Low-Boom/PiEBV/tools/jlc_cpl/rot_report.txt

C1   C49678     C_0805_2012Metric_Pad1.18x1.45mm_Han JLC "C0805" | corr   0 | rot 0 -> 0 | shift 0.000 mm | fit 0.038 mm
C2   C49678     C_0805_2012Metric_Pad1.18x1.45mm_Han JLC "C0805" | corr   0 | rot 0 -> 0 | shift 0.000 mm | fit 0.038 mm
C3   C49678     C_0805_2012Metric_Pad1.18x1.45mm_Han JLC "C0805" | corr   0 | rot 0 -> 0 | shift 0.000 mm | fit 0.038 mm
C4   C49678     C_0805_2012Metric_Pad1.18x1.45mm_Han JLC "C0805" | corr   0 | rot 180 -> 180 | shift 0.000 mm | fit 0.038 mm
C5   C49678     C_0805_2012Metric_Pad1.18x1.45mm_Han JLC "C0805" | corr   0 | rot 180 -> 180 | shift 0.000 mm | fit 0.038 mm
C6   C28323     C_0805_2012Metric_Pad1.18x1.45mm_Han JLC "C0805" | corr   0 | rot 270 -> 270 | shift 0.000 mm | fit 0.038 mm
C7   C28234     C_0805_2012Metric_Pad1.18x1.45mm_Han JLC "C0805" | corr   0 | rot 270 -> 270 | shift 0.000 mm | fit 0.038 mm
C9   C49678     C_0805_2012Metric_Pad1.18x1.45mm_Han JLC "C0805" | corr   0 | rot 180 -> 180 | shift 0.000 mm | fit 0.038 mm
C10  C89632     C_1206_3216Metric_Pad1.33x1.80mm_Han JLC "C1206" | corr   0 | rot 90 -> 90 | shift 0.000 mm | fit 0.030 mm
C11  C28323     C_0805_2012Metric_Pad1.18x1.45mm_Han JLC "C0805" | corr   0 | rot 90 -> 90 | shift 0.000 mm | fit 0.038 mm
C12  C89632     C_1206_3216Metric_Pad1.33x1.80mm_Han JLC "C1206" | corr   0 | rot 0 -> 0 | shift 0.000 mm | fit 0.030 mm
C13  C49678     C_0805_2012Metric_Pad1.18x1.45mm_Han JLC "C0805" | corr   0 | rot 0 -> 0 | shift 0.000 mm | fit 0.038 mm
C14  C45783     C_0805_2012Metric_Pad1.18x1.45mm_Han JLC "C0805" | corr   0 | rot 270 -> 270 | shift 0.000 mm | fit 0.038 mm
C15  C45783     C_0805_2012Metric_Pad1.18x1.45mm_Han JLC "C0805" | corr   0 | rot 270 -> 270 | shift 0.000 mm | fit 0.038 mm
C16  C28323     C_0805_2012Metric_Pad1.18x1.45mm_Han JLC "C0805" | corr   0 | rot 270 -> 270 | shift 0.000 mm | fit 0.038 mm
C17  C89632     C_1206_3216Metric_Pad1.33x1.80mm_Han JLC "C1206" | corr   0 | rot 180 -> 180 | shift 0.000 mm | fit 0.030 mm
C18  C1729      C_0805_2012Metric_Pad1.18x1.45mm_Han JLC "C0805" | corr   0 | rot 270 -> 270 | shift 0.000 mm | fit 0.038 mm
C19  C1710      C_0805_2012Metric_Pad1.18x1.45mm_Han JLC "C0805" | corr   0 | rot 0 -> 0 | shift 0.000 mm | fit 0.038 mm
C20  C49678     C_0805_2012Metric_Pad1.18x1.45mm_Han JLC "C0805" | corr   0 | rot 180 -> 180 | shift 0.000 mm | fit 0.038 mm
J1   C5665      IDC-Header_2x05_P2.54mm_Vertical     JLC "IDC-TH_10P-P2.54_C5665" | corr 270 | rot 270 -> 270 | shift 5.236 mm | fit 0.000 mm
J2   C5665      IDC-Header_2x05_P2.54mm_Vertical     JLC "IDC-TH_10P-P2.54_C5665" | corr 270 | rot 270 -> 270 | shift 5.236 mm | fit 0.000 mm
J3   C5665      IDC-Header_2x05_P2.54mm_Vertical     JLC "IDC-TH_10P-P2.54_C5665" | corr 270 | rot 270 -> 270 | shift 5.236 mm | fit 0.000 mm
J4   C5665      IDC-Header_2x05_P2.54mm_Vertical     JLC "IDC-TH_10P-P2.54_C5665" | corr 270 | rot 270 -> 270 | shift 5.236 mm | fit 0.000 mm
J5   C5665      IDC-Header_2x05_P2.54mm_Vertical     JLC "IDC-TH_10P-P2.54_C5665" | corr 270 | rot 270 -> 270 | shift 5.236 mm | fit 0.000 mm
J6   C5665      IDC-Header_2x05_P2.54mm_Vertical     JLC "IDC-TH_10P-P2.54_C5665" | corr 270 | rot 270 -> 270 | shift 5.236 mm | fit 0.000 mm
J7   C2837587   BNC_Kinghelm_KH-BNC50-3511_Horizonta JLC "ANT-TH_KH-BNC50-3511" | corr 180 | rot 90 -> 90 | shift 2.525 mm | fit 0.042 mm | matched by geometry (pad numbers differ)
J8   C2837587   BNC_Kinghelm_KH-BNC50-3511_Horizonta JLC "ANT-TH_KH-BNC50-3511" | corr 180 | rot 90 -> 90 | shift 2.525 mm | fit 0.042 mm | matched by geometry (pad numbers differ)
J10  C49257     PinHeader_1x03_P2.54mm_Vertical      JLC "?" | corr 270 | rot 0 -> 0 | shift 2.540 mm | fit 0.000 mm
J11  C49257     PinHeader_1x03_P2.54mm_Vertical      JLC "?" | corr 270 | rot 0 -> 0 | shift 2.540 mm | fit 0.000 mm
J12  C2837587   BNC_Kinghelm_KH-BNC50-3511_Horizonta JLC "ANT-TH_KH-BNC50-3511" | corr 180 | rot 90 -> 90 | shift 2.525 mm | fit 0.042 mm | matched by geometry (pad numbers differ)
J14  C2905423   PinSocket_1x20_P2.54mm_Vertical      JLC "HDR-TH_20P-P2.54-V-F-2" | corr 270 | rot 0 -> 0 | shift 24.130 mm | fit 0.000 mm
J15  C2905423   PinSocket_1x20_P2.54mm_Vertical      JLC "HDR-TH_20P-P2.54-V-F-2" | corr 270 | rot 0 -> 0 | shift 24.130 mm | fit 0.000 mm
J17  C283540    USB_C_Receptacle_HRO_TYPE-C-31-M-17_ JLC "USB-C-SMD_10P-P1.00-L6.8-W8.9" | corr   0 | rot 270 -> 270 | shift 1.178 mm | fit 0.072 mm
J18  C49257     PinHeader_1x03_P2.54mm_Vertical      JLC "?" | corr 270 | rot 270 -> 270 | shift 2.540 mm | fit 0.000 mm
J19  C49257     PinHeader_1x03_P2.54mm_Vertical      JLC "?" | corr 270 | rot 90 -> 90 | shift 2.540 mm | fit 0.000 mm
J20  C32713268  PinHeader_1x02_P2.54mm_Vertical      JLC "HDR-TH_2P-P2.54-V-M-3" | corr 270 | rot 90 -> 90 | shift 1.270 mm | fit 0.000 mm
L1   C354587    L_Cenker_CKCS4030                    JLC "IND-SMD_L4.0-W4.0" | corr   0 | rot 0 -> 0 | shift 0.000 mm | fit 0.250 mm  << CHECK
R2   C26010     R_0805_2012Metric_Pad1.20x1.40mm_Han JLC "R0805" | corr   0 | rot 0 -> 0 | shift 0.000 mm | fit 0.000 mm
R3   C26010     R_0805_2012Metric_Pad1.20x1.40mm_Han JLC "R0805" | corr   0 | rot 0 -> 0 | shift 0.000 mm | fit 0.000 mm
R6   C2793964   R_2512_6332Metric_Pad1.40x3.35mm_Han JLC "R2512" | corr   0 | rot 0 -> 0 | shift 0.000 mm | fit 0.016 mm
R7   C2793964   R_2512_6332Metric_Pad1.40x3.35mm_Han JLC "R2512" | corr   0 | rot 0 -> 0 | shift 0.000 mm | fit 0.016 mm
R8   C17414     R_0805_2012Metric_Pad1.20x1.40mm_Han JLC "R0805" | corr   0 | rot 0 -> 0 | shift 0.000 mm | fit 0.000 mm
R9   C17414     R_0805_2012Metric_Pad1.20x1.40mm_Han JLC "R0805" | corr   0 | rot 0 -> 0 | shift 0.000 mm | fit 0.000 mm
R10  C17756     R_0805_2012Metric_Pad1.20x1.40mm_Han JLC "R0805" | corr   0 | rot 0 -> 0 | shift 0.000 mm | fit 0.000 mm
R12  C122537    R_0805_2012Metric_Pad1.20x1.40mm_Han JLC "R0805" | corr   0 | rot 90 -> 90 | shift 0.000 mm | fit 0.000 mm
R13  C706247    R_0805_2012Metric_Pad1.20x1.40mm_Han JLC "R0805" | corr   0 | rot 90 -> 90 | shift 0.000 mm | fit 0.000 mm
R16  C149504    R_0805_2012Metric_Pad1.20x1.40mm_Han JLC "R0805" | corr   0 | rot 270 -> 270 | shift 0.000 mm | fit 0.000 mm
R17  C17414     R_0805_2012Metric_Pad1.20x1.40mm_Han JLC "R0805" | corr   0 | rot 0 -> 0 | shift 0.000 mm | fit 0.000 mm
R18  C17414     R_0805_2012Metric_Pad1.20x1.40mm_Han JLC "R0805" | corr   0 | rot 0 -> 0 | shift 0.000 mm | fit 0.000 mm
R19  C17408     R_0805_2012Metric_Pad1.20x1.40mm_Han JLC "R0805" | corr   0 | rot 0 -> 0 | shift 0.000 mm | fit 0.000 mm
R20  C17818     R_0805_2012Metric_Pad1.20x1.40mm_Han JLC "R0805" | corr   0 | rot 270 -> 270 | shift 0.000 mm | fit 0.000 mm
R21  C17470     R_0805_2012Metric_Pad1.20x1.40mm_Han JLC "R0805" | corr   0 | rot 90 -> 90 | shift 0.000 mm | fit 0.000 mm
R22  C17379     R_0805_2012Metric_Pad1.20x1.40mm_Han JLC "R0805" | corr   0 | rot 90 -> 90 | shift 0.000 mm | fit 0.000 mm
R23  C17673     R_0805_2012Metric_Pad1.20x1.40mm_Han JLC "R0805" | corr   0 | rot 90 -> 90 | shift 0.000 mm | fit 0.000 mm
R24  C17414     R_0805_2012Metric_Pad1.20x1.40mm_Han JLC "R0805" | corr   0 | rot 0 -> 0 | shift 0.000 mm | fit 0.000 mm
R25  C7209419   R_2512_6332Metric_Pad1.40x3.35mm_Han no JLC footprint; chip passive, corr 0 | rot 0 -> 0
R26  C7209419   R_2512_6332Metric_Pad1.40x3.35mm_Han no JLC footprint; chip passive, corr 0 | rot 0 -> 0
R27  C7468298   R_2512_6332Metric_Pad1.40x3.35mm_Han JLC "R2512" | corr   0 | rot 180 -> 180 | shift 0.000 mm | fit 0.016 mm
R28  C7468298   R_2512_6332Metric_Pad1.40x3.35mm_Han JLC "R2512" | corr   0 | rot 180 -> 180 | shift 0.000 mm | fit 0.016 mm
R29  C17513     R_0805_2012Metric_Pad1.20x1.40mm_Han JLC "R0805" | corr   0 | rot 0 -> 0 | shift 0.000 mm | fit 0.000 mm
TP3  C32713261  PinHeader_1x02_P2.54mm_Horizontal_Ed JLC "?" | corr  90 | rot 270 -> 270 | shift 1.270 mm | fit 0.000 mm | symmetric, also fits 270 | matched by geometry (pad numbers differ) | body-matched (JLC pin numbering mirrored vs body; header pins are identical)
U1   C7827      SOT-23-5_HandSoldering               JLC "SOT-23-5_L3.0-W1.7-P0.95-LS2.8-BR" | corr 180 | rot 180 -> 180 | shift 0.010 mm | fit 0.060 mm
U2   C485074    SOIC127P600X175-14N                  JLC "SOIC-14_L8.7-W3.9-P1.27-LS6.0-BL" | corr 270 | rot 270 -> 270 | shift 0.000 mm | fit 0.144 mm
U3   C7826      SOT-23-5_HandSoldering               JLC "SOT-23-5_L3.0-W1.7-P0.95-LS2.8-BR" | corr 180 | rot 180 -> 180 | shift 0.010 mm | fit 0.060 mm
U4   C485074    SOIC127P600X175-14N                  JLC "SOIC-14_L8.7-W3.9-P1.27-LS6.0-BL" | corr 270 | rot 270 -> 270 | shift 0.000 mm | fit 0.144 mm
U5   C7827      SOT-23-5_HandSoldering               JLC "SOT-23-5_L3.0-W1.7-P0.95-LS2.8-BR" | corr 180 | rot 180 -> 180 | shift 0.010 mm | fit 0.060 mm
U6   C485074    SOIC127P600X175-14N                  JLC "SOIC-14_L8.7-W3.9-P1.27-LS6.0-BL" | corr 270 | rot 270 -> 270 | shift 0.000 mm | fit 0.144 mm
U7   C113521    SOT-23-5_HandSoldering               JLC "SOT-23-5_L3.0-W1.7-P0.95-LS2.8-BR" | corr 180 | rot 180 -> 180 | shift 0.010 mm | fit 0.060 mm
U8   C113521    SOT-23-5_HandSoldering               JLC "SOT-23-5_L3.0-W1.7-P0.95-LS2.8-BR" | corr 180 | rot 180 -> 180 | shift 0.010 mm | fit 0.060 mm
U9   C892792    SOT-23-5_HandSoldering               JLC "TSOT-23-5_L2.9-W1.6-P0.95-LS2.8-BL" | corr 270 | rot 270 -> 270 | shift 0.040 mm | fit 0.243 mm  << CHECK
U10  C113521    SOT-23-5_HandSoldering               JLC "SOT-23-5_L3.0-W1.7-P0.95-LS2.8-BR" | corr 180 | rot 180 -> 180 | shift 0.010 mm | fit 0.060 mm
U13  C465729    SOIC-8_3.9x4.9mm_P1.27mm             JLC "?" | corr 270 | rot 270 -> 270 | shift 0.000 mm | fit 0.125 mm
U14  C42459160  SSOP-10-1EP_3.9x4.9mm_P1mm_EP2.1x3.3 JLC "ESSOP-10_L4.9-W3.9-P1.0-LS6.0-TL-E" | corr 270 | rot 90 -> 90 | shift 0.000 mm | fit 0.363 mm  << CHECK
U15  C2071056   TSOT-23-6_HandSoldering              JLC "TSOT-23-6_L2.9-W1.6-P0.95-LS2.8-BL" | corr 270 | rot 270 -> 270 | shift 0.000 mm | fit 0.510 mm  << CHECK
U16  C2869734   SOT-363_SC-70-6                      JLC "SC-70-6_L2.0-W1.3-P0.65-LS2.1-BL" | corr 270 | rot 270 -> 270 | shift 0.000 mm | fit 0.263 mm  << CHECK
U17  C670156    MSOP-12-1EP_3x4.039mm_P0.65mm_EP1.65 JLC "MSOP-12_L4.0-W3.0-P0.65-LS5.0-BL-E" | corr 270 | rot 0 -> 0 | shift 0.000 mm | fit 0.025 mm
U18  C33002     SOT-23-6                             JLC "SOT-23-6_L2.9-W1.6-P0.95-LS2.8-BL" | corr 270 | rot 0 -> 0 | shift 0.000 mm | fit 0.012 mm
U19  C465729    SOIC-8_3.9x4.9mm_P1.27mm             JLC "?" | corr 270 | rot 270 -> 270 | shift 0.000 mm | fit 0.125 mm
C21  C49678     C_0805_2012Metric_Pad1.18x1.45mm_Han JLC "C0805" | corr   0 | rot 180 -> 180 | shift 0.000 mm | fit 0.038 mm
C22  C89632     C_1206_3216Metric_Pad1.33x1.80mm_Han JLC "C1206" | corr   0 | rot 90 -> 90 | shift 0.000 mm | fit 0.030 mm
R30  C2793964   R_2512_6332Metric_Pad1.40x3.35mm_Han JLC "R2512" | corr   0 | rot 0 -> 0 | shift 0.000 mm | fit 0.016 mm
R31  C7209419   R_2512_6332Metric_Pad1.40x3.35mm_Han no JLC footprint; chip passive, corr 0 | rot 0 -> 0
R32  C7468298   R_2512_6332Metric_Pad1.40x3.35mm_Han JLC "R2512" | corr   0 | rot 180 -> 180 | shift 0.000 mm | fit 0.016 mm
J21  C49257     PinHeader_1x03_P2.54mm_Vertical      JLC "?" | corr 270 | rot 270 -> 270 | shift 2.540 mm | fit 0.000 mm
C23  C28323     C_0805_2012Metric_Pad1.18x1.45mm_Han JLC "C0805" | corr   0 | rot 180 -> 180 | shift 0.000 mm | fit 0.038 mm
C24  C28323     C_0805_2012Metric_Pad1.18x1.45mm_Han JLC "C0805" | corr   0 | rot 270 -> 270 | shift 0.000 mm | fit 0.038 mm
C25  C49678     C_0805_2012Metric_Pad1.18x1.45mm_Han JLC "C0805" | corr   0 | rot 90 -> 90 | shift 0.000 mm | fit 0.038 mm
C26  C49678     C_0805_2012Metric_Pad1.18x1.45mm_Han JLC "C0805" | corr   0 | rot 0 -> 0 | shift 0.000 mm | fit 0.038 mm
C27  C49678     C_0805_2012Metric_Pad1.18x1.45mm_Han JLC "C0805" | corr   0 | rot 90 -> 90 | shift 0.000 mm | fit 0.038 mm
C28  C49678     C_0805_2012Metric_Pad1.18x1.45mm_Han JLC "C0805" | corr   0 | rot 0 -> 0 | shift 0.000 mm | fit 0.038 mm
C29  C49678     C_0805_2012Metric_Pad1.18x1.45mm_Han JLC "C0805" | corr   0 | rot 90 -> 90 | shift 0.000 mm | fit 0.038 mm
C30  C49678     C_0805_2012Metric_Pad1.18x1.45mm_Han JLC "C0805" | corr   0 | rot 0 -> 0 | shift 0.000 mm | fit 0.038 mm
C31  C1792      C_0805_2012Metric_Pad1.18x1.45mm_Han JLC "C0805" | corr   0 | rot 90 -> 90 | shift 0.000 mm | fit 0.038 mm
C32  C1804      C_0805_2012Metric_Pad1.18x1.45mm_Han JLC "C0805" | corr   0 | rot 270 -> 270 | shift 0.000 mm | fit 0.038 mm
C33  C1792      C_0805_2012Metric_Pad1.18x1.45mm_Han JLC "C0805" | corr   0 | rot 270 -> 270 | shift 0.000 mm | fit 0.038 mm
C34  C1804      C_0805_2012Metric_Pad1.18x1.45mm_Han JLC "C0805" | corr   0 | rot 90 -> 90 | shift 0.000 mm | fit 0.038 mm
C35  C1792      C_0805_2012Metric_Pad1.18x1.45mm_Han JLC "C0805" | corr   0 | rot 90 -> 90 | shift 0.000 mm | fit 0.038 mm
C36  C1804      C_0805_2012Metric_Pad1.18x1.45mm_Han JLC "C0805" | corr   0 | rot 90 -> 90 | shift 0.000 mm | fit 0.038 mm
D1   C2293      LED_0805_2012Metric_Pad1.15x1.40mm_H JLC "LED0805-R-RD" | corr 180 | rot 270 -> 90 | shift 0.000 mm | fit 0.025 mm
D2   C2297      LED_0805_2012Metric_Pad1.15x1.40mm_H JLC "LED0805-R-RD" | corr 180 | rot 180 -> 0 | shift 0.000 mm | fit 0.025 mm
D3   C84256     LED_0805_2012Metric_Pad1.15x1.40mm_H JLC "LED0805-RD" | corr   0 | rot 0 -> 0 | shift 0.000 mm | fit 0.075 mm
D4   C84256     LED_0805_2012Metric_Pad1.15x1.40mm_H JLC "LED0805-RD" | corr   0 | rot 0 -> 0 | shift 0.000 mm | fit 0.075 mm
D5   C84256     LED_0805_2012Metric_Pad1.15x1.40mm_H JLC "LED0805-RD" | corr   0 | rot 0 -> 0 | shift 0.000 mm | fit 0.075 mm
D6   C2296      LED_0805_2012Metric_Pad1.15x1.40mm_H JLC "LED0805-R-RD" | corr 180 | rot 0 -> 180 | shift 0.000 mm | fit 0.025 mm
J22  C32713268  PinHeader_1x02_P2.54mm_Vertical      JLC "HDR-TH_2P-P2.54-V-M-3" | corr 270 | rot 270 -> 270 | shift 1.270 mm | fit 0.000 mm
Q1   C8545      SOT-23                               JLC "SOT-23-3_L2.9-W1.3-P1.90-LS2.4-BR" | corr 180 | rot 90 -> 270 | shift 0.021 mm | fit 0.083 mm
Q2   C8545      SOT-23                               JLC "SOT-23-3_L2.9-W1.3-P1.90-LS2.4-BR" | corr 180 | rot 90 -> 270 | shift 0.021 mm | fit 0.083 mm
R33  C17408     R_0805_2012Metric_Pad1.20x1.40mm_Han JLC "R0805" | corr   0 | rot 90 -> 90 | shift 0.000 mm | fit 0.000 mm
R34  C17414     R_0805_2012Metric_Pad1.20x1.40mm_Han JLC "R0805" | corr   0 | rot 0 -> 0 | shift 0.000 mm | fit 0.000 mm
R35  C17513     R_0805_2012Metric_Pad1.20x1.40mm_Han JLC "R0805" | corr   0 | rot 180 -> 180 | shift 0.000 mm | fit 0.000 mm
R36  C17513     R_0805_2012Metric_Pad1.20x1.40mm_Han JLC "R0805" | corr   0 | rot 90 -> 90 | shift 0.000 mm | fit 0.000 mm
R37  C17513     R_0805_2012Metric_Pad1.20x1.40mm_Han JLC "R0805" | corr   0 | rot 90 -> 90 | shift 0.000 mm | fit 0.000 mm
R38  C149504    R_0805_2012Metric_Pad1.20x1.40mm_Han JLC "R0805" | corr   0 | rot 270 -> 270 | shift 0.000 mm | fit 0.000 mm
R39  C17414     R_0805_2012Metric_Pad1.20x1.40mm_Han JLC "R0805" | corr   0 | rot 90 -> 90 | shift 0.000 mm | fit 0.000 mm
R40  C17673     R_0805_2012Metric_Pad1.20x1.40mm_Han JLC "R0805" | corr   0 | rot 270 -> 270 | shift 0.000 mm | fit 0.000 mm
R41  C17470     R_0805_2012Metric_Pad1.20x1.40mm_Han JLC "R0805" | corr   0 | rot 90 -> 90 | shift 0.000 mm | fit 0.000 mm
R42  C17818     R_0805_2012Metric_Pad1.20x1.40mm_Han JLC "R0805" | corr   0 | rot 0 -> 0 | shift 0.000 mm | fit 0.000 mm
R43  C17414     R_0805_2012Metric_Pad1.20x1.40mm_Han JLC "R0805" | corr   0 | rot 270 -> 270 | shift 0.000 mm | fit 0.000 mm
R44  C17673     R_0805_2012Metric_Pad1.20x1.40mm_Han JLC "R0805" | corr   0 | rot 90 -> 90 | shift 0.000 mm | fit 0.000 mm
R45  C17470     R_0805_2012Metric_Pad1.20x1.40mm_Han JLC "R0805" | corr   0 | rot 90 -> 90 | shift 0.000 mm | fit 0.000 mm
R46  C17818     R_0805_2012Metric_Pad1.20x1.40mm_Han JLC "R0805" | corr   0 | rot 0 -> 0 | shift 0.000 mm | fit 0.000 mm
R47  C17414     R_0805_2012Metric_Pad1.20x1.40mm_Han JLC "R0805" | corr   0 | rot 90 -> 90 | shift 0.000 mm | fit 0.000 mm
R48  C17673     R_0805_2012Metric_Pad1.20x1.40mm_Han JLC "R0805" | corr   0 | rot 90 -> 90 | shift 0.000 mm | fit 0.000 mm
R49  C17470     R_0805_2012Metric_Pad1.20x1.40mm_Han JLC "R0805" | corr   0 | rot 90 -> 90 | shift 0.000 mm | fit 0.000 mm
R50  C17818     R_0805_2012Metric_Pad1.20x1.40mm_Han JLC "R0805" | corr   0 | rot 0 -> 0 | shift 0.000 mm | fit 0.000 mm
R51  C17673     R_0805_2012Metric_Pad1.20x1.40mm_Han JLC "R0805" | corr   0 | rot 0 -> 0 | shift 0.000 mm | fit 0.000 mm
R52  C17714     R_0805_2012Metric_Pad1.20x1.40mm_Han JLC "R0805" | corr   0 | rot 90 -> 90 | shift 0.000 mm | fit 0.000 mm
R53  C17714     R_0805_2012Metric_Pad1.20x1.40mm_Han JLC "R0805" | corr   0 | rot 90 -> 90 | shift 0.000 mm | fit 0.000 mm
R54  C17714     R_0805_2012Metric_Pad1.20x1.40mm_Han JLC "R0805" | corr   0 | rot 90 -> 90 | shift 0.000 mm | fit 0.000 mm
R55  C17714     R_0805_2012Metric_Pad1.20x1.40mm_Han JLC "R0805" | corr   0 | rot 90 -> 90 | shift 0.000 mm | fit 0.000 mm
R56  C17714     R_0805_2012Metric_Pad1.20x1.40mm_Han JLC "R0805" | corr   0 | rot 90 -> 90 | shift 0.000 mm | fit 0.000 mm
R57  C17714     R_0805_2012Metric_Pad1.20x1.40mm_Han JLC "R0805" | corr   0 | rot 90 -> 90 | shift 0.000 mm | fit 0.000 mm
R58  C17714     R_0805_2012Metric_Pad1.20x1.40mm_Han JLC "R0805" | corr   0 | rot 90 -> 90 | shift 0.000 mm | fit 0.000 mm
R59  C17714     R_0805_2012Metric_Pad1.20x1.40mm_Han JLC "R0805" | corr   0 | rot 90 -> 90 | shift 0.000 mm | fit 0.000 mm
R60  C17714     R_0805_2012Metric_Pad1.20x1.40mm_Han JLC "R0805" | corr   0 | rot 90 -> 90 | shift 0.000 mm | fit 0.000 mm
R61  C17714     R_0805_2012Metric_Pad1.20x1.40mm_Han JLC "R0805" | corr   0 | rot 90 -> 90 | shift 0.000 mm | fit 0.000 mm
R62  C17714     R_0805_2012Metric_Pad1.20x1.40mm_Han JLC "R0805" | corr   0 | rot 90 -> 90 | shift 0.000 mm | fit 0.000 mm
R63  C17714     R_0805_2012Metric_Pad1.20x1.40mm_Han JLC "R0805" | corr   0 | rot 90 -> 90 | shift 0.000 mm | fit 0.000 mm
R64  C17714     R_0805_2012Metric_Pad1.20x1.40mm_Han JLC "R0805" | corr   0 | rot 270 -> 270 | shift 0.000 mm | fit 0.000 mm
R65  C17714     R_0805_2012Metric_Pad1.20x1.40mm_Han JLC "R0805" | corr   0 | rot 270 -> 270 | shift 0.000 mm | fit 0.000 mm
R66  C17714     R_0805_2012Metric_Pad1.20x1.40mm_Han JLC "R0805" | corr   0 | rot 270 -> 270 | shift 0.000 mm | fit 0.000 mm
R67  C17714     R_0805_2012Metric_Pad1.20x1.40mm_Han JLC "R0805" | corr   0 | rot 270 -> 270 | shift 0.000 mm | fit 0.000 mm
R68  C17714     R_0805_2012Metric_Pad1.20x1.40mm_Han JLC "R0805" | corr   0 | rot 270 -> 270 | shift 0.000 mm | fit 0.000 mm
R69  C17714     R_0805_2012Metric_Pad1.20x1.40mm_Han JLC "R0805" | corr   0 | rot 270 -> 270 | shift 0.000 mm | fit 0.000 mm
R70  C17414     R_0805_2012Metric_Pad1.20x1.40mm_Han JLC "R0805" | corr   0 | rot 0 -> 0 | shift 0.000 mm | fit 0.000 mm
U20  C3235557   SOT-583-8                            JLC "SOT-583-8_L2.1-W1.6-P0.50-LS1.6-BL" | corr 270 | rot 180 -> 90 | shift 0.000 mm | fit 0.100 mm
U21  C123302    SSOP-8_2.95x2.8mm_P0.65mm            JLC "SM8_L3.2-W2.9-P0.65-LS4.3-BR" | corr 180 | rot 180 -> 0 | shift 0.000 mm | fit 0.099 mm
U22  C123302    SSOP-8_2.95x2.8mm_P0.65mm            JLC "SM8_L3.2-W2.9-P0.65-LS4.3-BR" | corr 180 | rot 180 -> 0 | shift 0.000 mm | fit 0.099 mm
U23  C123302    SSOP-8_2.95x2.8mm_P0.65mm            JLC "SM8_L3.2-W2.9-P0.65-LS4.3-BR" | corr 180 | rot 180 -> 0 | shift 0.000 mm | fit 0.099 mm
