Low-Boom/PiEBV/fab/PiEBV_Pico_BOM.csv

Reference | Value | Footprint | Qty | DNP | LCSC
C1-C5,C9,C13,C20,C21,C25-C30 | 0.1uF 50V X7R | Capacitor_SMD:C_0805_2012Metric_Pad1.18x1.45mm_HandSolder | 15 |  | C49678
C6,C11,C16,C23,C24 | 1uF 50V X7R | Capacitor_SMD:C_0805_2012Metric_Pad1.18x1.45mm_HandSolder | 5 |  | C28323
C7 | 2.2uF 16V X7R | Capacitor_SMD:C_0805_2012Metric_Pad1.18x1.45mm_HandSolder | 1 |  | C28234
C10,C12,C17,C22 | 10uF 50V X7R | Capacitor_SMD:C_1206_3216Metric_Pad1.33x1.80mm_HandSolder | 4 |  | C89632
C14,C15 | 22uF 25V X5R | Capacitor_SMD:C_0805_2012Metric_Pad1.18x1.45mm_HandSolder | 2 |  | C45783
C18 | 22nF 50V X7R | Capacitor_SMD:C_0805_2012Metric_Pad1.18x1.45mm_HandSolder | 1 |  | C1729
C19 | 10nF 50V X7R | Capacitor_SMD:C_0805_2012Metric_Pad1.18x1.45mm_HandSolder | 1 |  | C1710
C31,C33,C35 | 12pF 50V C0G (sense divider compensation, upper) | Capacitor_SMD:C_0805_2012Metric_Pad1.18x1.45mm_HandSolder | 3 |  | C1792
C32,C34,C36 | 22pF 50V C0G (sense divider compensation, lower) | Capacitor_SMD:C_0805_2012Metric_Pad1.18x1.45mm_HandSolder | 3 |  | C1804
L1 | 4.7uH, Isat >= 1.5 A | Inductor_SMD:L_Cenker_CKCS4030 | 1 |  | C354587
R2,R3 | 3k3 | Resistor_SMD:R_0805_2012Metric_Pad1.20x1.40mm_HandSolder | 2 |  | C26010
R6,R7,R30 | 68 1% 2W | Resistor_SMD:R_2512_6332Metric_Pad1.40x3.35mm_HandSolder | 3 |  | C2793964
R25,R26,R31 | 47 1% 2W (Hi-Z mode series: lasers, ext sync) | Resistor_SMD:R_2512_6332Metric_Pad1.40x3.35mm_HandSolder | 3 |  | C7209419
R27,R28,R32 | 82 1% 2W (Hi-Z mode shunt: lasers, ext sync) | Resistor_SMD:R_2512_6332Metric_Pad1.40x3.35mm_HandSolder | 3 |  | C7468298
R8,R9,R17,R18,R24,R34,R39,R43,R47,R70 | 10k | Resistor_SMD:R_0805_2012Metric_Pad1.20x1.40mm_HandSolder | 10 |  | C17414
R10 | 56k | Resistor_SMD:R_0805_2012Metric_Pad1.20x1.40mm_HandSolder | 1 |  | C17756
R12 | 100k 0.1% | Resistor_SMD:R_0805_2012Metric_Pad1.20x1.40mm_HandSolder | 1 |  | C122537
R13 | 5.36k 0.1% | Resistor_SMD:R_0805_2012Metric_Pad1.20x1.40mm_HandSolder | 1 |  | C706247
R16,R38 | 100k | Resistor_SMD:R_0805_2012Metric_Pad1.20x1.40mm_HandSolder | 2 |  | C149504
R19,R33 | 100 | Resistor_SMD:R_0805_2012Metric_Pad1.20x1.40mm_HandSolder | 2 |  | C17408
R20,R42,R46,R50 | 750 1% | Resistor_SMD:R_0805_2012Metric_Pad1.20x1.40mm_HandSolder | 4 |  | C17818
R21,R41,R45,R49 | 150k 1% | Resistor_SMD:R_0805_2012Metric_Pad1.20x1.40mm_HandSolder | 4 |  | C17470
R22 | 1.2k 1% | Resistor_SMD:R_0805_2012Metric_Pad1.20x1.40mm_HandSolder | 1 |  | C17379
R23,R40,R44,R48,R51 | 4.7k 1% | Resistor_SMD:R_0805_2012Metric_Pad1.20x1.40mm_HandSolder | 5 |  | C17673
R52-R69 | 47 1% (camera line series termination) | Resistor_SMD:R_0805_2012Metric_Pad1.20x1.40mm_HandSolder | 18 |  | C17714
R29,R35,R36,R37 | 1k (R29 clock jumper series; R35 J22 series; R36, R37 LED series) | Resistor_SMD:R_0805_2012Metric_Pad1.20x1.40mm_HandSolder | 4 |  | C17513
U1,U5 | 74LVC1G04 | Package_TO_SOT_SMD:SOT-23-5_HandSoldering | 2 |  | C7827
U3 | 74LVC1G00 (SN74LVC1G00DBVR, pixel-reset inverter: both inputs on PIXRST_GATE) | Package_TO_SOT_SMD:SOT-23-5_HandSoldering | 1 |  | C7826
U2,U4,U6 | SN74LVC04AD | SN74LVC04AD:SOIC127P600X175-14N | 3 |  | C485074
U7,U8,U10 | 74AHCT1G08 | Package_TO_SOT_SMD:SOT-23-5_HandSoldering | 3 |  | C113521
U9 | NCP718xSN180 | Package_TO_SOT_SMD:SOT-23-5_HandSoldering | 1 |  | C892792
U13,U19 | UCC27524 | Package_SO:SOIC-8_3.9x4.9mm_P1.27mm | 2 |  | C465729
U14 | CH224A | Package_SO:SSOP-10-1EP_3.9x4.9mm_P1mm_EP2.1x3.3mm | 1 |  | C42459160
U15 | AP63205WU | Package_TO_SOT_SMD:TSOT-23-6_HandSoldering | 1 |  | C2071056
U16 | LM66100DCK | Package_TO_SOT_SMD:SOT-363_SC-70-6 | 1 |  | C2869734
U17 | LT3065EMSE#PBF (Analog Devices, adjustable, MSOP-12 with exposed pad) | Package_SO:MSOP-12-1EP_3x4.039mm_P0.65mm_EP1.651x2.845mm | 1 |  | C670156
U18 | TPS3700DDCR | Package_TO_SOT_SMD:SOT-23-6 | 1 |  | C33002
U20 | TPS2116DRLR (TI power mux, SOT-583; +VCAM = +1V8 or +3V3) | Package_TO_SOT_SMD:SOT-583-8 | 1 |  | C3235557
U21-U23 | SN74LVC1G123DCTR (TI monostable, SSOP-8 / SM8; activity LED pulse stretchers) | Package_SO:SSOP-8_2.95x2.8mm_P0.65mm | 3 |  | C123302
Q1,Q2 | 2N7002 (N-MOSFET, SOT-23; status LED switches) | Package_TO_SOT_SMD:SOT-23 | 2 |  | C8545
D1 | LED blue 0805 (KT-0805B; 3.3 V camera I/O indicator: must be a blue or white InGaN LED, Vf > 2.5 V) | LED_SMD:LED_0805_2012Metric_Pad1.15x1.40mm_HandSolder | 1 |  | C2293
D2 | LED green 0805 (KT-0805G; 12 V good) | LED_SMD:LED_0805_2012Metric_Pad1.15x1.40mm_HandSolder | 1 |  | C2297
D3,D4,D5 | LED red 0805 (NCD0805R1; ARMED, Laser 1 activity, Laser 2 activity) | LED_SMD:LED_0805_2012Metric_Pad1.15x1.40mm_HandSolder | 3 |  | C84256
D6 | LED yellow 0805 (External Sync Out activity) | LED_SMD:LED_0805_2012Metric_Pad1.15x1.40mm_HandSolder | 1 |  | C2296
J1-J6 | Conn_02x05_Odd_Even | Connector_IDC:IDC-Header_2x05_P2.54mm_Vertical | 6 |  | C5665
J7,J8,J12 | BNC 50R Kinghelm KH-BNC50-3511 (Laser 1 / Laser 2 / Ext Sync Out) | PiEBV_Local:BNC_Kinghelm_KH-BNC50-3511_Horizontal | 3 |  | C2837587
J10,J11,J18,J19,J21 | Header 1x03 (J10 trigger select / J11 laser enable / J18, J19 laser output mode / J21 ext sync output mode) | Connector_PinHeader_2.54mm:PinHeader_1x03_P2.54mm_Vertical | 5 |  | C49257
(loose) | Jumper shunt, 2.54 mm 2-pin | - | 7 | Not placed on the board - fit J10 on 2-3, J11 on 1-2 (lasers enabled), J18, J19 and J21 on 1-2 (50 ohm outputs) by hand; keep the sixth shunt loose: J20 stays open (150 MHz) unless that Pico has passed the soak test. J22 stays open (1.8 V camera I/O, IDS); fit the seventh shunt on J22 only for Prophesee EVK4 cameras (3.3 V), with no 1.8 V camera connected. | C100114
J17 | USB-C receptacle 6P power only (HRO TYPE-C-31-M-17) | PiEBV_Local:USB_C_Receptacle_HRO_TYPE-C-31-M-17_EdgeTrim | 1 |  | C283540
TP3 | Header 1x02 right-angle (1MHz sync + GND) | PiEBV_Local:PinHeader_1x02_P2.54mm_Horizontal_EdgeTrim | 1 |  | C32713261
J20,J22 | Header 1x02 (J20 clock jumper: CLK_SEL_JMP + GND; J22 camera I/O level: fitted = 3.3 V) | Connector_PinHeader_2.54mm:PinHeader_1x02_P2.54mm_Vertical | 2 |  | C32713268
J14,J15 | Pico Socket A/B | Connector_PinSocket_2.54mm:PinSocket_1x20_P2.54mm_Vertical | 2 |  | C2905423
U11 | Raspberry Pi Pico 2 W | (no PCB footprint - plugs into J14/J15) | 1 | DNP - socket-mounted, do not place; source module separately
MH1-MH4 | M3 mounting hole | MountingHole:MountingHole_3.2mm_M3 | 4 | Mechanical only - NPTH, nothing to place
TP4-TP9 | Test pad 1.5 mm (+12V, +5V, +3V3, +1V8, +VCAM, GND) | TestPoint:TestPoint_Pad_D1.5mm | 6 | Bare copper pads - no part, nothing to place
NOTE | U9 must be the FIXED 1.8 V NCP718 (NCP718xSN180, e.g. NCP718BSN180T1G or NCP718ASN180T1G) | Sets the camera I/O level. The IDS UE-39B0XCP-E I/O pins are 1.8 V sensor-level; do not substitute a 1.65 V, 1.7 V or 3.3 V option. Rev 2: U9 feeds U20 (VIN2); the 3.3 V level for Prophesee EVK4 comes from the Pico 3V3_OUT through U20 when J22 is fitted.
NOTE | C6 is on +5V, C7 on +1V8 - use X7R, C6 rated >= 10 V | NCP718 needs >= 1 uF ceramic on its output for stability; C7 = 2.2 uF gives margin after DC-bias derating.
NOTE | TP3/J17 use PiEBV_Local *_EdgeTrim footprint variants | Identical part and pad geometry to the stock footprints; only the silkscreen is clipped where the connector reaches the board edge. Order the standard parts.
NOTE | R8 is a fail-safe interlock pull-down | Holds U10 pin 1 low when no jumper is fitted on J11, so the lasers default to DISABLED. R2 (3k3) still wins when the J11 1-2 jumper is fitted.
NOTE | R9 is the J10 trigger-select pull-down | Holds PWM_TRIG_TAP (U5 input) low when no shunt is fitted on J10, so all six camera trigger lines idle low instead of floating.
NOTE | U7/U8/U10 must be AHCT (TTL-input) parts, not LVC | At VCC = 5 V an LVC input needs 0.7 x VCC = 3.5 V to read high; the Pico drives these from 3.3 V GPIOs. AHCT reads high above 2.0 V.
NOTE | R10 = 56k sets the USB PD request to 15 V | CH224A CFG1 table (datasheet Table 5-1): 6k8 = 9 V, 24k = 12 V, 56k = 15 V, 120k = 20 V, 210k = 28 V. Do not leave R10 off - an open CFG1 is outside the table. The laser outputs need a charger that offers 15 V (any USB-PD charger rated over 27 W).
NOTE | U14 must be the CH224A (not the CH224K) | CH224A pin 1 (VHV) and pin 8 (VBUS) connect directly to VBUS_PD by copper, as the WCH CH224K-to-CH224A guide (datasheet 7.2.1) requires; R11/R15 of the CH224K design were removed. Do not fit a CH224K: it is discontinued, and its pin 1 is a 3.6 V VDD pin that VBUS_PD would destroy.
NOTE | R12/R13 must be 0.1 % parts; R6/R7/R30 1 % | They set the 11.8 V driver rail and hence the LDP-V trigger and ext sync amplitude (4.54-5.14 V into 50 ohm with U13/U19 ROH 0-8.5 ohm, window 4.5-5.2 V). With 1 % divider resistors the worst-case corners fall outside the window.
NOTE | U17 must be the ADJUSTABLE LT3065 (LT3065EMSE), not a fixed LT3065-x | R12/R13 (100k/5.36k) set 11.8 V from the 600 mV ADJ reference. R20 (750 ohm) sets a 400 mA current limit and C18 (22 nF) on IMAX is required by the datasheet. Solder the exposed pad (two GND vias under it). By hand: hot air or a hot plate; the vias are tented, so solder cannot be fed through them.
NOTE | C9, C10, C17, C21, C22 see 12 V; C11, C12, C16 see up to 20 V | Use >= 25 V parts for C9/C10/C17/C21/C22 and >= 50 V for C11/C12/C16 (X7R). C12 is the only large cap on VBUS_PD (C11 and C16 are 1 uF each): keep total VBUS capacitance near the USB-C 10 uF sink limit.
NOTE | U16 CE is tied to its VOUT (+5V) | That is TI's always-on reverse-blocking connection. With CE grounded the LM66100 does NOT block reverse current.
NOTE | R17/R18 hold the laser pulse inputs low when the Pico is removed | J17 can power the board with no Pico fitted; without these, U7/U8 inputs would float and an armed interlock could pass spurious laser triggers.
NOTE | R19 (100 ohm) isolates J10 pin 1 from the CH1 laser pulse | With J10 on 1-2 the CH1 GPIO would otherwise also drive the PWM_TRIG_TAP net (U5, R9, U19, ~59 mm; simulated at its earlier ~120 mm: 0.4-1.7 ns later than CH2). Do not replace with 0 ohm.
NOTE | C14/C15 must keep >= 10 uF each at 5 V DC bias | 22 uF 10 V 0805 X5R parts typically keep only 40-50 % at 5 V; 25 V-rated parts keep more. Check the chosen part's DC-bias curve.
NOTE | C9 / C21 (0.1 uF, 50 V) are the local VDD bypass of U13 / U19 | Each sits right beside its driver's pin 6 with its own GND via; keep them populated and next to the drivers.
NOTE | R6/R7/R30 are 2 W 2512 parts (68 ohm 1 %) | An output high into 50 ohm dissipates at most 0.71 W in its resistor (1.45 W at the firmware's worst duty into a shorted BNC). Do not substitute a smaller package.
NOTE | J7/J8/J12 are Kinghelm KH-BNC50-3511 | Footprint PiEBV_Local:BNC_Kinghelm_KH-BNC50-3511_Horizontal: the Amphenol B6252HB-NPP3G-50 pad pattern, which the Kinghelm drawing matches within 0.04 mm (pad 1 = centre contact, pad 2 and posts = GND). 50 ohm only - never the KH-BNC75-3511. Before release, test-fit two loose parts (holes 1.0 mm pins / 2.2 mm posts, as JLC's own KH-BNC50-3511 footprint) and check shell-to-pad-2 continuity: the shell bond is one iron lead and the post housing is PBT plastic.
NOTE | U18 (TPS3700) is the 12 V power-good gate | OUTA/OUTB (LASER_PWR_OK) hold U13 ENA/ENB and U19 ENA/ENB low unless +12V is inside 10.6-13.3 V (R21/R22/R23 = 150k/1.2k/4.7k 1 %, worst case UV trip 10.03-10.78 V and release <= 10.89 V, OV 12.88-13.67 V; at least 0.65 V and 0.82 V outside the 11.54-12.05 V rail band). U17's own PWRGD can only sink 50 uA and is left unconnected.
NOTE | U3 (74LVC1G00) has both inputs on PIXRST_GATE; R24 (10k) pulls the gate to +3V3 | U3 pins 1 and 2 are joined on the board, so U3 inverts the Pico gate (GP16) and through U4 the cameras get TDRSTN = PIXRST_GATE: only the Pico resets the camera pixels. R24 holds the gate high (no reset) whenever the Pico is not driving it.
NOTE | J18/J19/J21 set the output mode of Laser 1 / Laser 2 / Ext Sync Out; R25-R28, R31, R32 are 2 W 2512 parts | Shunt on 1-2 = 50 ohm load (LDP-V), 4.54-5.14 V into 50 ohm. Shunt on 2-3 = Hi-Z load: 47 ohm series + 82 ohm shunt give 4.55-5.08 V open circuit from a ~50 ohm source. Worst case (output held high into a shorted BNC in Hi-Z mode) is 0.51 W in R25/R26/R31; R27/R28/R32 see at most 0.31 W. Do not substitute a smaller package.
NOTE | J20 is the clock jumper: pin 1 = CLK_SEL_JMP (through R29 1k to CLK_SEL = Pico GP10, J14 pad 14), pin 2 = GND | Shunt fitted = 300 MHz overclock, open = the rated 150 MHz; the firmware reads it at every start with the internal pull-up (a fitted shunt reads about 0.1 V through R29). R29 limits the current to about 3.3 mA if a program drives GP10 high while the shunt is fitted (firmware before the clock jumper used GP10 as the SYNC output). Ship and leave it open unless that Pico has passed the soak test (Hardware.md, Clock jumper). Do not add a capacitor on CLK_SEL: a slow rise could read as fitted.
NOTE | U19 drives the J12 Ext Sync Out BNC | U19 (UCC27524, channel A) copies the camera trigger (PWM_TRIG_TAP, set by J10) to J12 through R30 68 ohm and the J21 output-mode block, exactly as U13 drives Laser 1. It runs from +12V and is enabled by LASER_PWR_OK, so J12 is live only with a 15 V PD charger on J17. INB is tied to GND and OUTB is unused.
NOTE | U20 (TPS2116) selects the camera I/O supply +VCAM; J22 open = 1.8 V, J22 fitted = 3.3 V | VIN1 (pin 3) = +1V8 from U9; VIN2 (pin 6) and MODE (pin 5) = +3V3. PR1 (pin 4) threshold 1.0 V (0.92-1.08 V): R34 and R70 (10k each, in parallel) pull it up to +3V3, so the mux passes VIN1 = 1.8 V. A shunt on J22 pulls PR1 to 0.55 V through R35 (1k) and the mux passes VIN2 = 3.3 V. R51 (4.7k) discharges +VCAM.
NOTE | R34 and R70 (10k each) are the 1.8 V default of the camera I/O supply | Each one alone holds PR1 of U20 high. If both are missing or open, PR1 floats and the mux output is not defined. First-board check: +VCAM (TP8) = 1.8 V and D1 dark with J22 open, before an IDS camera is connected.
NOTE | D1 must be a blue (or white) InGaN LED | D1 + R33 (100 ohm) sit on +VCAM. A blue LED (Vf about 2.7-3.1 V) is dark at 1.8 V and lit at 3.3 V. A red, yellow or yellow-green LED (Vf about 1.8-2.1 V) glows at 1.8 V and makes the indicator useless.
NOTE | Q1/Q2, D2, D3: status LEDs | D2 (green) = +12 V in its window (Q1 on LASER_PWR_OK). D3 (red) = ARMED: LASER_EN -> R37 -> D3 -> Q2 (gate = GP17 ARMED_LED, R38 100k to GND) -> Q1, so it lights only with firmware ARMED and J11 closed and 12 V good. 2N7002: Vgs(th) <= 2.5 V, driven from 3.3 V (Q2) and 12 V (Q1, Vgs max 20 V).
NOTE | U21-U23 (74LVC1G123) are the output activity pulse stretchers | Supply +3V3 (VIH 2.0 V; inputs are 5.5 V tolerant). B input from the 12 V driver output through a compensated divider: 10k with 12 pF (C0G) on top, 4.7k with 22 pF (C0G) below: 3.7-3.9 V, 0.8 mA from the driver while its output is high. Keep the capacitor ratio (C_top / C_bot = R_bot / R_top within about 20 %, including about 6-10 pF of input and track capacitance in parallel with C_bot). 150k x 0.1 uF gives about 15 ms per pulse (nominal; not a timing reference). /A = GND, /CLR = +3V3. The timing capacitor is between Cext and Rext/Cext; Cext is not grounded on the board.
