Low-Boom/PiEBV/tools/signal_sim/results.md

# signal_sim results

Generated by `signal_sim.py` from `geometry.json` and `devices.json`. 169 ngspice runs, 11.9 M time points, 224 s. Maximum time step 2.5 ps; board runs shorter than 2.0 mm are lumped LC sections, longer runs are lossless T lines.

All times in ns, voltages in V. Many device values are estimates (see `devices.json` and the README); treat the typical columns as a model result, not a measurement.

## Checks against hand calculations

| quantity | hand calculation | hand | sim | sim - hand |
|---|---|---|---|---|
| J12 high into 50 ohm, high | VDD x 50 / (50 + R30 + ROH) | 5.135 | 5.135 | 0.000 |
| J12 high into 50 ohm, typ | VDD x 50 / (50 + R30 + ROH) | 4.793 | 4.791 | -0.002 |
| J12 high into 50 ohm, low | VDD x 50 / (50 + R30 + ROH) | 4.537 | 4.534 | -0.003 |
| J12 Hi-Z mode into 1 Mohm, high | VDD x Rp / (R30 + ROH + R31 + Rp) | 5.074 | 5.074 | 0.000 |
| J12 Hi-Z mode into 50 ohm, high | Thevenin VDD Rp/(Rs+Rx+Rp) behind (Rs+Rx) parallel Rp | 2.590 | 2.590 | 0.000 |
| J12 Hi-Z mode into 1 Mohm, typ | VDD x Rp / (R30 + ROH + R31 + Rp) | 4.786 | 4.784 | -0.002 |
| J12 Hi-Z mode into 50 ohm, typ | Thevenin VDD Rp/(Rs+Rx+Rp) behind (Rs+Rx) parallel Rp | 2.424 | 2.423 | -0.001 |
| J12 Hi-Z mode into 1 Mohm, low | VDD x Rp / (R30 + ROH + R31 + Rp) | 4.551 | 4.549 | -0.003 |
| J12 Hi-Z mode into 50 ohm, low | Thevenin VDD Rp/(Rs+Rx+Rp) behind (Rs+Rx) parallel Rp | 2.295 | 2.294 | -0.001 |
| J12 load 50 %: 3 m minus 1 m RG-58 | 2 m x 5.05 ns/m | 10.100 | 10.100 | 0.000 |
| first arrival J14.15 -> U5.2 (ideal step, no loads) | sum of run length x Td/mm + 2 via sqrt(LC) | 0.670 | 0.660 | -0.009 |
| first arrival J14.15 -> U19.2 (ideal step, no loads) | sum of run length x Td/mm + 2 via sqrt(LC) | 0.721 | 0.713 | -0.008 |
| U5 model tpd into 30 pF parallel 1 k (typ) | datasheet tpd (est typ 4.1 ns) | 4.100 | 4.100 | 0.000 |
| R30 power while high, 50 ohm mode into 50 ohm, high | VDD^2 x R30 / (ROH + R30 + RL)^2 | 0.710 | 0.710 | 0.000 |
| R30 power while high, 50 ohm mode into a short, high | VDD^2 x R30 / (ROH + R30 + RL)^2 | 2.156 | 2.156 | 0.000 |

Time-step check (typical corner, 4 mA slow): maximum step 2.5 ps against 1.25 ps.

| edge | J12 | J12 half step | difference | camera | camera half step | difference |
|---|---|---|---|---|---|---|
| rise | 21.5330 | 21.5330 | 0.0000 | 11.0280 | 11.0280 | 0.0000 |
| fall | 20.8737 | 20.8737 | 0.0000 | 11.3697 | 11.3698 | 0.0000 |

## Case 1: CH1 versus CH2 skew (R19 and J10)

GP12 and GP13 switch at the same instant t0. Skew = CH1 minus CH2 (positive: CH1 late). U7.2 / U8.2: crossing of the AHCT threshold (1.4 V est; in brackets the skew at 0.8 V and at 2.0 V, the guaranteed band). J7 / J8: 50 % into 50 ohm through 1 m RG-58, all devices typical and identical on both channels, so the J7-J8 skew is from routing and loading only (U13 channel matching, SLUSFA9 tM 1 / 2 ns, comes on top). J10 'open' and '2-3' are the same circuit for CH1 (J10.1 open in both). The GPIO setting applies to GP11, GP12 and GP13. With J10 on 1-2 the CH1 edge has a reflection step; where the step sits near 0.8 V or 2.0 V, the skew at that threshold jumps (bracketed values above 1 ns).

| GPIO | J10 | R19 (ohm) | edge | t0 -> U7.2 (ns) | t0 -> U8.2 (ns) | skew at U7/U8 (ns) | skew at J7/J8 (ns) |
|---|---|---|---|---|---|---|---|
| 4 mA slow | 2-3 | 100 | rise | 2.93 | 2.93 | 0.001 [0.004, 0.005] | 0.016 |
| 4 mA slow | 2-3 | 100 | fall | 2.48 | 2.48 | 0.007 [0.009, 0.005] | 0.019 |
| 4 mA slow | 2-3 | 0 | rise | 2.95 | 2.93 | 0.016 [0.011, 0.016] | 0.031 |
| 4 mA slow | 2-3 | 0 | fall | 2.49 | 2.48 | 0.013 [0.022, 0.020] | 0.024 |
| 4 mA slow | 1-2 | 100 | rise | 3.13 | 2.93 | 0.199 [0.168, 0.239] | 0.214 |
| 4 mA slow | 1-2 | 100 | fall | 2.69 | 2.48 | 0.213 [0.326, 0.137] | 0.224 |
| 4 mA slow | 1-2 | 0 | rise | 3.50 | 2.93 | 0.570 [0.540, 1.403] | 0.585 |
| 4 mA slow | 1-2 | 0 | fall | 3.19 | 2.48 | 0.710 [0.828, 0.582] | 0.721 |
| 4 mA slow | open | 100 | rise | 2.93 | 2.93 | 0.001 [0.004, 0.005] | 0.016 |
| 4 mA slow | open | 100 | fall | 2.48 | 2.48 | 0.007 [0.009, 0.005] | 0.019 |
| 4 mA slow | open | 0 | rise | 2.95 | 2.93 | 0.016 [0.011, 0.016] | 0.031 |
| 4 mA slow | open | 0 | fall | 2.49 | 2.48 | 0.013 [0.022, 0.020] | 0.024 |
| 12 mA fast | 2-3 | 100 | rise | 1.17 | 1.19 | -0.015 [-0.020, -0.010] | 0.000 |
| 12 mA fast | 2-3 | 100 | fall | 1.12 | 1.14 | -0.018 [-0.009, -0.024] | -0.007 |
| 12 mA fast | 2-3 | 0 | rise | 1.19 | 1.19 | 0.001 [0.000, 0.005] | 0.016 |
| 12 mA fast | 2-3 | 0 | fall | 1.14 | 1.14 | 0.000 [0.004, 0.000] | 0.011 |
| 12 mA fast | 1-2 | 100 | rise | 1.19 | 1.19 | -0.003 [-0.015, 0.008] | 0.012 |
| 12 mA fast | 1-2 | 100 | fall | 1.13 | 1.14 | -0.007 [0.013, -0.020] | 0.004 |
| 12 mA fast | 1-2 | 0 | rise | 1.25 | 1.19 | 0.061 [0.030, 0.096] | 0.076 |
| 12 mA fast | 1-2 | 0 | fall | 1.21 | 1.14 | 0.073 [0.141, 0.031] | 0.084 |
| 12 mA fast | open | 100 | rise | 1.17 | 1.19 | -0.015 [-0.020, -0.010] | 0.000 |
| 12 mA fast | open | 100 | fall | 1.12 | 1.14 | -0.018 [-0.009, -0.024] | -0.007 |
| 12 mA fast | open | 0 | rise | 1.19 | 1.19 | 0.001 [0.000, 0.005] | 0.016 |
| 12 mA fast | open | 0 | fall | 1.14 | 1.14 | 0.000 [0.004, 0.000] | 0.011 |

Range over the strong / typical / weak GPIO corners, both edges and the AHCT threshold band:

| GPIO | J10 | R19 (ohm) | skew at U7/U8 (ns) | skew at J7/J8 (ns) |
|---|---|---|---|---|
| 4 mA slow | 2-3 | 100 | 0.000 .. 0.023 | 0.013 .. 0.022 |
| 4 mA slow | 2-3 | 0 | 0.011 .. 0.037 | 0.023 .. 0.034 |
| 4 mA slow | 1-2 | 100 | 0.109 .. 1.260 | 0.187 .. 0.318 |
| 4 mA slow | 1-2 | 0 | 0.483 .. 2.007 | 0.524 .. 1.500 |
| 12 mA fast | 2-3 | 100 | -0.025 .. -0.000 | -0.008 .. 0.003 |
| 12 mA fast | 2-3 | 0 | -0.000 .. 0.010 | 0.011 .. 0.017 |
| 12 mA fast | 1-2 | 100 | -0.022 .. 0.031 | 0.001 .. 0.019 |
| 12 mA fast | 1-2 | 0 | 0.026 .. 0.267 | 0.069 .. 0.115 |

Cost of R19 to the camera / J12 input with J10 on 1-2 (4 mA slow, typical GPIO): t0 to the U5.2 crossing of 0.9 V and the U19.2 crossing of VIN_H 2.0 V / VIN_L 1.0 V:

| R19 (ohm) | U5.2 rise (ns) | U5.2 fall (ns) | U19.2 rise (ns) | U19.2 fall (ns) |
|---|---|---|---|---|
| 100 | 3.89 | 5.20 | 5.66 | 4.94 |
| 0 | 3.14 | 3.56 | 4.21 | 3.48 |
| (J10 2-3, from GP11) | 2.94 | 3.28 | 3.88 | 3.22 |

## Case 2: J12 delay, waveform and offset from the camera triggers

J10 on 2-3, GP11 at the reset default (4 mA, slow slew). Delays start at t0, the GP11 internal edge (the PIO SET instant). 'From pin' subtracts the time from t0 to the 50 % (1.65 V) crossing at the J14.15 pad, for the same GPIO corner. Corners: min = strong GPIO with every device at its fast corner, typ = all typical, max = weak GPIO with every device at its slow corner, floor = GPIO on the RP2350 Table 1683 VOH/VOL limit with devices at max. 50 ohm mode: 50 % at the load, minus the cable delay (= J12.1). Hi-Z mode: same, at the 1 Mohm || 15 pF load (J12.1 itself steps to about half amplitude first).

| GPIO corner | t0 -> J14.15 50 %, rise (ns) | fall (ns) |
|---|---|---|
| strong | 3.05 | 2.41 |
| typ | 3.31 | 2.62 |
| weak | 4.67 | 3.12 |
| floor | 7.75 | 5.04 |

J12 delay, UCC27524DR, new die (fitted part, SLUSFA9 D row):

| J21 mode, cable | edge | min (ns) | typ (ns) | max (ns) | floor (ns) | typ from pin (ns) |
|---|---|---|---|---|---|---|
| 50 ohm, 1 m | rise | 10.26 | 21.53 | 33.71 | 38.58 | 18.22 |
| 50 ohm, 1 m | fall | 9.73 | 20.87 | 32.24 | 35.66 | 18.26 |
| 50 ohm, 3 m | rise | 10.26 | 21.53 | 33.71 | 38.58 | 18.22 |
| 50 ohm, 3 m | fall | 9.73 | 20.87 | 32.24 | 35.66 | 18.26 |
| Hi-Z, 1 m | rise | 10.78 | 22.26 | 34.46 | 39.33 | 18.95 |
| Hi-Z, 1 m | fall | 10.25 | 21.55 | 32.91 | 36.34 | 18.93 |
| Hi-Z, 3 m | rise | 10.78 | 22.26 | 34.46 | 39.33 | 18.95 |
| Hi-Z, 3 m | fall | 10.25 | 21.55 | 32.91 | 36.34 | 18.93 |

J12 delay, UCC27524 older die / UCC27524ADR (SLUSBP4C D rows):

| J21 mode, cable | edge | min (ns) | typ (ns) | max (ns) | floor (ns) | typ from pin (ns) |
|---|---|---|---|---|---|---|
| 50 ohm, 1 m | rise | 10.23 | 17.63 | 29.76 | 34.63 | 14.32 |
| 50 ohm, 1 m | fall | 9.31 | 16.76 | 28.08 | 30.97 | 14.14 |
| 50 ohm, 3 m | rise | 10.23 | 17.63 | 29.76 | 34.63 | 14.32 |
| 50 ohm, 3 m | fall | 9.31 | 16.76 | 28.08 | 30.97 | 14.14 |
| Hi-Z, 1 m | rise | 10.76 | 18.36 | 30.50 | 35.38 | 15.05 |
| Hi-Z, 1 m | fall | 9.83 | 17.43 | 28.76 | 31.65 | 14.81 |
| Hi-Z, 3 m | rise | 10.76 | 18.36 | 30.50 | 35.38 | 15.05 |
| Hi-Z, 3 m | fall | 9.83 | 17.43 | 28.76 | 31.65 | 14.81 |

J12 waveform at the load (UCC27524 new die; corner sets VDD, ROH/ROL, 1 % resistors and the output ramp: min = 12.05 V / high amplitude, max = 11.54 V / low amplitude). Settling: last exit from a +/- 2 % band, after the 50 % crossing:

| J21 mode, cable | corner | high (V) | peak (V) | overshoot (%) | undershoot (V) | low (V) | settle rise (ns) | settle fall (ns) |
|---|---|---|---|---|---|---|---|---|
| 50 ohm, 1 m | min | 5.13 | 5.46 | 6.3 | -0.31 | 0.000 | 5.3 | 4.8 |
| 50 ohm, 1 m | typ | 4.79 | 4.94 | 3.0 | -0.24 | 0.000 | 1.5 | 3.6 |
| 50 ohm, 1 m | max | 4.53 | 4.58 | 1.0 | -0.10 | 0.000 | 2.1 | 2.3 |
| 50 ohm, 3 m | min | 5.13 | 5.46 | 6.3 | -0.31 | 0.000 | 5.3 | 4.8 |
| 50 ohm, 3 m | typ | 4.79 | 4.94 | 3.0 | -0.24 | 0.000 | 1.5 | 3.6 |
| 50 ohm, 3 m | max | 4.53 | 4.58 | 1.0 | -0.10 | 0.000 | 2.1 | 2.3 |
| Hi-Z, 1 m | min | 5.07 | 5.32 | 4.8 | -0.24 | 0.000 | 12.7 | 12.7 |
| Hi-Z, 1 m | typ | 4.78 | 4.91 | 2.6 | -0.16 | 0.000 | 12.9 | 12.9 |
| Hi-Z, 1 m | max | 4.55 | 4.62 | 1.5 | -0.12 | 0.000 | 13.2 | 12.9 |
| Hi-Z, 3 m | min | 5.07 | 5.32 | 4.8 | -0.24 | 0.000 | 32.8 | 32.9 |
| Hi-Z, 3 m | typ | 4.78 | 4.91 | 2.6 | -0.16 | 0.000 | 33.1 | 33.1 |
| Hi-Z, 3 m | max | 4.55 | 4.62 | 1.5 | -0.12 | 0.000 | 33.4 | 33.1 |

Camera trigger delay, t0 to J1..J6 pin 4 at 0.9 V (5 pF est per pin; ribbon cable not modelled):

| edge | GPIO / devices | J1 | J2 | J3 | J4 | J5 | J6 | J1-J6 spread |
|---|---|---|---|---|---|---|---|---|
| rise | strong / min | 6.92 | 6.92 | 6.95 | 6.96 | 6.95 | 6.96 | 0.041 |
| rise | typ / typ | 11.01 | 11.01 | 11.01 | 11.04 | 11.04 | 11.07 | 0.058 |
| rise | weak / max | 19.42 | 19.42 | 19.41 | 19.40 | 19.41 | 19.45 | 0.051 |
| rise | floor / max | 21.63 | 21.63 | 21.62 | 21.61 | 21.62 | 21.66 | 0.051 |
| fall | strong / min | 7.35 | 7.35 | 7.39 | 7.40 | 7.38 | 7.39 | 0.047 |
| fall | typ / typ | 11.35 | 11.35 | 11.36 | 11.38 | 11.38 | 11.41 | 0.058 |
| fall | weak / max | 19.88 | 19.88 | 19.86 | 19.85 | 19.86 | 19.91 | 0.053 |
| fall | floor / max | 24.01 | 24.02 | 24.00 | 23.99 | 24.00 | 24.05 | 0.053 |

J12 (50 ohm, 1 m) minus camera trigger (mean of J1-J6). The GPIO corner is shared by both paths; the device corners are taken independently (min = J12 fast and cameras slow):

| U19 | edge | min (ns) | typ (ns) | max (ns) |
|---|---|---|---|---|
| UCC27524DR, new die (fitted part, SLUSFA9 D row) | rise | -8.50 | 10.51 | 26.34 |
| UCC27524DR, new die (fitted part, SLUSFA9 D row) | fall | -9.38 | 9.50 | 24.09 |
| UCC27524 older die / UCC27524ADR (SLUSBP4C D rows) | rise | -8.53 | 6.61 | 22.38 |
| UCC27524 older die / UCC27524ADR (SLUSBP4C D rows) | fall | -9.88 | 5.39 | 19.93 |

Typical breakdown: t0 -> U19.2 VIN crossing; U19 internal delay (= tD minus the model's start-to-10 % / 90 % time into 1.8 nF, given as 'cal'); U19 ramp start -> J12 50 %; t0 -> U5.2 0.9 V; U5 and U6 internal delays (tpd minus their test-load time):

| U19 | edge | t0->U19.2 | U19 int. | cal | U19->J12 | t0->U5.2 | U5 int. | U6 int. |
|---|---|---|---|---|---|---|---|---|
| UCC27524DR, new die (fitted part, SLUSFA9 D row) | rise | 3.88 | 16.23 | 0.77 | 1.42 | 2.94 | 2.65 | 2.51 |
| UCC27524DR, new die (fitted part, SLUSFA9 D row) | fall | 3.22 | 16.17 | 0.83 | 1.48 | 3.28 | 2.51 | 2.65 |
| UCC27524 older die / UCC27524ADR (SLUSBP4C D rows) | rise | 3.94 | 12.28 | 0.72 | 1.42 | 2.94 | 2.65 | 2.51 |
| UCC27524 older die / UCC27524ADR (SLUSBP4C D rows) | fall | 3.09 | 12.19 | 0.81 | 1.48 | 3.28 | 2.51 | 2.65 |

## Case 3: laser outputs J7 / J8 into 50 ohm

J18/J19 on 1-2, 1 m RG-58, 50 ohm load. Hand value = VDD x 50 / (50 + R6 + ROH) (Hardware.md 'Amplitude budget': 4.54 / 4.79 / 5.14 V). LDP-V window: 4.5-5.2 V high, <= 0.2 V low.

| U13 | corner | hand (V) | J7 high (V) | J8 high (V) | overshoot (%) | low (V) | undershoot (V) |
|---|---|---|---|---|---|---|---|
| UCC27524DR, new die (fitted part, SLUSFA9 D row) | high (12.05 V, R6 67.32, ROH 0.01) | 5.135 | 5.135 | 5.135 | 5.1 | 0.0000 | -0.249 |
| UCC27524DR, new die (fitted part, SLUSFA9 D row) | typ (11.79 V, R6 68.0, ROH 5) | 4.793 | 4.791 | 4.791 | 2.7 | 0.0000 | -0.218 |
| UCC27524DR, new die (fitted part, SLUSFA9 D row) | low (11.54 V, R6 68.68, ROH 8.5) | 4.537 | 4.534 | 4.534 | 1.0 | 0.0000 | -0.099 |
| UCC27524 older die / UCC27524ADR (SLUSBP4C D rows) | high (12.05 V, R6 67.32, ROH 2.5) | 5.028 | 5.027 | 5.027 | 3.6 | 0.0000 | -0.301 |
| UCC27524 older die / UCC27524ADR (SLUSBP4C D rows) | typ (11.79 V, R6 68.0, ROH 5) | 4.793 | 4.791 | 4.791 | 2.7 | 0.0000 | -0.220 |
| UCC27524 older die / UCC27524ADR (SLUSBP4C D rows) | low (11.54 V, R6 68.68, ROH 7.5) | 4.573 | 4.571 | 4.571 | 1.1 | 0.0000 | -0.100 |

## Case 4: R30 power (sanity check)

J12 chain, UCC27524 new die, held high for 300 ns through 1 m RG-58 into the load named; 'short' = 1 mohm at the cable end. Power = steady state while high (last 50 ns). Hand = the series circuit VDD / (ROH + R30 [+ R31 + R32 || load]). Average = power while high x the firmware's duty limit: 50% (2 x MARKERWIDTH <= 1/FREQ) or 67% (J10 on 1-2 with COMBINE 1). Corner: high = 12.05 V, ROH 0.01 ohm, 1 % resistors low; low = 11.54 V, ROH 8.5 ohm, resistors high. Compare Hardware.md 'Board output rating' and 'Output mode': 0.71 W into 50 ohm, 1.5-2.16 W stuck high into a short, 1.08 W / 1.45 W average, R31 0.52 W and R32 0.31 W in Hi-Z mode. R30 is a 2 W 2512.

| J21 mode | load | corner | I(R30) (mA) | R30 hand (W) | R30 sim (W) | R30 avg 50% (W) | R30 avg 67% (W) | R31 hand (W) | R31 sim (W) | R32 hand (W) | R32 sim (W) |
|---|---|---|---|---|---|---|---|---|---|---|---|
| 50 ohm | 50 ohm | high | 102.7 | 0.710 | 0.710 | 0.355 | 0.473 | 0.000 | 0.000 | 0.000 | 0.000 |
| 50 ohm | 50 ohm | typ | 95.8 | 0.625 | 0.624 | 0.312 | 0.416 | 0.000 | 0.000 | 0.000 | 0.000 |
| 50 ohm | 50 ohm | low | 90.7 | 0.565 | 0.565 | 0.282 | 0.377 | 0.000 | 0.000 | 0.000 | 0.000 |
| 50 ohm | short | high | 179.0 | 2.156 | 2.156 | 1.078 | 1.437 | 0.000 | 0.000 | 0.000 | 0.000 |
| 50 ohm | short | typ | 161.4 | 1.774 | 1.772 | 0.886 | 1.182 | 0.000 | 0.000 | 0.000 | 0.000 |
| 50 ohm | short | low | 149.4 | 1.535 | 1.534 | 0.767 | 1.023 | 0.000 | 0.000 | 0.000 | 0.000 |
| Hi-Z | 50 ohm | high | 83.1 | 0.465 | 0.465 | 0.232 | 0.310 | 0.321 | 0.321 | 0.081 | 0.081 |
| Hi-Z | 50 ohm | typ | 78.0 | 0.414 | 0.414 | 0.207 | 0.276 | 0.286 | 0.286 | 0.072 | 0.072 |
| Hi-Z | 50 ohm | low | 74.1 | 0.378 | 0.377 | 0.189 | 0.252 | 0.261 | 0.261 | 0.065 | 0.065 |
| Hi-Z | short | high | 105.8 | 0.754 | 0.754 | 0.377 | 0.503 | 0.521 | 0.521 | 0.000 | 0.000 |
| Hi-Z | short | typ | 98.2 | 0.656 | 0.656 | 0.328 | 0.437 | 0.454 | 0.453 | 0.000 | 0.000 |
| Hi-Z | short | low | 92.5 | 0.589 | 0.588 | 0.294 | 0.392 | 0.407 | 0.406 | 0.000 | 0.000 |
| Hi-Z | 1 Mohm | high | 61.3 | 0.253 | 0.253 | 0.126 | 0.168 | 0.175 | 0.175 | 0.311 | 0.311 |
| Hi-Z | 1 Mohm | typ | 58.3 | 0.232 | 0.232 | 0.116 | 0.154 | 0.160 | 0.160 | 0.279 | 0.279 |
| Hi-Z | 1 Mohm | low | 56.0 | 0.216 | 0.216 | 0.108 | 0.144 | 0.149 | 0.149 | 0.255 | 0.255 |

## Case 5: delay-reduction options

### GP11 drive strength and slew rate: ringing on PWM_Trig / PWM_TRIG_TAP

J10 on 2-3. Pin = J14.15 pad (absolute maximum 3.8 V, RP2350 Table 1680). Ring-back = the lowest value after the first peak of a rising edge (highest after the first dip of a falling edge), taken after the edge has left the receiver's threshold band (U5: above 1.17 V / below 0.63 V; U19: above 2.3 V / below 0.8 V); 'monotonic' = no peak. The value includes a dip inside a stepped edge, not only the ring after the final level (a value well below the final level, above the band, is such a dip). U5 has no hysteresis: 'risk' = the ring-back re-enters its 0.63-1.17 V band, so a camera trigger can fire twice. U19 'risk' = the ring-back passes VIN_L max 1.2 V (rise) or VIN_H min 1.8 V (fall). The U5 input clamp to GND is modelled (est). For the effect of the pad setting on the CH1/CH2 skew, see the 12 mA fast rows of case 1.

| GP11 | GPIO | pin max (V) | pin min (V) | U5.2 max (V) | U5.2 min (V) | U5 ring-back rise (V) | fall (V) | U5 risk | U19 ring-back rise (V) | fall (V) | U19 risk |
|---|---|---|---|---|---|---|---|---|---|---|---|
| 4 mA slow | strong | 3.49 | -0.31 | 3.68 | -0.78 | 3.17 | 0.28 | no | 3.18 | 0.30 | no |
| 4 mA slow | typ | 3.32 | -0.22 | 3.35 | -0.51 | 3.27 | 0.14 | no | 3.27 | 0.15 | no |
| 4 mA slow | weak | 3.28 | -0.01 | 3.28 | -0.01 | monotonic | monotonic | no | monotonic | monotonic | no |
| 4 mA fast | strong | 3.44 | -0.39 | 3.48 | -0.88 | 3.20 | 0.35 | no | 3.20 | 0.35 | no |
| 4 mA fast | typ | 3.38 | -0.37 | 3.39 | -0.72 | 2.77 | 0.23 | no | 2.75 | 0.23 | no |
| 4 mA fast | weak | 3.29 | -0.03 | 3.29 | -0.03 | 1.73 | 0.04 | no | 2.91 | 0.43 | no |
| 8 mA slow | strong | 3.72 | -0.33 | 4.33 | -0.93 | 2.83 | 0.46 | no | 2.82 | 0.44 | no |
| 8 mA slow | typ | 3.58 | -0.28 | 4.01 | -0.85 | 3.05 | 0.37 | no | 3.03 | 0.38 | no |
| 8 mA slow | weak | 3.35 | -0.21 | 3.39 | -0.48 | 3.26 | 0.12 | no | 3.27 | 0.12 | no |
| 8 mA fast | strong | 4.02 | -0.76 | 4.89 | -1.07 | 2.49 | 0.44 | no | 2.54 | 0.40 | no |
| 8 mA fast | typ | 3.82 | -0.54 | 4.36 | -0.98 | 2.86 | 0.40 | no | 2.90 | 0.38 | no |
| 8 mA fast | weak | 3.33 | -0.40 | 3.33 | -0.73 | 3.26 | 0.22 | no | 3.17 | 0.22 | no |
| 12 mA slow | strong | 3.78 | -0.35 | 4.48 | -0.97 | 2.71 | 0.50 | no | 2.72 | 0.47 | no |
| 12 mA slow | typ | 3.66 | -0.31 | 4.17 | -0.90 | 2.95 | 0.44 | no | 2.94 | 0.42 | no |
| 12 mA slow | weak | 3.43 | -0.29 | 3.54 | -0.69 | 3.23 | 0.21 | no | 3.23 | 0.22 | no |
| 12 mA fast | strong | 4.11 | -0.90 | 5.14 | -1.13 | 2.28 | 0.46 | no | 2.32 | 0.40 | no |
| 12 mA fast | typ | 3.95 | -0.68 | 4.67 | -1.04 | 2.68 | 0.43 | no | 2.72 | 0.39 | no |
| 12 mA fast | weak | 3.50 | -0.39 | 3.60 | -0.85 | 3.20 | 0.30 | no | 3.20 | 0.30 | no |

### U19 driver choice and GP11 pad setting

J12: 50 ohm mode, 1 m. Camera: mean of J1-J6. Offset = J12 minus camera. The GP11 pad setting is a firmware change (gpio_set_drive_strength / gpio_set_slew_rate); 12 mA fast exceeds the pin absolute maximum (table above).

| U19 | GP11 | edge | J12 min (ns) | J12 typ (ns) | J12 max (ns) | camera typ (ns) | offset min (ns) | offset typ (ns) | offset max (ns) |
|---|---|---|---|---|---|---|---|---|---|
| UCC27524DR, new die (fitted part, SLUSFA9 D row) | 4 mA slow | rise | 10.26 | 21.53 | 33.71 | 11.03 | -8.50 | 10.51 | 26.34 |
| UCC27524DR, new die (fitted part, SLUSFA9 D row) | 4 mA slow | fall | 9.73 | 20.87 | 32.24 | 11.37 | -9.38 | 9.50 | 24.09 |
| UCC27524DR, new die (fitted part, SLUSFA9 D row) | 12 mA slow | rise | 9.66 | 20.80 | 31.70 | 10.46 | -8.56 | 10.34 | 24.99 |
| UCC27524DR, new die (fitted part, SLUSFA9 D row) | 12 mA slow | fall | 9.35 | 20.37 | 31.37 | 10.85 | -9.22 | 9.52 | 24.00 |
| UCC27524DR, new die (fitted part, SLUSFA9 D row) | 12 mA fast | rise | 8.42 | 19.41 | 30.00 | 9.59 | -8.83 | 9.82 | 24.06 |
| UCC27524DR, new die (fitted part, SLUSFA9 D row) | 12 mA fast | fall | 8.43 | 19.31 | 30.05 | 9.78 | -9.01 | 9.54 | 23.85 |
| UCC27524 older die / UCC27524ADR (SLUSBP4C D rows) | 4 mA slow | rise | 10.23 | 17.63 | 29.76 | 11.03 | -8.53 | 6.61 | 22.38 |
| UCC27524 older die / UCC27524ADR (SLUSBP4C D rows) | 4 mA slow | fall | 9.31 | 16.76 | 28.08 | 11.37 | -9.88 | 5.39 | 19.93 |
| UCC27524 older die / UCC27524ADR (SLUSBP4C D rows) | 12 mA slow | rise | 9.62 | 16.89 | 27.74 | 10.46 | -8.60 | 6.43 | 21.03 |
| UCC27524 older die / UCC27524ADR (SLUSBP4C D rows) | 12 mA slow | fall | 8.94 | 16.28 | 27.25 | 10.85 | -9.66 | 5.43 | 19.88 |
| UCC27524 older die / UCC27524ADR (SLUSBP4C D rows) | 12 mA fast | rise | 8.34 | 15.47 | 26.04 | 9.59 | -8.91 | 5.88 | 20.10 |
| UCC27524 older die / UCC27524ADR (SLUSBP4C D rows) | 12 mA fast | fall | 8.08 | 15.29 | 26.01 | 9.78 | -9.36 | 5.51 | 19.81 |
| Infineon 2EDN7524F (same pinout, footprint swap only) | 4 mA slow | rise | 19.27 | 21.66 | 29.59 | 11.03 | 0.51 | 10.63 | 22.22 |
| Infineon 2EDN7524F (same pinout, footprint swap only) | 4 mA slow | fall | 18.59 | 22.97 | 28.20 | 11.37 | -0.49 | 11.60 | 20.05 |
| Infineon 2EDN7524F (same pinout, footprint swap only) | 12 mA slow | rise | 18.66 | 20.92 | 27.73 | 10.46 | 0.44 | 10.46 | 21.02 |
| Infineon 2EDN7524F (same pinout, footprint swap only) | 12 mA slow | fall | 18.20 | 22.47 | 27.35 | 10.85 | -0.36 | 11.61 | 19.99 |
| Infineon 2EDN7524F (same pinout, footprint swap only) | 12 mA fast | rise | 17.35 | 19.50 | 26.07 | 9.59 | 0.11 | 9.91 | 20.13 |
| Infineon 2EDN7524F (same pinout, footprint swap only) | 12 mA fast | fall | 17.24 | 21.42 | 26.10 | 9.78 | -0.18 | 11.64 | 19.90 |
| TI UCC27517A (SOT-23-5, new footprint, no enable pin) | 4 mA slow | rise | 8.28 | 17.69 | 30.02 | 11.03 | -10.47 | 6.66 | 22.64 |
| TI UCC27517A (SOT-23-5, new footprint, no enable pin) | 4 mA slow | fall | 7.31 | 16.76 | 28.08 | 11.37 | -11.88 | 5.39 | 19.93 |
| TI UCC27517A (SOT-23-5, new footprint, no enable pin) | 12 mA slow | rise | 7.67 | 16.95 | 27.81 | 10.46 | -10.55 | 6.49 | 21.10 |
| TI UCC27517A (SOT-23-5, new footprint, no enable pin) | 12 mA slow | fall | 6.94 | 16.28 | 27.25 | 10.85 | -11.66 | 5.43 | 19.88 |
| TI UCC27517A (SOT-23-5, new footprint, no enable pin) | 12 mA fast | rise | 6.36 | 15.49 | 26.07 | 9.59 | -10.89 | 5.90 | 20.13 |
| TI UCC27517A (SOT-23-5, new footprint, no enable pin) | 12 mA fast | fall | 6.08 | 15.29 | 26.01 | 9.78 | -11.36 | 5.51 | 19.81 |

### Option d: U19 on its own GPIO (GP14, estimated 90 mm trace), no PIO lead

U19.2 is cut from PWM_TRIG_TAP; GP14 and GP11 switch at the same t0. A PIO lead of N cycles on GP14 subtracts N x 6.67 ns (150 MHz) or N x 3.33 ns (300 MHz) from every J12 number and offset below.

| U19 | GPIO | edge | t0 -> U19.2 (ns) | J12 typ (ns) | camera typ (ns) | offset min (ns) | offset typ (ns) | offset max (ns) |
|---|---|---|---|---|---|---|---|---|
| UCC27524DR, new die (fitted part, SLUSFA9 D row) | 4 mA slow | rise | 3.40 | 21.05 | 10.83 | -8.73 | 10.22 | 25.12 |
| UCC27524DR, new die (fitted part, SLUSFA9 D row) | 4 mA slow | fall | 2.79 | 20.44 | 11.13 | -9.55 | 9.31 | 23.80 |
| UCC27524DR, new die (fitted part, SLUSFA9 D row) | 12 mA fast | rise | 1.42 | 19.07 | 9.48 | -9.05 | 9.59 | 23.78 |
| UCC27524DR, new die (fitted part, SLUSFA9 D row) | 12 mA fast | fall | 1.31 | 18.97 | 9.61 | -9.16 | 9.36 | 23.65 |
| Infineon 2EDN7524F (same pinout, footprint swap only) | 4 mA slow | rise | 3.46 | 21.17 | 10.83 | 0.27 | 10.34 | 21.06 |
| Infineon 2EDN7524F (same pinout, footprint swap only) | 4 mA slow | fall | 2.77 | 22.54 | 11.13 | -0.68 | 11.40 | 19.79 |
| Infineon 2EDN7524F (same pinout, footprint swap only) | 12 mA fast | rise | 1.44 | 19.15 | 9.48 | -0.12 | 9.67 | 19.86 |
| Infineon 2EDN7524F (same pinout, footprint swap only) | 12 mA fast | fall | 1.31 | 21.07 | 9.61 | -0.34 | 11.46 | 19.70 |

## Gate model calibration

Internal delay = datasheet delay - (threshold offset on the datasheet test input) - (model output delay into the datasheet test load). Input edge named.

| device | corner | input edge | datasheet (ns) | threshold offset | test-load delay | internal delay | note |
|---|---|---|---|---|---|---|---|
| SN74LVC1G04 | min | rise | 3.00 | -0.30 | 0.84 | 2.46 |  |
| SN74LVC1G04 | min | fall | 3.00 | -0.30 | 0.89 | 2.41 |  |
| SN74LVC1G04 | typ | rise | 4.10 | 0.00 | 1.45 | 2.65 |  |
| SN74LVC1G04 | typ | fall | 4.10 | 0.00 | 1.59 | 2.51 |  |
| SN74LVC1G04 | max | rise | 7.50 | 0.30 | 2.83 | 4.37 |  |
| SN74LVC1G04 | max | fall | 7.50 | 0.30 | 3.52 | 3.68 |  |
| SN74LVC04A | min | rise | 1.00 | -0.30 | 0.84 | 0.46 |  |
| SN74LVC04A | min | fall | 1.00 | -0.30 | 0.89 | 0.41 |  |
| SN74LVC04A | typ | rise | 4.10 | 0.00 | 1.45 | 2.65 |  |
| SN74LVC04A | typ | fall | 4.10 | 0.00 | 1.59 | 2.51 |  |
| SN74LVC04A | max | rise | 8.00 | 0.30 | 2.83 | 4.87 |  |
| SN74LVC04A | max | fall | 8.00 | 0.30 | 3.52 | 4.18 |  |
| SN74AHCT1G08 | min | rise | 1.00 | -0.70 | 0.54 | 1.16 |  |
| SN74AHCT1G08 | min | fall | 1.00 | -0.50 | 0.54 | 0.96 |  |
| SN74AHCT1G08 | typ | rise | 5.00 | -0.10 | 0.98 | 4.12 |  |
| SN74AHCT1G08 | typ | fall | 5.00 | 0.10 | 0.98 | 3.92 |  |
| SN74AHCT1G08 | max | rise | 7.10 | 0.50 | 2.03 | 4.57 |  |
| SN74AHCT1G08 | max | fall | 7.10 | 0.70 | 2.03 | 4.37 |  |
| UCC27524_new | min | rise | 6.00 | 0.00 | 0.25 | 5.75 |  |
| UCC27524_new | min | fall | 6.00 | 0.00 | 0.14 | 5.86 |  |
| UCC27524_new | typ | rise | 17.00 | 0.00 | 0.77 | 16.23 |  |
| UCC27524_new | typ | fall | 17.00 | 0.00 | 0.83 | 16.17 |  |
| UCC27524_new | max | rise | 27.00 | 0.00 | 1.38 | 25.62 |  |
| UCC27524_new | max | fall | 27.00 | 0.00 | 1.33 | 25.67 |  |
| UCC27524_legacy | min | rise | 6.00 | 0.00 | 0.36 | 5.64 |  |
| UCC27524_legacy | min | fall | 6.00 | 0.00 | 0.48 | 5.52 |  |
| UCC27524_legacy | typ | rise | 13.00 | 0.00 | 0.72 | 12.28 |  |
| UCC27524_legacy | typ | fall | 13.00 | 0.00 | 0.81 | 12.19 |  |
| UCC27524_legacy | max | rise | 23.00 | 0.00 | 1.34 | 21.66 |  |
| UCC27524_legacy | max | fall | 23.00 | 0.00 | 1.31 | 21.69 |  |
| 2EDN7524F | min | rise | 15.00 | 0.00 | 0.35 | 14.65 |  |
| 2EDN7524F | min | fall | 15.00 | 0.00 | 0.35 | 14.65 |  |
| 2EDN7524F | typ | rise | 17.00 | 0.00 | 0.69 | 16.31 |  |
| 2EDN7524F | typ | fall | 19.00 | 0.00 | 0.64 | 18.36 |  |
| 2EDN7524F | max | rise | 23.00 | 0.00 | 1.29 | 21.71 |  |
| 2EDN7524F | max | fall | 23.00 | 0.00 | 1.12 | 21.88 |  |
| UCC27517A | min | rise | 4.00 | 0.00 | 0.36 | 3.64 |  |
| UCC27517A | min | fall | 4.00 | 0.00 | 0.48 | 3.52 |  |
| UCC27517A | typ | rise | 13.00 | 0.00 | 0.72 | 12.28 |  |
| UCC27517A | typ | fall | 13.00 | 0.00 | 0.81 | 12.19 |  |
| UCC27517A | max | rise | 23.00 | 0.00 | 1.34 | 21.66 |  |
| UCC27517A | max | fall | 23.00 | 0.00 | 1.31 | 21.69 |  |
