Low-Boom/PiEBV/tools/signal_sim/results_rev2.md

# Rev 2 simulation results

Generated by `rev2_sim.py`. It uses the models of `signal_sim.py` and the block `rev2` of `devices.json`. Entries marked est in `devices.json` are estimates, not datasheet limits.

## 1. Camera trigger delay and J12 offset at +VCAM = 1.8 V and 3.3 V

GP11 edge start to the camera header pin 4 (J1-J6), reference level VCAM / 2, J10 on 2-3, GPIO 4 mA slow. J12 into 50 ohm through 1 m RG-58, referred to the BNC. The J12 path does not depend on +VCAM.

| +VCAM | corner | camera rise min (ns) | max | camera fall min (ns) | max | J12 minus camera, rise (ns) | fall (ns) |
|---|---|---|---|---|---|---|---|
| 1.8 V | min | 7.03 | 7.07 | 7.55 | 7.59 | 3.43 | 2.36 |
| 1.8 V | typ | 11.01 | 11.07 | 11.35 | 11.41 | 10.50 | 9.50 |
| 1.8 V | max | 18.91 | 18.96 | 19.14 | 19.20 | 13.17 | 12.42 |
| 3.3 V | min | 5.88 | 5.95 | 5.44 | 5.54 | 4.57 | 4.44 |
| 3.3 V | typ | 8.44 | 8.48 | 7.68 | 7.71 | 13.07 | 13.18 |
| 3.3 V | max | 10.97 | 11.02 | 10.07 | 10.09 | 21.11 | 21.51 |

The three corners use the same corner for the camera gates and for U19, as signal_sim.py does in its own offset table; that table also crosses the corners. At 3.3 V the camera gates are faster, so J12 is later relative to the camera pin than at 1.8 V. Measure the offset for the +VCAM setting in use (Hardware.md, first-board check 4).

## 2. Camera harness: level and edge at the camera end

One U2 / U4 / U6 output (SN74LVC04A) drives its routed board line (`Trigger3` as the example), then a ribbon wire pair (Z0 105 ohm, 5.0 ns/m, est) and the camera input. IDS: 5 pF (est). EVK4: opto input, 296 ohm + LED (est, see devices.json), 10 pF.

| camera | +VCAM | ribbon | on-board series R (ohm) | corner | high (V) | peak (V) | lowest after the fall (V) | rise to VCAM/2 (ns) | EVK4 LED current (mA) | EVK4: lowest level after the rise (V) |
|---|---|---|---|---|---|---|---|---|---|---|
| IDS | 1.8 V | 0.5 m | 0 | min | 1.84 | 3.02 | -1.19 | 3.29 | - | - |
| IDS | 1.8 V | 0.5 m | 0 | typ | 1.80 | 2.51 | -0.71 | 3.61 | - | - |
| IDS | 1.8 V | 0.5 m | 0 | max | 1.76 | 1.80 | -0.03 | 4.46 | - | - |
| IDS | 1.8 V | 0.5 m | 47 | min | 1.84 | 2.18 | -0.34 | 3.38 | - | - |
| IDS | 1.8 V | 0.5 m | 47 | typ | 1.80 | 1.89 | -0.09 | 3.77 | - | - |
| IDS | 1.8 V | 0.5 m | 47 | max | 1.76 | 1.76 | 0.00 | 4.74 | - | - |
| IDS | 1.8 V | 2.0 m | 0 | min | 1.87 | 3.00 | -1.22 | 10.79 | - | - |
| IDS | 1.8 V | 2.0 m | 0 | typ | 1.80 | 2.50 | -0.70 | 11.11 | - | - |
| IDS | 1.8 V | 2.0 m | 0 | max | 1.76 | 1.80 | -0.03 | 11.96 | - | - |
| IDS | 1.8 V | 2.0 m | 47 | min | 1.84 | 2.17 | -0.33 | 10.88 | - | - |
| IDS | 1.8 V | 2.0 m | 47 | typ | 1.80 | 1.89 | -0.09 | 11.27 | - | - |
| IDS | 1.8 V | 2.0 m | 47 | max | 1.76 | 1.76 | 0.00 | 12.25 | - | - |
| EVK4 | 3.3 V | 0.5 m | 0 | min | 3.32 | 5.58 | -2.94 | 3.34 | 5.30 | 2.20 |
| EVK4 | 3.3 V | 0.5 m | 0 | typ | 3.18 | 4.80 | -2.15 | 3.61 | 4.84 | 2.54 |
| EVK4 | 3.3 V | 0.5 m | 0 | max | 2.99 | 3.81 | -1.10 | 4.13 | 4.23 | 2.81 |
| EVK4 | 3.3 V | 0.5 m | 47 | min | 3.11 | 3.78 | -0.88 | 3.47 | 4.63 | 2.97 |
| EVK4 | 3.3 V | 0.5 m | 47 | typ | 2.99 | 3.42 | -0.54 | 3.77 | 4.25 | 2.89 |
| EVK4 | 3.3 V | 0.5 m | 47 | max | 2.84 | 2.93 | -0.11 | 4.38 | 3.75 | 2.69 |
| EVK4 | 3.3 V | 2.0 m | 0 | min | 3.20 | 5.54 | -2.93 | 10.84 | 4.93 | 2.22 |
| EVK4 | 3.3 V | 2.0 m | 0 | typ | 3.13 | 4.77 | -2.13 | 11.11 | 4.68 | 2.55 |
| EVK4 | 3.3 V | 2.0 m | 0 | max | 2.98 | 3.79 | -1.10 | 11.64 | 4.21 | 2.81 |
| EVK4 | 3.3 V | 2.0 m | 47 | min | 3.11 | 3.77 | -0.87 | 10.97 | 4.62 | 2.96 |
| EVK4 | 3.3 V | 2.0 m | 47 | typ | 2.99 | 3.41 | -0.55 | 11.27 | 4.24 | 2.88 |
| EVK4 | 3.3 V | 2.0 m | 47 | max | 2.83 | 2.93 | -0.12 | 11.88 | 3.74 | 2.69 |

The ribbon is a transmission line with an open end (IDS) or a high-resistance end (EVK4). Without a series resistor the output resistance of U2 / U4 / U6 is lower than the line impedance at the fast and typical corners, so the edge overshoots at the camera. The output resistances at the min and typ corners are estimates.

- **EVK4 at 3.3 V, no series resistor:** steady level 2.98-3.32 V, LED current 4.2-5.3 mA, peak 5.58 V, -2.94 V after a falling edge, and the level falls back to 2.20 V after a rising edge (the camera manual gives 2.5 V as the lowest high level and 5.5 V as the highest input voltage).
- **EVK4 at 3.3 V, on-board 47 ohm (R52-R63):** steady level 2.83-3.11 V (2.5 V or more is needed), LED current 3.7-4.6 mA (2.7 mA or more), peak 3.78 V, -0.88 V after a falling edge, lowest level after a rising edge 2.69 V.
- **IDS at 1.8 V, no series resistor (the Rev 1 condition, with the ribbon in the model):** peak 3.02 V and -1.22 V after a falling edge at the fast corner. IDS documents these pins as 1.8 V and publishes no input protection data.
- **IDS at 1.8 V, on-board 47 ohm (R52-R69):** peak 2.18 V, -0.34 V after a falling edge; the edge at the camera is 0.3 ns later at most.

**Wrong J22 setting (3.3 V with an IDS camera):** the 1.8 V pin would see 3.20-3.40 V steady and 4.43 V peak. That is why J22 stays open with IDS cameras.

### All camera lines

Each of the 18 lines with its own routed copper, its on-board 47 ohm resistor (R52-R69) and its stub to the header pin, at the fast corner (the largest overshoot) with the longest ribbon. The EVK4 has no pixel-reset input, so `TDRSTN` is run for IDS only.

| camera | +VCAM | lines | high (V) | highest peak (V) | lowest after the fall (V) | rise to VCAM/2 (ns) | EVK4: lowest level after the rise (V) |
|---|---|---|---|---|---|---|---|
| IDS | 1.8 V | Sync1-6 | 1.84 - 1.84 | 2.16 | -0.33 | 11.02 - 11.09 | - |
| IDS | 1.8 V | Trigger1-6 | 1.84 - 1.84 | 2.17 | -0.33 | 10.88 - 10.91 | - |
| IDS | 1.8 V | TDRSTN1-6 | 1.84 - 1.84 | 2.16 | -0.32 | 10.89 - 10.94 | - |
| EVK4 | 3.3 V | Sync1-6 | 3.11 - 3.11 | 3.82 | -0.92 | 11.10 - 11.17 | 2.96 |
| EVK4 | 3.3 V | Trigger1-6 | 3.11 - 3.11 | 3.77 | -0.88 | 10.97 - 11.00 | 2.96 |

The rise time includes the board line and 2.0 m of ribbon. The spread of the rise time in a group is the residual skew of the model at the camera end.

## 3. +VCAM budget

| case | +3V3 (V) | U2/U6 output resistance (ohm) | LED current per input (mA) | level at the EVK4 input (V) | 6 cameras, Sync and Trigger high together (mA) | drop in U20 (mV) |
|---|---|---|---|---|---|---|
| worst | 3.20 | 50.0 | 4.21 | 2.98 | 51 | 5.1 |
| typical | 3.30 | 25.0 | 4.83 | 3.17 | 58 | 2.9 |

Six EVK4 cameras draw at most 58 mA from +VCAM while Sync and Trigger are both high, and about half of that on average (Sync is a 50 % clock, the marker duty is at most 50 %). The source is the Pico 3V3_OUT pin (Raspberry Pi recommends a load below 300 mA). With six IDS cameras at 1.8 V the load is CMOS inputs only (no DC current).

## 4. Activity-LED sense dividers (R39/R40 + C31/C32, R43/R44 + C33/C34, R47/R48 + C35/C36)

| output | pulse at the driver output | peak at pin B, min corner (V) | typ | max | shortest time above 2.0 V (ns) |
|---|---|---|---|---|---|
| Laser 1 | 10 ns | 4.14 | 3.64 | 3.34 | 9.2 |
| Laser 1 | 20 ns | 4.14 | 3.64 | 3.34 | 19.2 |
| Laser 1 | 100 ns | 4.14 | 3.64 | 3.36 | 99.3 |
| Laser 2 | 10 ns | 4.07 | 3.52 | 3.21 | 9.0 |
| Laser 2 | 20 ns | 4.07 | 3.52 | 3.21 | 19.0 |
| Laser 2 | 100 ns | 4.07 | 3.52 | 3.29 | 99.2 |
| Ext Sync | 10 ns | 3.79 | 3.29 | 3.01 | 8.7 |
| Ext Sync | 20 ns | 3.79 | 3.29 | 3.01 | 18.7 |
| Ext Sync | 100 ns | 3.79 | 3.35 | 3.19 | 99.0 |

The monostables run from +3V3: high threshold 2.0 V (VIH min 2.0 V at VCC 2.7-3.6 V (LVC logic)), inputs rated to 5.5 V. The settled level at pin B is 3.18-3.76 V; the highest peak is 4.14 V. The monostable needs 3.0 ns above its threshold (SN74LVC1G123: minimum trigger pulse duration 3 ns at VCC 3.3 V, 2.5 ns at 5 V (web search of the TI datasheet SCES586)). The shortest laser pulse of the firmware is 20 ns (10 ns with the 300 MHz clock jumper): the input is above the threshold for at least 18.7 ns (20 ns pulse) and 8.7 ns (10 ns pulse). Corners: min = fast driver at the highest +12V, max = slow driver at the lowest +12V.

| corner | J7 level into 50 ohm without the divider (V) | with the divider (V) | change (mV) |
|---|---|---|---|
| min | 5.1350 | 5.1350 | 0.0 |
| typ | 4.7926 | 4.7910 | -1.6 |
| max | 4.5368 | 4.5344 | -2.4 |

Each divider draws 0.82 mA from its driver while the output is high (7 mW in the 10000 ohm resistor). The level at the BNC changes by the driver's output resistance times this current. C_top in series with C_bot adds about 8 pF to the driver output.

## 5. In2 island gap under a B.Cu track

Over the 0.5 mm gap between two islands the track has no plane 0.21 mm below it. Its return current uses the B.Cu GND pour beside the track (0.3 mm away on both sides, continuous across the gap) and the In1 GND plane (1.29 mm away). Field solver (`extract_geometry.fd_line`), track with pour and far plane / with the far plane only:

| track width | Z0 over an island (ohm) | Z0 over the gap, with the B.Cu pour (ohm) | Z0 over the gap, no pour (ohm) |
|---|---|---|---|
| 0.3 mm | 54.5 | 78.5 | 114.1 |
| 0.5 mm | 40.8 | 68.6 | 99.1 |

Line of the net's length with a 40 ohm, 1 ns, 3.3 V source and a 5 pF load; 1.0 mm of the line replaced by the gap impedance, against the same line without a gap:

| net | crossing (plane_check.py) | gap model | Z0 over the gap (ohm) | added delay at the load (ps) | largest change of the load waveform (mV) |
|---|---|---|---|---|---|
| PWM_1MHz | (195.02, 86.32) +5V -> +VCAM, 0.5 mm track | with pour | 69 | -2.0 | 11 |
| PWM_1MHz | (195.02, 86.32) +5V -> +VCAM, 0.5 mm track | no pour (bound) | 99 | -2.0 | 20 |
| PWM_TRIG_TAP | (227.58, 74.58) +5V -> +VCAM, 0.3 mm track | with pour | 79 | 0.4 | 8 |
| PWM_TRIG_TAP | (227.58, 74.58) +5V -> +VCAM, 0.3 mm track | no pour (bound) | 114 | 2.7 | 20 |

Every B.Cu camera track (Sync, Trigger, TDRSTN) stays over the +VCAM island (`plane_check.py`), so no camera line crosses a gap. `PWM_1MHz` and `PWM_TRIG_TAP` each cross one gap (+5V to +VCAM). The other B.Cu tracks that change island carry DC or indicator signals (`LASER_PWR_OK`, `CH2_SENSE`, `SYNC_SENSE`, the D2 cathode link, `+12V`).

| net | B.Cu length (mm) | over | island changes |
|---|---|---|---|
| PIXRST_GATE | 39.2 | +5V 39.2 | 0 |
| PWM_1MHz | 79.6 | +5V 74.5, +VCAM 4.4, GND 0.7 | 1 |
| PWM_TRIG_TAP | 70.2 | +5V 40.6, +VCAM 28.9, GND 0.7 | 1 |
| PWM_Trig | 9.6 | +5V 9.6 | 0 |
| Sync1 | 34.7 | +VCAM 34.7 | 0 |
| Sync2 | 67.6 | +VCAM 67.6 | 0 |
| Sync4 | 62.7 | +VCAM 62.7 | 0 |
| Sync5 | 49.8 | +VCAM 49.8 | 0 |
| Sync6 | 51.3 | +VCAM 51.3 | 0 |
| TDRSTN2 | 47.9 | +VCAM 47.9 | 0 |
| TDRSTN4 | 46.8 | +VCAM 46.8 | 0 |
| TDRSTN5 | 28.4 | +VCAM 28.4 | 0 |
| TDRSTN6 | 48.5 | +VCAM 48.5 | 0 |
| Trigger6 | 4.9 | +VCAM 4.9 | 0 |

Generated with 154 ngspice runs.
