Low-Boom/PiEBV/PiEBV_Pico.kicad_pcb

## KiCad design PiEBV_Pico.kicad_pcb (2026-11-14)

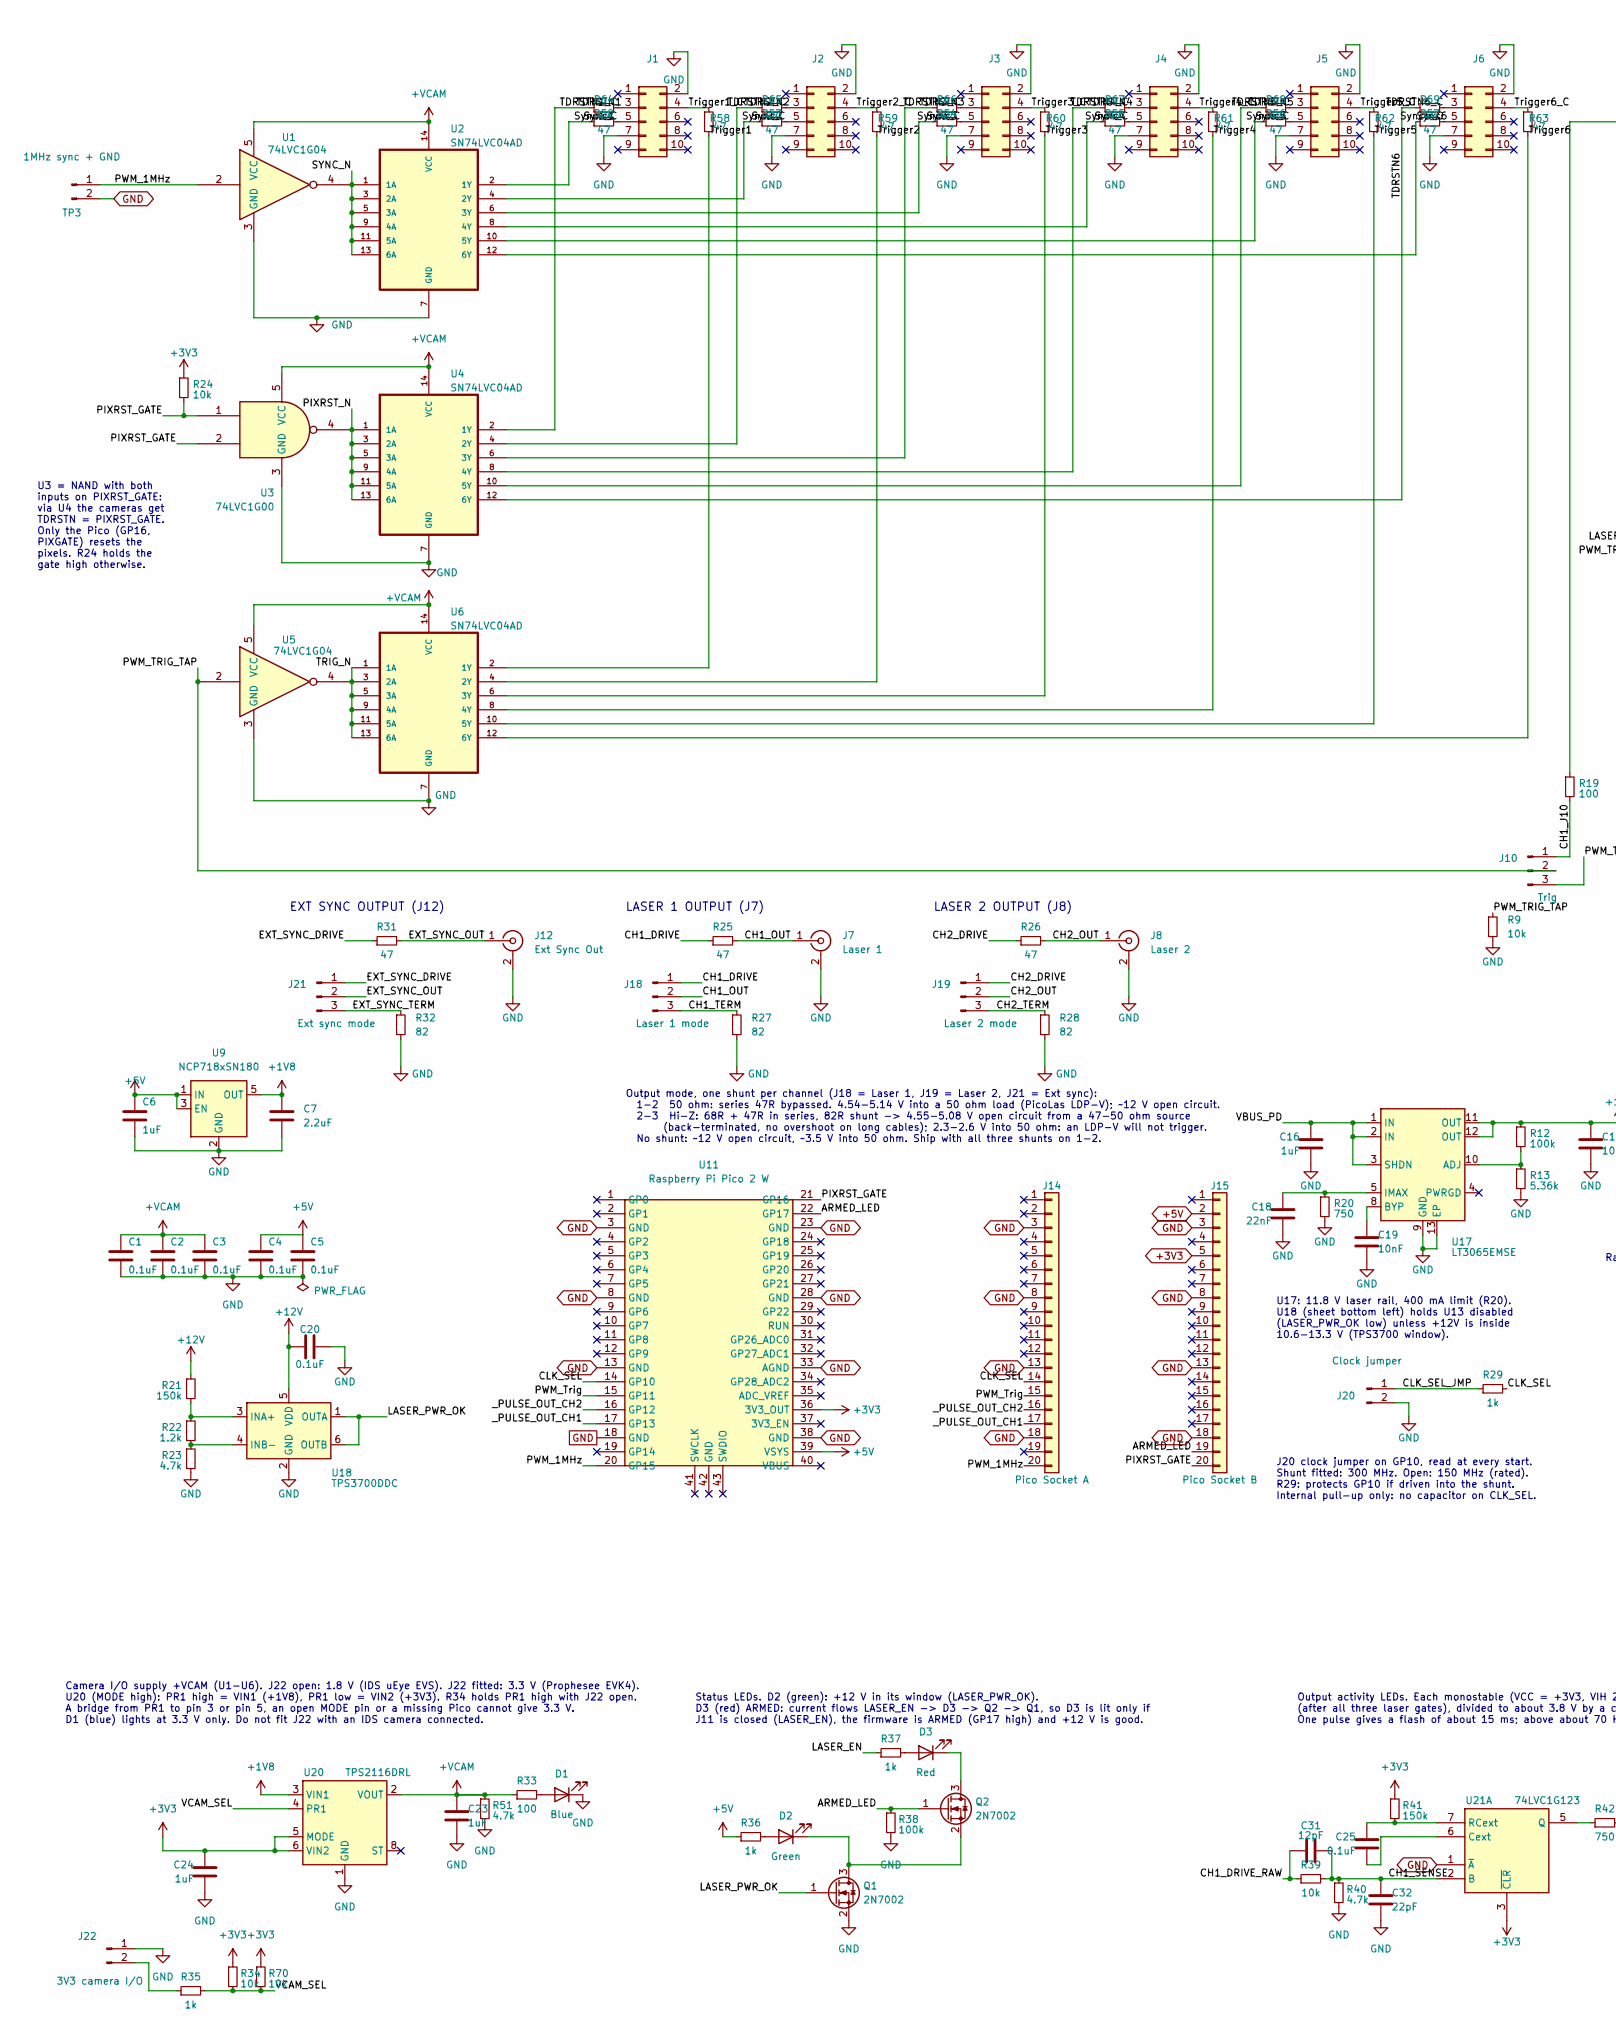
[picture p11: schematic PiEBV_Pico.kicad_sch, Event-camera Synchronizer, IDS EVS / Prophesee EVK4 (Pico 2), part in row 1, column 1]

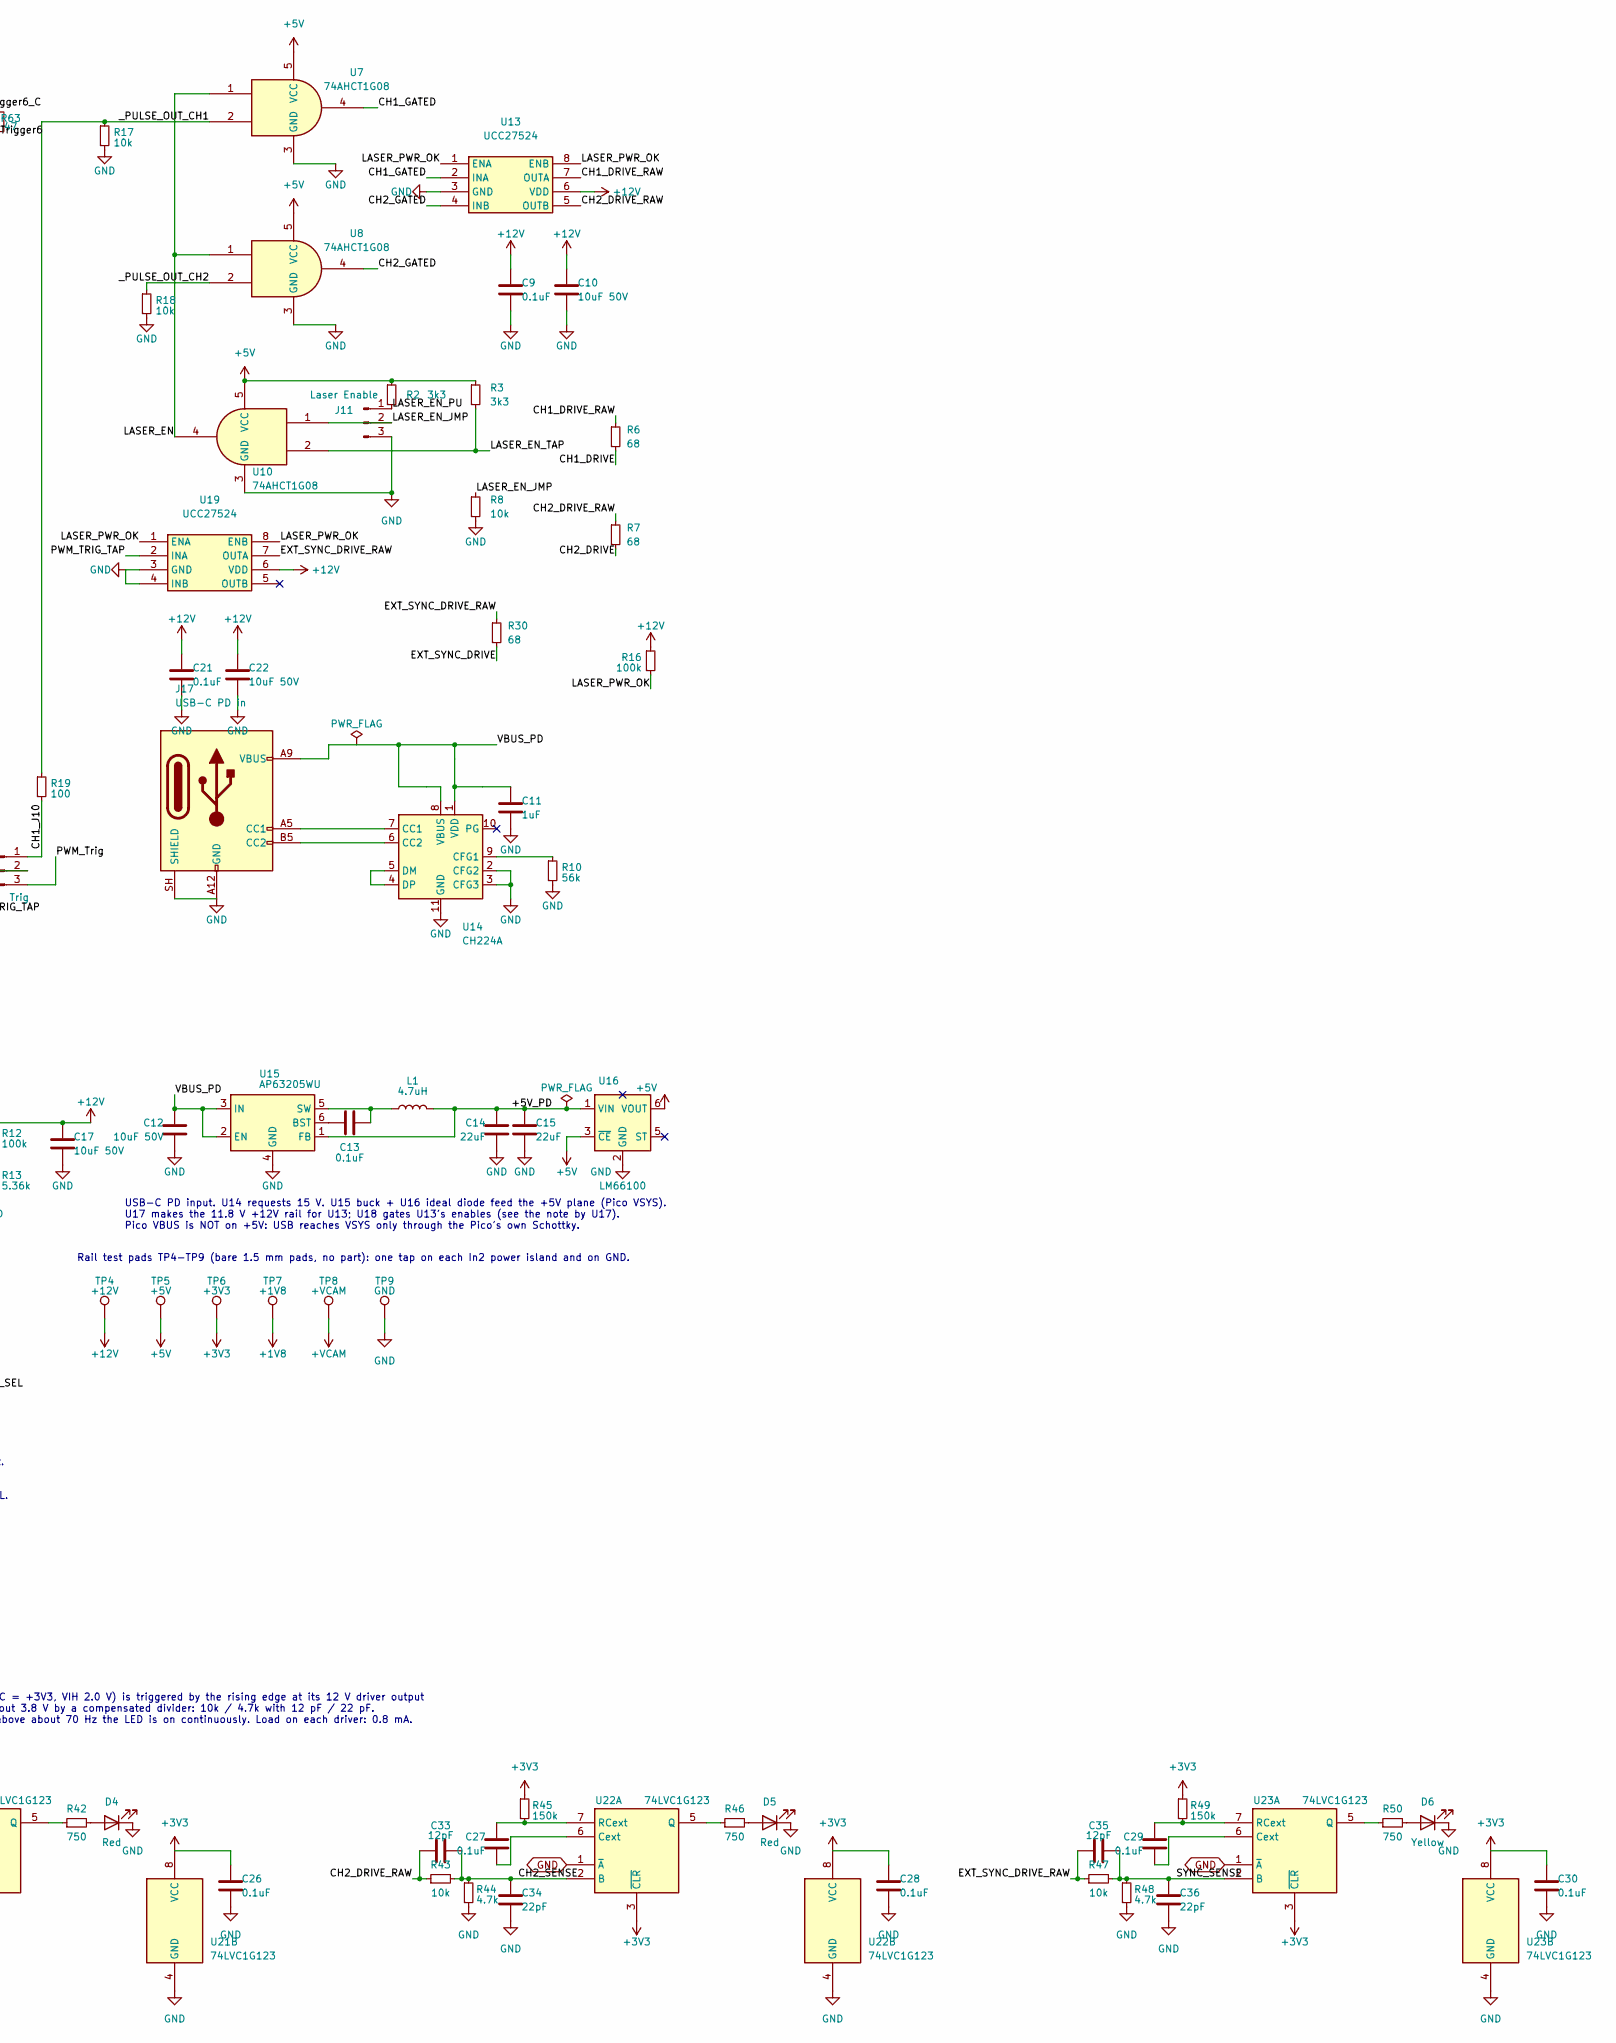
[picture p12: schematic PiEBV_Pico.kicad_sch, Event-camera Synchronizer, IDS EVS / Prophesee EVK4 (Pico 2), part in row 1, column 2]

Parts:
C1, C2, C3, C4, C5, C9, C13, C20, C21, C25, C26, C27, C28, C29, C30: 0.1uF; C_0805_2012Metric_Pad1.18x1.45mm_HandSolder
C6, C11, C16, C23, C24: 1uF; C_0805_2012Metric_Pad1.18x1.45mm_HandSolder
C7: 2.2uF; C_0805_2012Metric_Pad1.18x1.45mm_HandSolder
C10, C12, C17, C22: 10uF 50V; C_1206_3216Metric_Pad1.33x1.80mm_HandSolder
C14, C15: 22uF; C_0805_2012Metric_Pad1.18x1.45mm_HandSolder
C18: 22nF; C_0805_2012Metric_Pad1.18x1.45mm_HandSolder
C19: 10nF; C_0805_2012Metric_Pad1.18x1.45mm_HandSolder
C31, C33, C35: 12pF; C_0805_2012Metric_Pad1.18x1.45mm_HandSolder
C32, C34, C36: 22pF; C_0805_2012Metric_Pad1.18x1.45mm_HandSolder
D1: Blue; LED_0805_2012Metric_Pad1.15x1.40mm_HandSolder
D2: Green; LED_0805_2012Metric_Pad1.15x1.40mm_HandSolder
D3, D4, D5: Red; LED_0805_2012Metric_Pad1.15x1.40mm_HandSolder
D6: Yellow; LED_0805_2012Metric_Pad1.15x1.40mm_HandSolder
J1, J2, J3, J4, J5, J6: Conn_02x05_Odd_Even; IDC-Header_2x05_P2.54mm_Vertical
J7: Laser 1; BNC_Kinghelm_KH-BNC50-3511_Horizontal
J8: Laser 2; BNC_Kinghelm_KH-BNC50-3511_Horizontal
J10: Trig; PinHeader_1x03_P2.54mm_Vertical
J11: Laser Enable; PinHeader_1x03_P2.54mm_Vertical
J12: Ext Sync Out; BNC_Kinghelm_KH-BNC50-3511_Horizontal
J14: Pico Socket A; PinSocket_1x20_P2.54mm_Vertical
J15: Pico Socket B; PinSocket_1x20_P2.54mm_Vertical
J17: USB-C PD in; USB_C_Receptacle_HRO_TYPE-C-31-M-17_EdgeTrim
J18: Laser 1 mode; PinHeader_1x03_P2.54mm_Vertical
J19: Laser 2 mode; PinHeader_1x03_P2.54mm_Vertical
J20: Clock jumper; PinHeader_1x02_P2.54mm_Vertical
J21: Ext sync mode; PinHeader_1x03_P2.54mm_Vertical
J22: 3V3 camera I/O; PinHeader_1x02_P2.54mm_Vertical
L1: 4.7uH; L_Cenker_CKCS4030
Q1, Q2: 2N7002; SOT-23
R2, R3: 3k3; R_0805_2012Metric_Pad1.20x1.40mm_HandSolder
R6, R7, R30: 68; R_2512_6332Metric_Pad1.40x3.35mm_HandSolder
R8, R9, R17, R18, R24, R34, R39, R43, R47, R70: 10k; R_0805_2012Metric_Pad1.20x1.40mm_HandSolder
R10: 56k; R_0805_2012Metric_Pad1.20x1.40mm_HandSolder
R12, R16, R38: 100k; R_0805_2012Metric_Pad1.20x1.40mm_HandSolder
R13: 5.36k; R_0805_2012Metric_Pad1.20x1.40mm_HandSolder
R19, R33: 100; R_0805_2012Metric_Pad1.20x1.40mm_HandSolder
R20, R42, R46, R50: 750; R_0805_2012Metric_Pad1.20x1.40mm_HandSolder
R21, R41, R45, R49: 150k; R_0805_2012Metric_Pad1.20x1.40mm_HandSolder
R22: 1.2k; R_0805_2012Metric_Pad1.20x1.40mm_HandSolder
R23, R40, R44, R48, R51: 4.7k; R_0805_2012Metric_Pad1.20x1.40mm_HandSolder
R25, R26, R31: 47; R_2512_6332Metric_Pad1.40x3.35mm_HandSolder
R27, R28, R32: 82; R_2512_6332Metric_Pad1.40x3.35mm_HandSolder
R29, R35, R36, R37: 1k; R_0805_2012Metric_Pad1.20x1.40mm_HandSolder
R52, R53, R54, R55, R56, R57, R58, R59, R60, R61, R62, R63, R64, R65, R66, R67, R68, R69: 47; R_0805_2012Metric_Pad1.20x1.40mm_HandSolder
TP3: 1MHz sync + GND; PinHeader_1x02_P2.54mm_Horizontal_EdgeTrim
TP4: +12V; TestPoint_Pad_D1.5mm
TP5: +5V; TestPoint_Pad_D1.5mm
TP6: +3V3; TestPoint_Pad_D1.5mm
TP7: +1V8; TestPoint_Pad_D1.5mm
TP8: +VCAM; TestPoint_Pad_D1.5mm
TP9: GND; TestPoint_Pad_D1.5mm
U1, U5: 74LVC1G04; SOT-23-5_HandSoldering
U2, U4, U6: SN74LVC04AD; SOIC127P600X175-14N
U3: 74LVC1G00; SOT-23-5_HandSoldering
U7, U8, U10: 74AHCT1G08; SOT-23-5_HandSoldering
U9: NCP718xSN180; SOT-23-5_HandSoldering
U11: Raspberry Pi Pico 2 W
U13, U19: UCC27524; SOIC-8_3.9x4.9mm_P1.27mm
U14: CH224A; SSOP-10-1EP_3.9x4.9mm_P1mm_EP2.1x3.3mm
U15: AP63205WU; TSOT-23-6_HandSoldering
U16: LM66100; SOT-363_SC-70-6
U17: LT3065EMSE; MSOP-12-1EP_3x4.039mm_P0.65mm_EP1.651x2.845mm
U18: TPS3700DDC; SOT-23-6
U20: TPS2116DRL; SOT-583-8
U21, U22, U23: 74LVC1G123; SSOP-8_2.95x2.8mm_P0.65mm

Connections:
+1V8: C7.1, TP7.1, U9.5 (VCC), U20.3 (VIN1)
+3V3: C24.1, C26.1, C28.1, C30.1, J15.5, R24.1, R34.1, R41.1, R45.1, R49.1, R70.1, TP6.1, U11.36 (3V3_OUT), U20.5 (MODE), U20.6 (VIN2), U21.3 (~CLR), U21.8 (VCC), U22.3 (~CLR), U22.8 (VCC), U23.3 (~CLR), U23.8 (VCC)
+5V: C4.1, C5.1, C6.1, J15.2, R2.1, R3.1, R36.1, TP5.1, U7.5 (VCC), U8.5 (VCC), U9.1 (IN), U9.3 (GND), U10.5 (VCC), U11.39 (VSYS), U16.3 (~CE), U16.6 (VOUT)
+5V_PD: C14.1, C15.1, L1.2, U15.1 (FB), U16.1 (VIN)
+12V: C9.2, C10.2, C17.1, C20.1, C21.2, C22.2, R12.1, R16.1, R21.1, TP4.1, U13.6 (VDD), U17.11 (OUT), U17.12 (OUT), U18.5 (VDD), U19.6 (VDD)
+VCAM: C1.1, C2.1, C3.1, C23.1, R33.1, R51.1, TP8.1, U1.5 (VCC), U2.14 (VCC), U3.5 (VCC), U4.14 (VCC), U5.5 (VCC), U6.14 (VCC), U20.2 (VOUT), U20.7 (VOUT)
ARMED_LED: J15.19, Q2.1 (G), R38.1, U11.22 (GP17)
CH1_DRIVE: J18.1, R6.2, R25.1
CH1_DRIVE_RAW: C31.1, R6.1, R39.1, U13.7 (OUTA)
CH1_GATED: U7.4, U13.2 (INA)
CH1_J10: J10.1, R19.2
CH1_OUT: J7.1 (In), J18.2, R25.2
CH1_SENSE: C31.2, C32.1, R39.2, R40.1, U21.2 (B)
CH1_TERM: J18.3, R27.1
CH2_DRIVE: J19.1, R7.2, R26.1
CH2_DRIVE_RAW: C33.1, R7.1, R43.1, U13.5 (OUTB)
CH2_GATED: U8.4, U13.4 (INB)
CH2_OUT: J8.1 (In), J19.2, R26.2
CH2_SENSE: C33.2, C34.1, R43.2, R44.1, U22.2 (B)
CH2_TERM: J19.3, R28.1
CLK_SEL: J14.14, R29.2, U11.14 (GP10)
CLK_SEL_JMP: J20.1, R29.1
EXT_SYNC_DRIVE: J21.1, R30.2, R31.1
EXT_SYNC_DRIVE_RAW: C35.1, R30.1, R47.1, U19.7 (OUTA)
EXT_SYNC_OUT: J12.1 (In), J21.2, R31.2
EXT_SYNC_TERM: J21.3, R32.1
GND: C1.2, C2.2, C3.2, C4.2, C5.2, C6.2, C7.2, C9.1, C10.1, C11.2, C12.2, C14.2, C15.2, C16.2, C17.2, C18.2, C19.2, C20.2, C21.1, C22.1, C23.2, C24.2, C26.2, C28.2, C30.2, C32.2, C34.2, C36.2, D1.1 (K), D4.1 (K), D5.1 (K), D6.1 (K), J1.2, J1.7, J2.2, J2.7, J3.2, J3.7, J4.2, J4.7, J5.2, J5.7, J6.2, J6.7, J7.2 (Ext), J8.2 (Ext), J11.3, J12.2 (Ext), J14.3, J14.8, J14.13, J14.18, J15.3, J15.8, J15.13, J15.18, J17.A12 (GND), J17.B12 (GND), J17.SH (SHIELD), J20.2, J22.1, Q1.2 (S), R8.2, R9.2, R10.2, R13.2, R17.2, R18.2, R20.2, R23.2, R27.2, R28.2, R32.2, R38.2, R40.2, R44.2, R48.2, R51.2, TP3.2, TP9.1, U1.3 (GND), U2.7 (GND), U3.3 (GND), U4.7 (GND), U5.3 (GND), U6.7 (GND), U7.3 (GND), U8.3 (GND), U9.2 (GND), U10.3 (GND), U11.3 (GND), U11.8 (GND), U11.13 (GND), U11.18 (GND), U11.23 (GND), U11.28 (GND), U11.33 (AGND), U11.38 (GND), U13.3 (GND), U14.2 (CFG2), U14.3 (CFG3), U14.11 (GND), U15.4 (GND), U16.2 (GND), U17.9 (GND), U17.13 (EP), U18.2 (GND), U19.3 (GND), U19.4 (INB), U20.1 (GND), U21.1 (~A), U21.4 (GND), U22.1 (~A), U22.4 (GND), U23.1 (~A), U23.4 (GND)
LASER_EN: R37.1, U7.1, U8.1, U10.4
LASER_EN_JMP: J11.2, R8.1, U10.1
LASER_EN_PU: J11.1, R2.2
LASER_EN_TAP: R3.2, U10.2
LASER_PWR_OK: Q1.1 (G), R16.2, U13.1 (ENA), U13.8 (ENB), U18.1 (OUTA), U18.6 (OUTB), U19.1 (ENA), U19.8 (ENB)
unnamed: D1.2 (A), R33.2
unnamed: D2.2 (A), R36.2
unnamed: D2.1 (K), Q1.3 (D), Q2.2 (S)
unnamed: D3.2 (A), R37.2
unnamed: D3.1 (K), Q2.3 (D)
unnamed: D4.2 (A), R42.2
unnamed: D5.2 (A), R46.2
unnamed: D6.2 (A), R50.2
unnamed: J17.A5 (CC1), U14.7 (CC1)
unnamed: J17.B5 (CC2), U14.6 (CC2)
unnamed: J22.2, R35.1
unnamed: R10.1, U14.9 (CFG1)
unnamed: U14.4 (DP), U14.5 (DM)
unnamed: C13.1, U15.6 (BST)
unnamed: C13.2, L1.1, U15.5 (SW)
unnamed: R12.2, R13.1, U17.10 (ADJ)
unnamed: C19.1, U17.8 (BYP)
unnamed: C18.1, R20.1, U17.5 (IMAX)
unnamed: R21.2, R22.1, U18.3 (INA+)
unnamed: R22.2, R23.1, U18.4 (INB-)
unnamed: C25.2, U21.6 (Cext)
unnamed: R42.1, U21.5 (Q)
unnamed: C25.1, R41.2, U21.7 (RCext)
unnamed: C27.2, U22.6 (Cext)
unnamed: R46.1, U22.5 (Q)
unnamed: C27.1, R45.2, U22.7 (RCext)
unnamed: C29.2, U23.6 (Cext)
unnamed: R50.1, U23.5 (Q)
unnamed: C29.1, R49.2, U23.7 (RCext)
PIXRST_GATE: J15.20, R24.2, U3.1 (NC), U3.2, U11.21 (GP16)
PIXRST_N: U3.4, U4.1 (1A), U4.3 (2A), U4.5 (3A), U4.9 (4A), U4.11 (5A), U4.13 (6A)
PWM_1MHz: J14.20, TP3.1, U1.2, U11.20 (GP15)
PWM_TRIG_TAP: J10.2, R9.1, U5.2, U19.2 (INA)
PWM_Trig: J10.3, J14.15, U11.15 (GP11)
SYNC_N: U1.4, U2.1 (1A), U2.3 (2A), U2.5 (3A), U2.9 (4A), U2.11 (5A), U2.13 (6A)
SYNC_SENSE: C35.2, C36.1, R47.2, R48.1, U23.2 (B)
Sync1: R52.1, U2.2 (1Y)
Sync1_C: J1.5, R52.2
Sync2: R53.1, U2.4 (2Y)
Sync2_C: J2.5, R53.2
Sync3: R54.1, U2.6 (3Y)
Sync3_C: J3.5, R54.2
Sync4: R55.1, U2.8 (4Y)
Sync4_C: J4.5, R55.2
Sync5: R56.1, U2.10 (5Y)
Sync5_C: J5.5, R56.2
Sync6: R57.1, U2.12 (6Y)
Sync6_C: J6.5, R57.2
TDRSTN1: R64.1, U4.2 (1Y)
TDRSTN1_C: J1.3, R64.2
TDRSTN2: R65.1, U4.4 (2Y)
TDRSTN2_C: J2.3, R65.2
TDRSTN3: R66.1, U4.6 (3Y)
TDRSTN3_C: J3.3, R66.2
TDRSTN4: R67.1, U4.8 (4Y)
TDRSTN4_C: J4.3, R67.2
TDRSTN5: R68.1, U4.10 (5Y)
TDRSTN5_C: J5.3, R68.2
TDRSTN6: R69.1, U4.12 (6Y)
TDRSTN6_C: J6.3, R69.2
TRIG_N: U5.4, U6.1 (1A), U6.3 (2A), U6.5 (3A), U6.9 (4A), U6.11 (5A), U6.13 (6A)
Trigger1: R58.2, U6.2 (1Y)
Trigger1_C: J1.4, R58.1
Trigger2: R59.2, U6.4 (2Y)
Trigger2_C: J2.4, R59.1
Trigger3: R60.2, U6.6 (3Y)
Trigger3_C: J3.4, R60.1
Trigger4: R61.2, U6.8 (4Y)
Trigger4_C: J4.4, R61.1
Trigger5: R62.2, U6.10 (5Y)
Trigger5_C: J5.4, R62.1
Trigger6: R63.2, U6.12 (6Y)
Trigger6_C: J6.4, R63.1
VBUS_PD: C11.1, C12.1, C16.1, J17.A9 (VBUS), J17.B9 (VBUS), U14.1 (VDD), U14.8 (VBUS), U15.2 (EN), U15.3 (IN), U17.1 (IN), U17.2 (IN), U17.3 (SHDN)
VCAM_SEL: R34.2, R35.2, R70.2, U20.4 (PR1)
_PULSE_OUT_CH1: J14.17, R17.1, R19.1, U7.2, U11.17 (GP13)
_PULSE_OUT_CH2: J14.16, R18.1, U8.2, U11.16 (GP12)

Notes on the sheet:
USB-C PD input. U14 requests 15 V. U15 buck + U16 ideal diode feed the +5V plane (Pico VSYS). U17 makes the 11.8 V +12V rail for U13; U18 gates U13's enables (see the note by U17). Pico VBUS is NOT on +5V: USB reaches VSYS only through the Pico's own Schottky.
LASER 1 OUTPUT (J7)
LASER 2 OUTPUT (J8)
Output mode, one shunt per channel (J18 = Laser 1, J19 = Laser 2, J21 = Ext sync): 1-2 50 ohm: series 47R bypassed. 4.54-5.14 V into a 50 ohm load (PicoLas LDP-V); ~12 V open circuit. 2-3 Hi-Z: 68R + 47R in series, 82R shunt -> 4.55-5.08 V open circuit from a 47-50 ohm source (back-terminated, no o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
U3 = NAND with both inputs on PIXRST_GATE: via U4 the cameras get TDRSTN = PIXRST_GATE. Only the Pico (GP16, PIXGATE) resets the pixels. R24 holds the gate high otherwise.
U17: 11.8 V laser rail, 400 mA limit (R20). U18 (sheet bottom left) holds U13 disabled (LASER_PWR_OK low) unless +12V is inside 10.6-13.3 V (TPS3700 window).
J20 clock jumper on GP10, read at every start. Shunt fitted: 300 MHz. Open: 150 MHz (rated). R29: protects GP10 if driven into the shunt. Internal pull-up only: no capacitor on CLK_SEL.
EXT SYNC OUTPUT (J12)
Camera I/O supply +VCAM (U1-U6). J22 open: 1.8 V (IDS uEye EVS). J22 fitted: 3.3 V (Prophesee EVK4). U20 (MODE high): PR1 high = VIN1 (+1V8), PR1 low = VIN2 (+3V3). R34 holds PR1 high with J22 open. A bridge from PR1 to pin 3 or pin 5, an open MODE pin or a missing Pico cannot give 3.3 V. D1 (blue)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
Status LEDs. D2 (green): +12 V in its window (LASER_PWR_OK). D3 (red) ARMED: current flows LASER_EN -> D3 -> Q2 -> Q1, so D3 is lit only if J11 is closed (LASER_EN), the firmware is ARMED (GP17 high) and +12 V is good.
Output activity LEDs. Each monostable (VCC = +3V3, VIH 2.0 V) is triggered by the rising edge at its 12 V driver output (after all three laser gates), divided to about 3.8 V by a compensated divider: 10k / 4.7k with 12 pF / 22 pF. One pulse gives a flash of about 15 ms; above about 70 Hz the LED is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
Rail test pads TP4-TP9 (bare 1.5 mm pads, no part): one tap on each In2 power island and on GND.

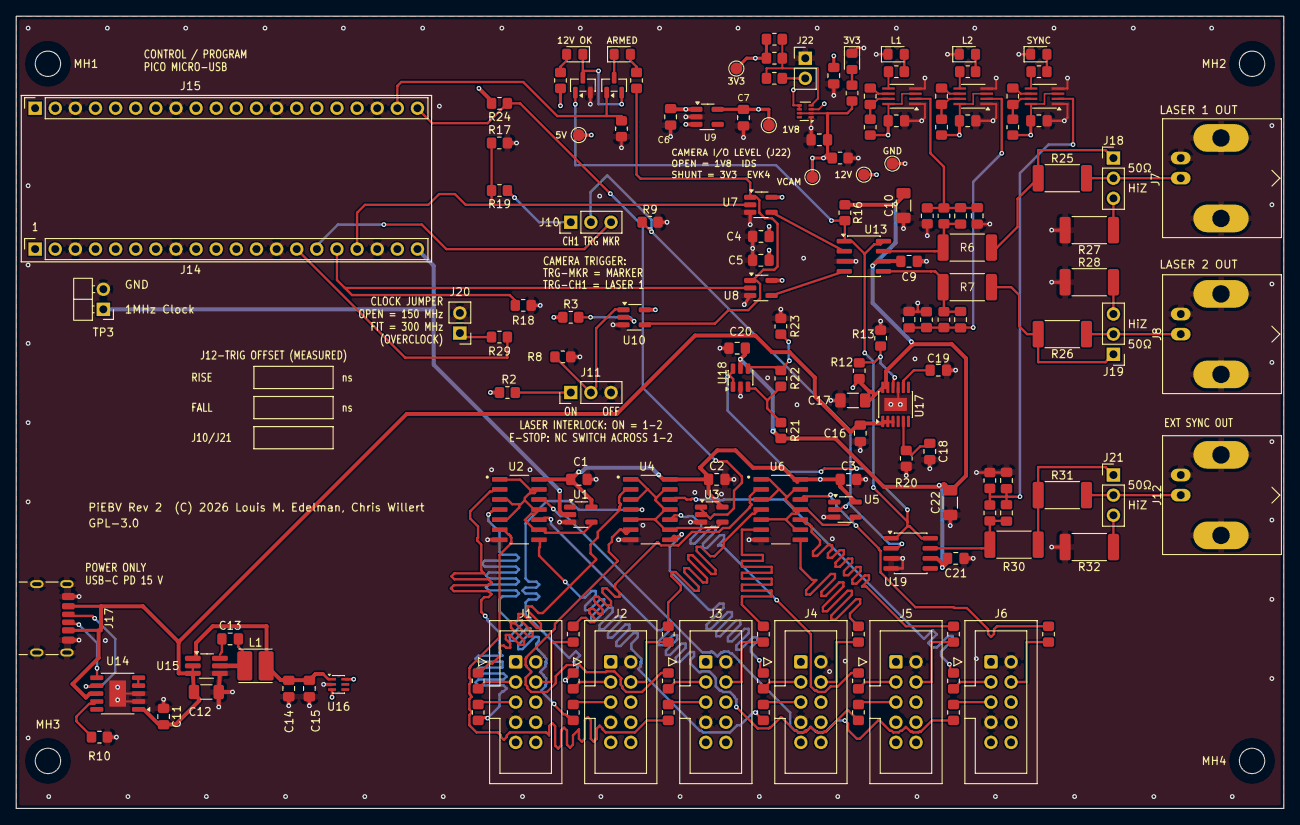
[picture p13: board PiEBV_Pico.kicad_pcb from above]

Board: 4 copper layers, 160.0 x 100.0 mm, 159 parts (0 on the bottom side), 109 nets.

Other parts of the board:
MH1, MH2, MH3, MH4: MountingHole_3.2mm_M3
