Low-Boom/PiEBV/tools/signal_sim/rev2_sim.py

"""rev2_sim.py - Rev 2 additions to the signal simulation (selectable camera I/O voltage, power islands).

Run after signal_sim.py, with the same Python (KiCad 10 Python on Windows; python3 with numpy and
libngspice on Linux):
    python rev2_sim.py
Inputs: geometry.json, devices.json (block "rev2"), ../rev2/work/final/plane.json if present.
Output: results_rev2.md and results_rev2.json next to this file.

Cases:
  1  camera trigger delay and J12-minus-camera offset at +VCAM = 1.8 V and 3.3 V
  2  camera harness: level and edge at the camera end of the ribbon (IDS input at 1.8 V, EVK4 opto input at 3.3 V)
  3  +VCAM budget: DC level at the EVK4 input, supply current
  4  activity-LED sense dividers: level at the monostable input, shortest pulse, load on the output
  5  In2 island gap under a B.Cu track (PWM_1MHz, PWM_TRIG_TAP): delay and reflection
Values marked "est" in devices.json are estimates; the report repeats that mark.
"""
import copy
import json
import os
import sys

import numpy as np

import signal_sim as S

HERE = os.path.dirname(os.path.abspath(__file__))
R2 = S.DEV["rev2"]
md, RES = [], {}
P = md.append
f, table, node = S.f, S.table, S.node


def model_for(vcam):
    """A Model whose camera gates run at vcam. The gate table of signal_sim is switched in place."""
    if vcam > 2.5:
        for k, g in R2["gates_3v3"].items():
            S.GATES[k] = copy.deepcopy(g)
    else:
        for k in R2["gates_3v3"]:
            S.GATES[k] = copy.deepcopy(BASE_GATES[k])
    return S.Model(sp)


sp = S.Spice(S.KICAD_BIN)
BASE_GATES = copy.deepcopy(S.GATES)

# ============================================================================ case 1
P("# Rev 2 simulation results\n")
P("Generated by `rev2_sim.py`. It uses the models of `signal_sim.py` and the block `rev2` of `devices.json`. "
  "Entries marked est in `devices.json` are estimates, not datasheet limits.\n")
P("## 1. Camera trigger delay and J12 offset at +VCAM = 1.8 V and 3.3 V\n")
P("GP11 edge start to the camera header pin 4 (J1-J6), reference level VCAM / 2, J10 on 2-3, GPIO 4 mA slow. "
  "J12 into 50 ohm through 1 m RG-58, referred to the BNC. The J12 path does not depend on +VCAM.\n")
rows, RES["case1"] = [], {}
for vcam in (1.8, 3.3):
    M = model_for(vcam)
    for corner in S.CORNERS:
        a = M.stage_a("23", None, 4, "slow", "typ")
        r = {}
        for edge in S.EDGES:
            cam = S.camera_delays(M, a, corner, edge)
            j12 = S.j12_delay(M, a, "UCC27524_new", corner, edge)
            r[edge] = dict(cam_min=min(cam), cam_max=max(cam), j12=j12)
        RES["case1"]["%.1f_%s" % (vcam, corner)] = r
        rows.append(["%.1f V" % vcam, corner] + [f(r[e][k]) for e in S.EDGES for k in ("cam_min", "cam_max")]
                    + [f(r[e]["j12"] - (r[e]["cam_min"] + r[e]["cam_max"]) / 2) for e in S.EDGES])
P(table(["+VCAM", "corner", "camera rise min (ns)", "max", "camera fall min (ns)", "max",
         "J12 minus camera, rise (ns)", "fall (ns)"], rows))
allo = [RES["case1"][k][e]["j12"] - c for k in RES["case1"] for e in S.EDGES
        for c in (RES["case1"][k][e]["cam_min"], RES["case1"][k][e]["cam_max"])]
P("\nThe three corners use the same corner for the camera gates and for U19, as signal_sim.py does in its own "
  "offset table; that table also crosses the corners. At 3.3 V the camera gates are faster, so J12 is later "
  "relative to the camera pin than at 1.8 V. Measure the offset for the +VCAM setting in use "
  "(Hardware.md, first-board check 4).\n")

# ============================================================================ case 2
P("## 2. Camera harness: level and edge at the camera end\n")
H = R2["harness"]
E4 = R2["evk4_input"]
P("One U2 / U4 / U6 output (SN74LVC04A) drives its routed board line (`Trigger3` as the example), then a "
  "ribbon wire pair (Z0 %.0f ohm, %.1f ns/m, est) and the camera input. IDS: %.0f pF (est). EVK4: opto input, "
  "%.0f ohm + LED (est, see devices.json), %.0f pF.\n" % (H["z0_ohm"], H["td_ns_per_m"], R2["ids_input"]["c_pF"],
                                                        E4["r_series_ohm"], E4["c_pF"]))


def harness_case(vcam, corner, load, length_m, rs=None, net="Trigger3", pin="J3.4", out="U6.6"):
    """rs: value of the on-board series resistor (None: the fitted value; 0: as Rev 1, no resistor)."""
    g = (R2["gates_3v3"] if vcam > 2.5 else BASE_GATES)["SN74LVC04A"]
    vk = "v3v3" if vcam > 2.5 else "v1v8"
    amp = {"min": "max", "typ": "typ", "max": "min"}[corner]      # fast corner = high supply
    v = R2["vcam"][vk][amp]
    c = S.Ckt("harness %s %s %s %.1f m" % (vcam, corner, load, length_m), S.TMAX_PS)
    ta, tb, te = 5.0, 105.0, 205.0
    r = g["rout"][corner]
    S.add_switch_out(c, "u6", node(out), v, r, r, g["ramp_ns_est"][corner], ta, tb, start_high=False)
    c.cam_net(net, rs)
    c.C(node(pin), S.BP["header_pin_pF_est"])
    c.R(node(pin), "hw_in", max(H["r_ohm_per_m"] * length_m * 2, 1e-3))        # wire resistance, signal and return
    c.T("hw_in", "cam", H["z0_ohm"], H["td_ns_per_m"] * length_m)
    if load == "evk4":
        c.add(".model DOPTO D(IS=%g N=%g RS=1)" % (E4["led_is"], E4["led_n"]))
        c.R("cam", "led_a", E4["r_series_ohm"])
        c.add("D%s led_a 0 DOPTO" % c.uid())
        c.C("cam", E4["c_pF"])
    else:
        c.C("cam", R2["ids_input"]["c_pF"])
        c.R("cam", "0", 1e7)
    c.tran(te)
    t, w = sp.run(c.lines, [node(pin), "cam"] + (["led_a"] if load == "evk4" else []))
    vc = w["cam"]
    hi = float(vc[(t > tb - 5) & (t < tb)].mean())
    lo = float(vc[t > te - 5].mean())
    res = dict(v_supply=v, high=hi, low=lo, vmax=float(vc[(t >= ta) & (t < tb)].max()), vmin=float(vc[t >= tb].min()),
               t50_rise=S.cross(t, vc, v / 2, True, ta, tb) - ta, t50_fall=S.cross(t, vc, v / 2, False, tb, te) - tb)
    if load == "evk4":
        res["i_led_mA"] = 1e3 * (hi - float(w["led_a"][(t > tb - 5) & (t < tb)].mean())) / E4["r_series_ohm"]
        res["t_vih_rise"] = S.cross(t, vc, E4["vih_min"], True, ta, tb) - ta
        res["t_vil_fall"] = S.cross(t, vc, E4["vil_max"], False, tb, te) - tb
        res["ring_low_after_rise"] = float(vc[(t > ta + res["t_vih_rise"] + 0.5) & (t < tb)].min())
        res["ring_high_after_fall"] = float(vc[(t > tb + res["t_vil_fall"] + 0.5)].max())
    return res


rows, RES["case2"] = [], {}
RS = {"ids": H["series_r_ohm"], "evk4": H["series_r_ohm"]}
for vcam, load in ((1.8, "ids"), (3.3, "evk4")):
    for L in H["lengths_m"]:
        for rs in (0.0, RS[load]):
            for corner in S.CORNERS:
                r = harness_case(vcam, corner, load, L, rs)
                RES["case2"]["%s_%.1f_%.1fm_rs%g_%s" % (load, vcam, L, rs, corner)] = r
                rows.append([load.upper(), "%.1f V" % vcam, "%.1f m" % L, "%g" % rs, corner, f(r["high"], 2), f(r["vmax"], 2),
                             f(r["vmin"], 2), f(r["t50_rise"]), f(r.get("i_led_mA"), 2) if load == "evk4" else "-",
                             f(r.get("ring_low_after_rise"), 2) if load == "evk4" else "-"])
P(table(["camera", "+VCAM", "ribbon", "on-board series R (ohm)", "corner", "high (V)", "peak (V)", "lowest after the fall (V)",
         "rise to VCAM/2 (ns)", "EVK4 LED current (mA)", "EVK4: lowest level after the rise (V)"], rows))


def sel(load, rs):
    return [r for k, r in RES["case2"].items() if k.startswith(load) and ("_rs%g_" % rs) in k]


e0, e1 = sel("evk4", 0.0), sel("evk4", RS["evk4"])
i0, i1 = sel("ids", 0.0), sel("ids", RS["ids"])
P("\nThe ribbon is a transmission line with an open end (IDS) or a high-resistance end (EVK4). Without a series resistor "
  "the output resistance of U2 / U4 / U6 is lower than the line impedance at the fast and typical corners, so the edge "
  "overshoots at the camera. The output resistances at the min and typ corners are estimates.\n")
P("- **EVK4 at 3.3 V, no series resistor:** steady level %.2f-%.2f V, LED current %.1f-%.1f mA, peak %.2f V, "
  "%.2f V after a falling edge, and the level falls back to %.2f V after a rising edge (the camera manual gives 2.5 V "
  "as the lowest high level and 5.5 V as the highest input voltage)." % (
      min(r["high"] for r in e0), max(r["high"] for r in e0), min(r["i_led_mA"] for r in e0), max(r["i_led_mA"] for r in e0),
      max(r["vmax"] for r in e0), min(r["vmin"] for r in e0), min(r["ring_low_after_rise"] for r in e0)))
P("- **EVK4 at 3.3 V, on-board %.0f ohm (R52-R63):** steady level %.2f-%.2f V (2.5 V or more is "
  "needed), LED current %.1f-%.1f mA (2.7 mA or more), peak %.2f V, %.2f V after a falling edge, lowest level after a "
  "rising edge %.2f V." % (RS["evk4"], min(r["high"] for r in e1), max(r["high"] for r in e1), min(r["i_led_mA"] for r in e1),
                         max(r["i_led_mA"] for r in e1), max(r["vmax"] for r in e1), min(r["vmin"] for r in e1),
                         min(r["ring_low_after_rise"] for r in e1)))
P("- **IDS at 1.8 V, no series resistor (the Rev 1 condition, with the ribbon in the model):** peak %.2f V and "
  "%.2f V after a falling edge at the fast corner. IDS documents these pins as 1.8 V and publishes no input "
  "protection data." % (max(r["vmax"] for r in i0), min(r["vmin"] for r in i0)))
P("- **IDS at 1.8 V, on-board %.0f ohm (R52-R69):** peak %.2f V, %.2f V after a falling edge; the "
  "edge at the camera is %.1f ns later at most.\n" % (RS["ids"], max(r["vmax"] for r in i1), min(r["vmin"] for r in i1),
                                                    max(a["t50_rise"] - b["t50_rise"] for a, b in zip(i1, i0))))
bad = [harness_case(3.3, c, "ids", 2.0) for c in S.CORNERS]
RES["case2"]["ids_at_3v3"] = bad
P("**Wrong J22 setting (3.3 V with an IDS camera):** the 1.8 V pin would see %.2f-%.2f V steady and %.2f V peak. "
  "That is why J22 stays open with IDS cameras.\n" % (min(r["high"] for r in bad), max(r["high"] for r in bad),
                                                      max(r["vmax"] for r in bad)))

# All 18 lines with their own routed geometry and resistor, at the fast corner (the largest overshoot), 2 m ribbon.
P("### All camera lines\n")
P("Each of the 18 lines with its own routed copper, its on-board %.0f ohm resistor (R52-R69) and its stub to the "
  "header pin, at the fast corner (the largest overshoot) with the longest ribbon. The EVK4 has no pixel-reset "
  "input, so `TDRSTN` is run for IDS only.\n" % H["series_r_ohm"])
GROUPS = (("Sync", "U2", 5), ("Trigger", "U6", 4), ("TDRSTN", "U4", 3))
YPIN = [2, 4, 6, 8, 10, 12]
rows, RES["case2_all"] = [], {}
for vcam, load in ((1.8, "ids"), (3.3, "evk4")):
    for gname, u, jpin in GROUPS:
        if load == "evk4" and gname == "TDRSTN":
            continue
        rr = [harness_case(vcam, "min", load, max(H["lengths_m"]), None, "%s%d" % (gname, i), "J%d.%d" % (i, jpin),
                           "%s.%d" % (u, YPIN[i - 1])) for i in range(1, 7)]
        RES["case2_all"]["%s_%s" % (load, gname)] = rr
        rows.append([load.upper(), "%.1f V" % vcam, gname + "1-6", f(min(r["high"] for r in rr), 2) + " - " + f(max(r["high"] for r in rr), 2),
                     f(max(r["vmax"] for r in rr), 2), f(min(r["vmin"] for r in rr), 2),
                     f(min(r["t50_rise"] for r in rr)) + " - " + f(max(r["t50_rise"] for r in rr)),
                     f(min(r["ring_low_after_rise"] for r in rr), 2) if load == "evk4" else "-"])
P(table(["camera", "+VCAM", "lines", "high (V)", "highest peak (V)", "lowest after the fall (V)", "rise to VCAM/2 (ns)",
         "EVK4: lowest level after the rise (V)"], rows))
P("\nThe rise time includes the board line and %.1f m of ribbon. The spread of the rise time in a group is the "
  "residual skew of the model at the camera end.\n" % max(H["lengths_m"]))

# ============================================================================ case 3
P("## 3. +VCAM budget\n")
vc = R2["vcam"]
g33 = R2["gates_3v3"]["SN74LVC04A"]
rows = []
RES["case3"] = {}
for name, vs, ro, ron, L in (("worst", vc["v3v3"]["min"], g33["rout"]["max"], vc["mux_ron_ohm"]["max"], 2.0),
                             ("typical", vc["v3v3"]["typ"], g33["rout"]["typ"], vc["mux_ron_ohm"]["typ"], 2.0)):
    # one input: supply - mux drop (all 12 inputs high) - (rout + cable R + R_series) * I = Vf(I); solve by iteration
    i = 5e-3
    for _ in range(60):
        vf = E4["led_n"] * 0.02585 * np.log(i / E4["led_is"] + 1.0)
        rs = ro + H["r_ohm_per_m"] * L * 2 + E4["r_series_ohm"] + 1.0
        i = max((vs - ron * 12 * i - vf) / rs, 1e-6)
    v_in = vf + (E4["r_series_ohm"] + 1.0) * i
    RES["case3"][name] = dict(i_mA=1e3 * i, v_in=v_in, total_peak_mA=12e3 * i, mux_drop_mV=1e3 * ron * 12 * i)
    rows.append([name, f(vs, 2), f(ro, 1), f(1e3 * i, 2), f(v_in, 2), f(12e3 * i, 0), f(1e3 * ron * 12 * i, 1)])
P(table(["case", "+3V3 (V)", "U2/U6 output resistance (ohm)", "LED current per input (mA)", "level at the EVK4 input (V)",
         "6 cameras, Sync and Trigger high together (mA)", "drop in U20 (mV)"], rows))
P("\nSix EVK4 cameras draw at most %.0f mA from +VCAM while Sync and Trigger are both high, and about half of that "
  "on average (Sync is a 50 %% clock, the marker duty is at most 50 %%). The source is the Pico 3V3_OUT pin "
  "(Raspberry Pi recommends a load below 300 mA). With six IDS cameras at 1.8 V the load is CMOS inputs only "
  "(no DC current).\n" % RES["case3"]["typical"]["total_peak_mA"])

# ============================================================================ case 4
P("## 4. Activity-LED sense dividers (R39/R40 + C31/C32, R43/R44 + C33/C34, R47/R48 + C35/C36)\n")
SN = R2["sense"]


def sense_case(ch, corner, width_ns, dname="UCC27524_new"):
    M = S.Model(sp)
    k = M.CHAINS[ch]
    d = S.DRV[dname]
    amp = S.AMP[corner]
    vdd = S.OC["vdd12"][amp]
    c = S.Ckt("sense %s %s %g ns" % (ch, corner, width_ns), S.TMAX_PS)
    ta = 2.0
    S.add_switch_out(c, ch + "d", node(k["drv"]), vdd, d["roh"][corner], d["rol"][corner], S.DRVC["ramp_ns"][corner],
                     ta, ta + width_ns, start_high=False)
    j, far = M.add_chain(c, ch, "50", 1.0, "50", amp)
    c.tran(ta + width_ns + 60.0)
    t, w = sp.run(c.lines, [node("%s_sense" % ch), far])
    v = w[node("%s_sense" % ch)]
    above = t[v > SN["vih_min"]]
    hi = float(v[(t > ta + width_ns - 1.0) & (t < ta + width_ns)].mean()) if width_ns >= 50 else None
    return dict(vmax=float(v.max()), t_above=float(above[-1] - above[0]) if len(above) else 0.0, vdd=vdd,
                far_max=float(w[far].max()), level=hi)


rows, RES["case4"] = [], {}
for ch, name in (("ch1", "Laser 1"), ("ch2", "Laser 2"), ("ext", "Ext Sync")):
    for width in (10.0, 20.0, 100.0):
        r = {c: sense_case(ch, c, width) for c in S.CORNERS}
        RES["case4"]["%s_%g" % (ch, width)] = r
        rows.append([name, "%g ns" % width] + [f(r[c]["vmax"], 2) for c in S.CORNERS] + [f(min(r[c]["t_above"] for c in S.CORNERS), 1)])
P(table(["output", "pulse at the driver output", "peak at pin B, min corner (V)", "typ", "max", "shortest time above %.1f V (ns)" % SN["vih_min"]], rows))
worst = min(min(r[c]["t_above"] for c in S.CORNERS) for k, r in RES["case4"].items() if k.endswith("_20"))
worst10 = min(min(r[c]["t_above"] for c in S.CORNERS) for k, r in RES["case4"].items() if k.endswith("_10"))
vpk = max(r[c]["vmax"] for k, r in RES["case4"].items() if "_" in k and k != "amplitude" for c in S.CORNERS)
lv = [r[c]["level"] for k, r in RES["case4"].items() if k.endswith("_100") for c in S.CORNERS]
P("\nThe monostables run from +3V3: high threshold %.1f V (%s), inputs rated to %.1f V. The settled level at pin B is "
  "%.2f-%.2f V; the highest peak is %.2f V. The monostable needs %.1f ns above its threshold (%s). The shortest laser "
  "pulse of the firmware is 20 ns (10 ns with the 300 MHz clock jumper): the input is above the threshold for at least "
  "%.1f ns (20 ns pulse) and %.1f ns (10 ns pulse). Corners: min = fast driver at the highest +12V, max = slow driver "
  "at the lowest +12V.\n" % (SN["vih_min"], SN["vih_src"], SN["vin_max"], min(lv), max(lv), vpk, SN["tw_min_ns"],
                            SN["tw_src"], worst, worst10))
# load on the output: amplitude at the 50 ohm load with and without the divider
M = S.Model(sp)
with_div = {c: M.stage_out(("ch1",), "UCC27524_new", c, "50", 1.0, "50")["ch1"]["far"]["high"] for c in S.CORNERS}
saved = S.SENSE
S.SENSE = None
M0 = S.Model(sp)
no_div = {c: M0.stage_out(("ch1",), "UCC27524_new", c, "50", 1.0, "50")["ch1"]["far"]["high"] for c in S.CORNERS}
S.SENSE = saved
RES["case4"]["amplitude"] = dict(with_divider=with_div, without=no_div)
P(table(["corner", "J7 level into 50 ohm without the divider (V)", "with the divider (V)", "change (mV)"],
        [[c, f(no_div[c], 4), f(with_div[c], 4), f(1e3 * (with_div[c] - no_div[c]), 1)] for c in S.CORNERS]))
i_div = 12.0 / (SN["r_top"] + SN["r_bot"])
P("\nEach divider draws %.2f mA from its driver while the output is high (%.0f mW in the %.0f ohm resistor). "
  "The level at the BNC changes by the driver's output resistance times this current. C_top in series with C_bot "
  "adds about %.0f pF to the driver output.\n" % (1e3 * i_div, 1e3 * i_div ** 2 * SN["r_top"], SN["r_top"],
                                                   1.0 / (1.0 / SN["c_top_pF"] + 1.0 / (SN["c_bot_pF"] + SN["ci_pF"] + 3.0))))

# ============================================================================ case 5
P("## 5. In2 island gap under a B.Cu track\n")
PG = R2["plane_gap"]
import extract_geometry as EG                                         # field solver (needs KiCad's pcbnew to import)

st = S.GEOM["stackup"]
gapz = {}
h_far = 0.2104 + 0.0152 + 1.065                                      # B.Cu to In1 (GND) when In2 is missing
for w in (0.3, 0.5):
    z_cp, e_cp = EG.fd_line(w, h_far, 0.035, 4.5, mask_t=0.010, mask_er=EG.MASK_ER, gap=0.3, ncell_h=42, air=5.0, half=6.0)
    z_ms, e_ms = EG.fd_line(w, h_far, 0.035, 4.5, mask_t=0.010, mask_er=EG.MASK_ER, gap=None, ncell_h=42, air=5.0, half=6.0)
    gapz[w] = dict(z_cpw=z_cp, e_cpw=e_cp, z_ms=z_ms, e_ms=e_ms)


def lay_of(w):
    """Z0 and delay of a B.Cu track over an island: geometry.json if that width is in it, else the field solver."""
    k = "B.Cu_w%.3f" % w
    if k in S.LAYERS:
        return S.LAYERS[k]
    z, e = EG.fd_line(w, 0.2104, 0.035, 4.5, mask_t=0.010, mask_er=EG.MASK_ER)
    return {"z0_ohm": z, "td_ps_per_mm": 1e3 * np.sqrt(e) / 299.792458}


RES["case5"] = {"line": {str(k): v for k, v in gapz.items()}, "runs": {}}
P("Over the 0.5 mm gap between two islands the track has no plane 0.21 mm below it. Its return current uses the "
  "B.Cu GND pour beside the track (0.3 mm away on both sides, continuous across the gap) and the In1 GND plane "
  "(1.29 mm away). Field solver (`extract_geometry.fd_line`), track with pour and far plane / with the far plane only:\n")
P(table(["track width", "Z0 over an island (ohm)", "Z0 over the gap, with the B.Cu pour (ohm)", "Z0 over the gap, no pour (ohm)"],
        [["%.1f mm" % w, f(lay_of(w)["z0_ohm"], 1), f(gapz[w]["z_cpw"], 1), f(gapz[w]["z_ms"], 1)] for w in (0.3, 0.5)]))


def gap_case(w, zgap, egap, l1, l2, vdrv, rdrv, ramp):
    lay = lay_of(w)
    out = {}
    for with_gap in (False, True):
        c = S.Ckt("gap %s" % with_gap, 1.0)
        ta, tb = 2.0, 22.0
        S.add_switch_out(c, "d", "src", vdrv, rdrv, rdrv, ramp, ta, tb, start_high=False)
        c.T("src", "g1", lay["z0_ohm"], lay["td_ps_per_mm"] * l1 * 1e-3)
        if with_gap:
            td = PG["run_mm"] * np.sqrt(egap) / 299.792458             # ns
            c.C("g1", td / zgap * 1e3 / 2)
            c.L("g1", "g2", zgap * td)
            c.C("g2", td / zgap * 1e3 / 2)
        else:
            c.T("g1", "g2", lay["z0_ohm"], lay["td_ps_per_mm"] * PG["run_mm"] * 1e-3)
        c.T("g2", "rx", lay["z0_ohm"], lay["td_ps_per_mm"] * l2 * 1e-3)
        c.C("rx", 5.0)
        c.tran(40.0)
        t, wv = sp.run(c.lines, ["src", "rx"])
        out[with_gap] = (t, wv["rx"], wv["src"])
    t0, r0, s0 = out[False]
    t1, r1, s1 = out[True]
    d = S.cross(t1, r1, vdrv / 2, True, 2.0, 22.0) - S.cross(t0, r0, vdrv / 2, True, 2.0, 22.0)
    r1i = np.interp(t0, t1, r1)
    return dict(delay_ps=1e3 * d, max_dev_mV=1e3 * float(np.abs(r1i - r0).max()))


rows = []
for net, w, l1, l2 in (("PWM_1MHz", 0.5, 79.0, 5.0), ("PWM_TRIG_TAP", 0.3, 33.0, 40.0)):
    for label, zk, ek in (("with pour", "z_cpw", "e_cpw"), ("no pour (bound)", "z_ms", "e_ms")):
        r = gap_case(w, gapz[w][zk], gapz[w][ek], l1, l2, 3.3, 40.0, 1.0)
        RES["case5"]["runs"]["%s_%s" % (net, zk)] = r
        rows.append([net, PG["crossings"][net], label, f(gapz[w][zk], 0), f(r["delay_ps"], 1), f(r["max_dev_mV"], 0)])
P("\nLine of the net's length with a 40 ohm, 1 ns, 3.3 V source and a 5 pF load; %.1f mm of the line replaced by the "
  "gap impedance, against the same line without a gap:\n" % PG["run_mm"])
P(table(["net", "crossing (plane_check.py)", "gap model", "Z0 over the gap (ohm)", "added delay at the load (ps)",
         "largest change of the load waveform (mV)"], rows))
P("\nEvery B.Cu camera track (Sync, Trigger, TDRSTN) stays over the +VCAM island (`plane_check.py`), so no camera "
  "line crosses a gap. `PWM_1MHz` and `PWM_TRIG_TAP` each cross one gap (+5V to +VCAM). "
  "The other B.Cu tracks that change island carry DC or indicator signals (`LASER_PWR_OK`, `CH2_SENSE`, "
  "`SYNC_SENSE`, the D2 cathode link, `+12V`).\n")
pj = os.path.join(HERE, "..", "rev2", "work", "final", "plane.json")
if os.path.exists(pj):
    pl = json.load(open(pj))["routes"]
    P(table(["net", "B.Cu length (mm)", "over", "island changes"],
            [[n, f(pl[n]["length"], 1), ", ".join("%s %.1f" % kv for kv in sorted(pl[n]["over"].items(), key=lambda q: -q[1])),
              len(pl[n]["crossings"])] for n in sorted(pl) if n.startswith(("PWM_", "Sync", "TDRSTN", "Trigger", "PIXRST"))]))
    P("")
P("Generated with %d ngspice runs.\n" % sp.runs)
open(os.path.join(HERE, "results_rev2.md"), "w", encoding="utf-8").write("\n".join(md))
json.dump(RES, open(os.path.join(HERE, "results_rev2.json"), "w"), indent=1, default=float)
print("rev2_sim: %d runs -> results_rev2.md" % sp.runs)
