Low-Boom/PiEBV/tools/timing_check/check_sync.py

"""The camera sync output is fixed at 1 MHz, independent of pulse settings.

SYNC comes from the RP2350 clock generator (clk_gpout) with a 16.16 divider of clk_sys."""
import os
import subprocess
from fractions import Fraction as F
from math import floor

HARNESS = os.environ.get("PIDG_HARNESS") or os.path.join(
    os.path.dirname(os.path.abspath(__file__)), "harness.exe" if os.name == "nt" else "harness")


def rnd(x):
    return floor(x + F(1, 2))


def fmt3(x):
    v = rnd(x * 1000)
    return "%d.%03d" % (v // 1000, v % 1000)


clks = [150000000, 125000000, 133000000, 200000000, 48000000, 300000000]  # 300 MHz: clock jumper
cases = [(clk, 1000, 100, 10000, 2000) for clk in clks]
inp = "\n".join(" ".join(map(str, c)) for c in cases) + "\n"
out = subprocess.run([HARNESS], input=inp, capture_output=True, text=True).stdout.splitlines()
assert len(out) == len(cases)
bad = 0
for clk, line in zip(clks, out):
    div = rnd(F(clk * 65536, 1000000))
    if line.startswith("ERR"):
        bad += 1
        print("unexpected rejection", clk, line)
        continue
    fields = line.split()
    actual = fmt3(F(clk * 65536, div))
    if int(fields[19]) != div or fields[20] != actual:
        bad += 1
        print("mismatch", clk, fields[19:21], div, actual)
    if clk in (150000000, 300000000) and (div != (clk // 1000000) << 16 or actual != "1000000.000"):
        bad += 1
        print("board clock is not an exact 1 MHz divider", clk, div, actual)
print("fixed 1 MHz sync clock rates", len(cases), "bad", bad)
