Low-Boom/PiEBV/(commit log)

2026-09-20 Add Raspberry Pi Pico PIV delay generator (firmware + hardware redesign)
    Ports the Teensy 4.1-based IDS EVS camera/laser synchronizer to a Raspberry
    Pi Pico: PIO state machines replace CPU busy-wait pulse timing, a new
    line-based ASCII serial protocol replaces the SimpleSerialShell command set,
    and the KiCad hardware is redesigned around the Pico with a proper 50-ohm
    laser driver stage (the original had none). The Teensy version is kept
    untouched under "Chris Teensy Version" as the reference baseline.
    [IDS_EVS_Synchronizer.kicad_pcb, IDS_EVS_Synchronizer.kicad_sch, PiDG_Pico.kicad_pcb, PiDG_Pico.kicad_sch]
2026-09-20 Update project for Pico 2 W RP2350
    [PiDG_Pico.kicad_sch]
2026-09-21 AI been working at it
    [PiDG_Pico.kicad_sch]
2026-09-21 Mor AI workings
    [PiDG_Pico-B_Cu.gbl, PiDG_Pico-B_Mask.gbs, PiDG_Pico-B_Paste.gbp, PiDG_Pico-B_Silkscreen.gbo, PiDG_Pico-Edge_Cuts.gm1, PiDG_Pico-F_Cu.gtl, PiDG_Pico-F_Mask.gts, PiDG_Pico-F_Paste.gtp]
2026-09-21 Catching up on commits
    [PiDG_Pico.kicad_pcb, PiDG_Pico_drc_violations.json]
2026-09-21 Error free board
    [PiDG_Pico.kicad_pcb, PiDG_Pico.kicad_sch, PiDG_Pico_drc_violations.json]
2026-09-21 A few manual tweaks to MHz output pin location
    [PiDG_Pico.kicad_pcb, PiDG_Pico.kicad_sch]
2026-09-22 Refined and ready version
    [PiDG_Pico.kicad_pcb, PiDG_Pico.kicad_sch, PiDG_Pico_BOM.csv, PiDG_Pico_drc_violations.json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]
2026-09-22 Update Pico 4-layer board project
    [PiDG_Pico.kicad_pcb, PiDG_Pico.kicad_sch, PiDG_Pico_drc_violations.json]
2026-09-22 Fix J15 socket pin mapping, bond all Pico grounds, clean net names
    The J15 socket row was wired assuming pad m = Pico pin 20+m. The Pico
    numbers like a DIP (down pins 1-20, back up 21-40), so pin 40 faces pin
    1 and the correct relation is pad m = pin 41-m. J14 was already correct,
    which fixed the geometry unambiguously.
    As wired, inserting a module would have shorted its own 3V3_OUT to the
    ground plane (J15.5), driven 5V into GP16/GP17 (J15.19/20), left the
    logic bank U1-U6 unpowered (J15.16), and left the +5V rail with no
    source at all (VBUS/VSYS unconnected). Neither ERC nor DRC can see this:
    the symbol is self-consistent and U11 has no board footprint by design.
    - J15 remapped: +5V -> p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
    [PiDG_Pico.kicad_pcb, PiDG_Pico.kicad_sch, PiDG_Pico_drc_violations.json]
2026-09-23 Add interlock pull-down and CH2 probe point; clear all DRC/ERC warnings
    Board now reports 0 DRC violations and 0 ERC violations, with no warnings
    of any kind. Board and schematic pad->net maps reconcile exactly (213
    pads, 0 mismatches) and connectivity is bit-identical through the whole
    cleanup, verified by diffing pad->net maps before and after.
    Two parts added:
    - R8 (10k, 0805) pulls LASER_EN_JMP / U10 pin 1 down, so the laser
    interlock now fails safe. Previously that node floated whenever no
    jumper was fitted on J11 and could drift high, arming both lasers. With
    the J11 1-2 jumper fitted R2's 3k3 pull-up still wins at ~3.76 V,
    comfortably above the 74LVC1G08's 2.0 V VIH at VCC=5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
    [PiDG_Pico.kicad_pcb, PiDG_Pico.kicad_sch, PiDG_Pico_BOM.csv, PiDG_Pico_drc_violations.json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]
2026-09-23 Define the 4-layer physical stackup; add Hardware.md
    The board has used four copper layers (F.Cu GND pour / In1.Cu GND plane /
    In2.Cu +5V plane / B.Cu GND pour) since the redesign, but the stackup in
    (setup (stackup ...)) still described a 2-layer board: F.Cu -> 1.51 mm FR4
    core -> B.Cu, with no In1/In2 entries. DRC does not check the stackup, so
    this survived every clean check. It matters because the gerber job file
    takes LayerNumber, BoardThickness and the whole MaterialStackup array
    straight from it -- the fab would have been handed a 2-layer description
    of a 4-layer board.
    Replaced with a symmetric 1.6 mm arrangement matching JLCPCB's standard
    JLC04161H-7628: 0.035 Cu / 0.2104 prepreg /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
    [PiDG_Pico.kicad_pcb]
2026-09-23 Specify lead-free HASL copper finish
    The stackup previously left copper_finish unspecified. Set it to
    "HAL lead-free": RoHS compliant, and the cheapest compliant option at
    quick-turn fabs -- a small premium over leaded HASL and well below ENIG,
    which is the usual paid upgrade.
    HASL is safe here. The finest pitch on the board is 0.95 mm (SOT-23-5),
    with no BGA and no fine-pitch QFN, so the uneven deposit does not matter
    even at lead-free's slightly worse flatness. It also suits the board's
    hand-assembly bias -- every passive and SOT uses a _HandSolder footprint
    variant, and HASL arrives pre-tinned and reworks better than OSP.
    Verified in the exported gerber job file: Finish "HAL lead-free",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
    [PiDG_Pico.kicad_pcb]
2026-09-23 Record latest board validation
    [PiDG_Pico_drc_violations.json]
2026-09-23 Commit local KiCad project changes
2026-09-23 Restore 1.8 V camera I/O rail; rebuild pixel-reset input as a 3.3 V Schmitt
    The IDS UE-39B0XCP-E datasheet (part 1011378, rev 2026-01-09) documents
    its I/O connector pins 3/4/5 -- TDRSTN, Trigger input, SYNC -- as
    "(sensor), 1.8 V". The Teensy design's 1.8 V rail was therefore the
    camera signalling rail, not vestigial. The Pico redesign had deleted it
    and run the camera bank at 3.3 V, which would have driven 3.3 V into
    1.8 V sensor pins on all 18 lines of six cameras. The harness does no
    level translation, so the board itself must present 1.8 V.
    Camera rail:
    - Restore U9 = NCP718xSN180 (fixed 1.8 V LDO) at the Teensy's exact
    site. Feed it from +5 V rather than +3V3: NCP718 accepts 2.5-24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
    [PiDG_Pico.kicad_pcb, PiDG_Pico.kicad_sch, PiDG_Pico_BOM.csv, PiDG_Pico_drc_violations.json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]
2026-09-23 Add R9 pull-down on the J10 camera-trigger select node
    With no shunt fitted on J10, PWM_TRIG_TAP (J10.2, J16.2, U5.2) had no
    defined level: U5's input floated on ~145 mm of trace, which also runs
    up across the board to J16.2, and all six camera trigger lines followed
    it.
    R9 (10k, 0805) now pulls it to GND, so with J10 unshunted the triggers
    idle low -- their inactive state. 10k rather than a weaker pull: U5 runs
    from the 1.8 V rail (VIL 0.63 V), and at the datasheet's worst-case 5 uA
    input leakage 100k would sit at 0.5 V with only 0.13 V to spare, where
    10k holds it at 0.05 V and rejects coupled noise ten times better. The
    selected GPIO sees an extra 330 uA when J10 is shunted. Same value a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
    [PiDG_Pico.kicad_pcb, PiDG_Pico.kicad_sch, PiDG_Pico_BOM.csv, PiDG_Pico_drc_violations.json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]
2026-09-23 Laser path: AHCT gates, firmware safety limits for PicoLas LDP-V drivers
    The laser outputs must trigger PicoLas LDP-V 10-70 and LDP-V 240-100
    drivers. This commit fixes the two problems in that path that need no
    design decision. The third -- output amplitude -- is documented as the
    blocking open item pending a choice of supply for a 10 V driver rail.
    U7, U8, U10: 74LVC1G08 -> 74AHCT1G08
    - At VCC = 5 V an LVC input needs 0.7 x VCC = 3.5 V to read high, but
    U7/U8 take their pulses straight from 3.3 V Pico GPIOs -- outside the
    guaranteed operating range at every normal USB voltage. AHCT has TTL
    input thresholds (high above 2.0 V): ~1.3 V of margin.
    - U10 swapped too: the J11/R2/R8 arming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
    [PiDG_Pico.kicad_pcb, PiDG_Pico.kicad_sch, PiDG_Pico_BOM.csv, PiDG_Pico_drc_violations.json]
2026-09-24 USB-C PD power input: 12 V laser-driver rail and 5 V into the VSYS plane
    J17 (USB-C, power only) + U14 CH224K request 15 V from a PD charger.
    - U15 AP63205WU buck + U16 LM66100 ideal diode feed the +5V plane (Pico
    VSYS). CE tied to VOUT for reverse blocking.
    - U17 LP2951 (adjustable, R12/R13 100k/11.3k 0.1 %) makes 12.0 V for the
    UCC27524. R14 1R gives the output ESR both TI LP2951 dies need.
    - U17 ~ERROR drives U13 ENA/ENB (LASER_PWR_OK, R16 pull-up): outputs are
    held low with no PD, before the contract, and on 5 V/9 V chargers.
    - R6/R7 47 -> 69.8 ohm: worst-case 4.55-5.16 V into the 50 ohm LDP-V
    trigger input (was ~2.4 V). C10 -> 10 uF 1206 on +12V.
    - Pico VBUS (J15.1) disconnected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
    [PiDG_Pico-B_Cu.gbl, PiDG_Pico-B_Cu.gbr, PiDG_Pico-B_Mask.gbr, PiDG_Pico-B_Mask.gbs, PiDG_Pico-B_Paste.gbp, PiDG_Pico-B_Paste.gbr, PiDG_Pico-B_Silkscreen.gbo, PiDG_Pico-B_Silkscreen.gbr]
2026-09-24 Update KiCad project files
2026-09-24 Update KiCad history snapshot
2026-09-24 Update KiCad hardware and schematic design
    [PiDG_Pico.kicad_pcb, PiDG_Pico.kicad_sch]
2026-09-24 Firmware: exact CH2 delay, disarmed boot with ARM/DISARM, watchdog, pinned build
    Timing (bug 1)
    - CH2 no longer fires 2 PIO cycles (13.3 ns) early: the delay is loaded as-is,
    since the fixed SET latency is common to every channel.
    - MARKER is phase-locked to CH1 (period = MARKERDIV x period in cycles; it
    used to drift at many frequencies).
    - New src/pulse_timing.h: all ns/Hz -> cycle conversion, validation and the
    laser limits in one hardware-free header. Every reply and STATUS shows the
    realized value, e.g. "OK DELAY=1003 (actual 1000.000 ns, 150 cyc)".
    - Laser limits are checked on realized cycles; widths that realize below 3
    cycles are rejected (WIDTH 0 used to pass the duty che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
    [board.h, check_exhaustive.py, check_marker_lock.py, check_random.py, check_sync.py, harness.cpp, laser_gate.cpp, laser_gate.h]
2026-09-24 Update KiCad history reference
2026-09-25 Final DFM/SI review: layout fixes, fresh fab outputs, JLC files, README
    Board (Pico Version 4Layer), from a fab / assembly / signal-integrity review:
    - U13 decoupling: C9 (0.1 uF 50 V) moved beside VDD pin 6 with its own GND
    via; GND pin 3 gets a direct plane via; +12V via moved under the package;
    R6/R7 shifted 2 mm out to make room. Loop ~1.5-2 nH, was 7-13 nH.
    - R19 100 ohm in series with J10 pin 1 (new net CH1_J10): with J10 on 1-2,
    the PWM_TRIG_TAP load made CH1 arrive 0.4-1.7 ns after CH2.
    - No vias left inside SMD pads except U14's exposed-pad thermal vias:
    13 moved off their pads (U13 ENA/ENB now joined on F.Cu), 9 nudged clear
    of neighbouring mask openings.
    - 47 edge stitch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
    [PiDG_Pico-B_Cu.gbr, PiDG_Pico-B_Mask.gbr, PiDG_Pico-B_Paste.gbr, PiDG_Pico-B_Silkscreen.gbr, PiDG_Pico-Edge_Cuts.gbr, PiDG_Pico-F_Cu.gbr, PiDG_Pico-F_Mask.gbr, PiDG_Pico-F_Paste.gbr]
2026-09-25 Silkscreen and docs: J11 E-stop wiring, J10 trigger-source key, TP4 CH2 scope point
    J11 now reads 'LASER INTERLOCK: ON = 1-2' and 'E-STOP: NC SWITCH ACROSS 1-2';
    J10 gets a 'CAMERA TRIGGER: TRG-MKR = MARKER / TRG-CH1 = LASER 1' key (its
    reference moved up); TP4 is labelled CH2 / GND / SCOPE ONLY (R9's reference
    moved clear). README and Hardware.md explain the fail-safe normally-closed
    switch across J11 1-2 and why J16.1 is not an E-stop input. DRC 0/0; gerbers,
    drills and zip regenerated.
    [PiDG_Pico-B_Cu.gbr, PiDG_Pico-B_Mask.gbr, PiDG_Pico-B_Paste.gbr, PiDG_Pico-B_Silkscreen.gbr, PiDG_Pico-Edge_Cuts.gbr, PiDG_Pico-F_Cu.gbr, PiDG_Pico-F_Mask.gbr, PiDG_Pico-F_Paste.gbr]
2026-09-25 JLC full-assembly order package: LCSC numbers for all 67 parts, THT in CPL, checklist
    - fab/jlc/PiDG_Pico_JLC_BOM.csv: 34 lines, every one with an LCSC number
    checked against JLC's library (2026-09-25); through-hole connectors and
    headers included so JLC fits everything.
    - fab/jlc/PiDG_Pico_JLC_CPL.csv: all 67 parts; through-hole parts at their
    pad centre (footprint origins are on pin 1).
    - fab/jlc/JLC_ORDER.md: order-form settings, remarks, parts needing Global
    Sourcing (CH224K and NCP718 out of stock; 69.8R stock thin), rotation
    checks, cost estimate, on-delivery steps and enclosure notes.
    - C6/C11 -> 1 uF 50 V (shares C16's basic part), C10 -> 10 uF 50 V (shares
    C12's part): t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
    [PiDG_Pico-B_Cu.gbr, PiDG_Pico-B_Mask.gbr, PiDG_Pico-B_Paste.gbr, PiDG_Pico-B_Silkscreen.gbr, PiDG_Pico-Edge_Cuts.gbr, PiDG_Pico-F_Cu.gbr, PiDG_Pico-F_Mask.gbr, PiDG_Pico-F_Paste.gbr]
2026-09-25 Move the Pico to the top edge; label the control and power USB ports
    J14/J15 and R17/R18 shifted 13.97 mm up so the Pico's micro-USB reaches the
    top board edge for an enclosure cut-out. GP10-13 and 3V3 traces stretched;
    PWM_Trig re-entered right of the CH1 run (crosses J15 between two unused
    pads as before). CH1/CH2 lengthen equally. TP3 moved 3 mm left for socket
    clearance with its spur re-jogged. Silkscreen: CONTROL / PROGRAM - PICO
    MICRO-USB and POWER ONLY - USB-C PD 15 V at the two ports. DRC 0/0, all 334
    pads match the schematic; gerbers, drills, zip and both placement files
    regenerated; README, Hardware.md and JLC checklist updated.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
    [PiDG_Pico-B_Cu.gbr, PiDG_Pico-B_Mask.gbr, PiDG_Pico-B_Paste.gbr, PiDG_Pico-B_Silkscreen.gbr, PiDG_Pico-Edge_Cuts.gbr, PiDG_Pico-F_Cu.gbr, PiDG_Pico-F_Mask.gbr, PiDG_Pico-F_Paste.gbr]
2026-09-25 J16 explicit silkscreen; TP3 overhang matched to J16
    J16 now reads ENABLE IN: PULL LOW = LASERS OFF / TRIG OUT: CAMERA TRIGGER
    (MONITOR) / GND, plus J16: NEVER FIT A SHUNT and NOT FAIL-SAFE - PUT THE
    E-STOP ON J11. TP3 moved 3.9 mm inboard so its pins overhang the top edge
    by 2.1 mm, the same as J16 on the right edge (spur re-jogged, labels moved).
    DRC 0/0; gerbers, drills, zip and placement files regenerated; README,
    Hardware.md and JLC checklist updated.
    [PiDG_Pico-B_Cu.gbr, PiDG_Pico-B_Mask.gbr, PiDG_Pico-B_Paste.gbr, PiDG_Pico-B_Silkscreen.gbr, PiDG_Pico-Edge_Cuts.gbr, PiDG_Pico-F_Cu.gbr, PiDG_Pico-F_Mask.gbr, PiDG_Pico-F_Paste.gbr]
2026-09-25 Docs: no BNC tees on the laser outputs; camera pins 1/6/8 are unconnected on the board
    Simulated J7+J8 into one 50 ohm input: 3.4 V per pulse, 6.9 V where the
    pulses overlap (above the LDP-V 5.2 V limit); one output into two drivers:
    3.0 V each. Camera header pins 1, 6, 8, 9, 10 are confirmed bare holes with
    no copper; the remaining risk is only in the harness.
2026-09-25 Firmware: COMBINE mode - the whole double pulse on both laser outputs
    COMBINE 1 sends CH1's pulse and CH2's pulse (exactly DELAY later) to BOTH
    Laser 1 and Laser 2, for one light source producing both PIV pulses or two
    sources fired in sync with the same double pulse. CH1 and CH2 then each run a
    dual-pin copy of the pulse program (SET PINS,3 on GP12-GP13, identical cycle
    timing); the shared PIO output latch gives each pin both pulses.
    Laser limits count both pulses per output: 2 x WIDTH x FREQ <= 0.1 %, and
    DELAY and period - DELAY each >= 10 us (kLaserMinSpacingNs, the LDP-V 10-70's
    100 kHz rating), which also rules out overlap. COMBINE changes only while
    DISARMED. The dual program is rese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
2026-09-25 COMBINE: drop the 10 us pulse-spacing limit; only require the pulses to stay separate
    The minimum spacing depended on one particular driver. COMBINE now only
    requires DELAY >= WIDTH + 1 PIO cycle (6.667 ns): at DELAY == WIDTH CH2 rises
    on the cycle CH1 falls and the two pulses would fuse into one of 2 x WIDTH.
    The duty limit still counts both pulses on each output.
    check_combined.py: accepted 254 / rejected 1246, 0 mismatches (a single-pin
    mutation fails all 254), plus a boundary test showing DELAY = WIDTH merges and
    WIDTH + 1 cycle separates. Fixed a window bug in the check's expected-edge list.
    Both envs build clean with strict warnings on src/.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
    [check_combined.py, pio_pulse.cpp, protocol.cpp, pulse_timing.h]
2026-09-25 Firmware: no laser-driver limits; DELAY <= 1/FREQ - 2 x WIDTH keeps pulse pairs apart
    The PicoLas LDP-V figures were only a reference for the electrical interface,
    so the firmware no longer imposes any driver rating: the 1 us width limit and
    the 0.1 % duty limit are removed (the spacing limit already was).
    New rule, per the user: DELAY <= 1/FREQ - 2 x WIDTH, so CH2 ends at least one
    WIDTH before the next pair's CH1 (also caps WIDTH at half the period).
    COMBINE keeps DELAY >= WIDTH + 1 cycle. Remaining checks are only what the PIO
    programs need (3-cycle minimum width, fit, marker and SYNC ranges).
    Docs: README and Hardware.md drop the driver limits and state the board's own
    output rating in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
    [check_combined.py, check_random.py, main.cpp, protocol.cpp, pulse_timing.h]
2026-09-25 12 V rail and laser output resistors upgraded: no board duty limit
    The laser outputs were limited by the board itself: R6/R7 were 0.125 W 0805
    (<= ~19 % duty into 50 ohm) and the LP2951 12 V regulator was rated 100 mA
    (both outputs high need ~200 mA). Now the board carries any duty the
    firmware accepts, even into a shorted BNC.
    - U17 LP2951 SOIC-8 -> LT3065EDD (adjustable, 45 V / 500 mA, DFN-10):
    R12/R13 101k/5.36k 0.1 % -> 11.9 V (11.65-12.17 V worst case), R20 750R
    sets a 400 mA current limit, C18 22 nF on IMAX, C19 10 nF on BYP, C17
    10 uF output cap. R14 (the LP2951's ESR resistor) removed.
    - New U18 TPS3700 window comparator (R21/R22/R23 1M/6.04k/31.6k, C20)
    drives LASER_PWR_OK: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
    [PiDG_Pico-B_Cu.gbr, PiDG_Pico-B_Mask.gbr, PiDG_Pico-B_Paste.gbr, PiDG_Pico-B_Silkscreen.gbr, PiDG_Pico-Edge_Cuts.gbr, PiDG_Pico-F_Cu.gbr, PiDG_Pico-F_Mask.gbr, PiDG_Pico-F_Paste.gbr]
2026-09-25 Move J10 into the open block east of TP4; TP4 2.54 mm west
    J10 (camera trigger select) was wedged between U13, U5/R9, its three-line
    key and TP4, whose labels ran into it so "CH1 TRG MKR CH2 GND" read like
    one 5-pin header. J10 now sits on its own at x 217-222, y 101, in the
    previously empty block east of TP4, with the CAMERA TRIGGER key to its
    right. TP4 moved 2.54 mm west into the space J10 left, ~9 mm from J10.
    - CH1_J10: F.Cu lane from R19 over TP4 (R19 still at the CH1 tap, so
    the laser CH1 timing is unchanged; TRG-CH1 camera trigger ~0.1 ns later).
    - PWM_Trig (marker): B.Cu run ends at a new via, F.Cu lane over TP4.
    - PWM_TRIG_TAP: ~20 mm branch off the x = 201.54 trunk, under TP4.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
    [PiDG_Pico-B_Cu.gbr, PiDG_Pico-B_Mask.gbr, PiDG_Pico-B_Paste.gbr, PiDG_Pico-B_Silkscreen.gbr, PiDG_Pico-Edge_Cuts.gbr, PiDG_Pico-F_Cu.gbr, PiDG_Pico-F_Mask.gbr, PiDG_Pico-F_Paste.gbr]
2026-09-25 Tidy the U12 pixel-reset input cluster
    The J12 -> U12 input ran as an 18 mm line at a slight angle, squeezed
    between U12's pins 4 and 5, because U12's input faced away from the BNC.
    C8 (U12's decoupling) sat 3 mm away and reached pin 5 through two vias,
    and R5 hung off a dog-leg to the west.
    - U12 rotated 180 degrees onto J12's centreline (y 120.65): PIXRST_IN is
    now one straight horizontal trace from U12 pin 2 to J12's centre pin.
    - R5 (3k3 pull-up) sits on that line; C8 directly under U12 pin 5 with
    its own GND via; one +3V3 line C8 -> R5 fed by a single via from the
    B.Cu +3V3 trunk (was three vias).
    - PIXRST leaves pin 4 horizontally into the existing 45-degree run.
    - DRC 0 / 0 unc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
    [PiDG_Pico-B_Cu.gbr, PiDG_Pico-B_Mask.gbr, PiDG_Pico-B_Paste.gbr, PiDG_Pico-B_Silkscreen.gbr, PiDG_Pico-Edge_Cuts.gbr, PiDG_Pico-F_Cu.gbr, PiDG_Pico-F_Mask.gbr, PiDG_Pico-F_Paste.gbr]
2026-09-25 Remove three orphan GND vias; give seven pour-only returns a pad stub
    - Removed the plane-only GND vias at (226.3, 71.6) and (228.5, 74.1),
    left over from the LP2951 layout, and (200.0, 86.5); no pad relies on
    them.
    - Kept the seven vias that are the only ground vias for U2, U4, U6
    (camera line drivers), U5, U7 and U9's caps C6/C7. Removing them would
    have put U4/U6 ground 10-13 mm of pour from the plane. Each now has a
    straight 0.4 mm stub from its pad instead of relying on thermal spokes
    in the pour.
    - Edge and SE-quadrant stitching unchanged.
    - DRC 0 / 0 unconnected, parity unchanged; gerbers, drill and zip
    regenerated.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
    [PiDG_Pico-B_Cu.gbr, PiDG_Pico-B_Mask.gbr, PiDG_Pico-B_Paste.gbr, PiDG_Pico-B_Silkscreen.gbr, PiDG_Pico-Edge_Cuts.gbr, PiDG_Pico-F_Cu.gbr, PiDG_Pico-F_Mask.gbr, PiDG_Pico-F_Paste.gbr]
2026-09-25 Move J16 to the top edge, between the Pico and J17
    J16 (EN in / TRIG out / GND right-angle header) moves from the right
    edge next to the BNCs to the top edge between the Pico and the USB-C
    input, pins pointing off the board with the same 2.1 mm overhang as TP3.
    - Pads at x 187.8 / 190.34 / 192.88, y 38 (rot 90).
    - TRIG comes straight up x 186 and over pad 1 into pad 2; EN comes up
    x 199 and under pads 3/2 into pad 1. All top layer, no vias, no
    crossings. The runs out to the right edge are gone: PWM_TRIG_TAP
    172 -> 122 mm, LASER_EN_TAP 67 -> 44 mm.
    - Silkscreen: EN / TRIG / GND under the pins and a four-line key below
    (NEVER FIT A SHUNT, EN IN pull low = lasers off, TRIG OUT monitor,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
    [PiDG_Pico-B_Cu.gbr, PiDG_Pico-B_Mask.gbr, PiDG_Pico-B_Paste.gbr, PiDG_Pico-B_Silkscreen.gbr, PiDG_Pico-Edge_Cuts.gbr, PiDG_Pico-F_Cu.gbr, PiDG_Pico-F_Mask.gbr, PiDG_Pico-F_Paste.gbr]
2026-09-25 gitignore: KiCad local history and lock files
    Ignore KiCad's per-project local history (.history/, its own git repo)
    and open-file lock files (*.lck), and stop tracking the
    "Pico Version 4Layer/.history" embedded-repo pointer that had been
    committed by accident. The history stays on disk for KiCad.
2026-09-25 gitignore: stop tracking and ignore backups
    Untrack the 20 KiCad MCP server board snapshots in
    "Pico Version 4Layer/.mcp-backups/" (they stay on disk) and ignore
    backup/autosave files going forward: .mcp-backups/, KiCad's
    *-backups/ and _autosave-* files, and *-bak / *.bak.
2026-09-29 Pixel-reset gate: optional camera pixel reset between pulse pairs
    The Pico can now hold every camera's pixels in reset (TDRSTN low)
    between pulse pairs, like a shutter, while the J12 BNC input keeps
    working exactly as before.
    Board
    - U3 74LVC1G04 -> 74LVC1G00 (NAND, same SOT-23-5 footprint): through U4
    the cameras get TDRSTN = J12 input AND PIXRST_GATE, so either source
    resets the pixels.
    - PIXRST_GATE = Pico GP16 (J15 pad 20) -> U3 pin 1 (previously NC), with
    R24 10k pull-up to +3V3 so the gate reads "no reset" unless driven low.
    Routed F.Cu from J15 pad 20, one B.Cu 45-degree hop, into U3 pad 1.
    - ERC 0, DRC 0 / 0 unconnected, no real parity net conflicts; gerbers,
    drill, zip, C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
    [PiDG_Pico-B_Cu.gbr, PiDG_Pico-B_Mask.gbr, PiDG_Pico-B_Paste.gbr, PiDG_Pico-B_Silkscreen.gbr, PiDG_Pico-Edge_Cuts.gbr, PiDG_Pico-F_Cu.gbr, PiDG_Pico-F_Mask.gbr, PiDG_Pico-F_Paste.gbr]
2026-09-29 Web GUI and protocol simulator
    tools/pidg_gui: a local web server (Python stdlib + pyserial) that drives the
    PiDG over USB serial. The browser page sets every parameter with the same
    commands as a serial terminal, shows each realized value, and draws the timing
    of one PIV pulse pair plus a three-pair sequence from the board's own STATUS.
    Two-step ARM; DISARM (button or Esc) is written immediately, bypassing any
    command in flight. Serves on 127.0.0.1 only by default; closing the page or
    stopping the server does not disarm. Any pyserial URL works as the target, so
    a future Wi-Fi link is --connect socket://host:port with no GUI change.
    tools/pidg_sim: the unmodified src/protocol.cpp and src/pu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
2026-09-29 GUI: fixed 1 MHz sync, no sync chart row, full-width console
    - The sync clock is no longer drawn: it runs continuously and carries no
    pulse timing.
    - SYNC is read-only in the GUI at 1 MHz. The IDS uEye EVS / Prophesee IMX636
    cameras count their 1 us event timestamps on it (Prophesee: Sync In "must be
    provided as a 1MHz pulse train"). The server refuses any other SYNC value
    from the settings API or the console; lines containing DISARM always pass.
    The row warns if the board reports another frequency.
    - The console is a full-width, resizable panel below the setting cards.
    - README: SYNC must stay at 1 MHz for these cameras, and why.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
2026-09-29 Marker on every pulse pair; remove MARKERDIV
    The camera trigger marker now fires with every pulse pair, rising with CH1,
    so every PIV pair has its own timestamped reference in each camera's event
    stream. There is no setting to mark fewer pairs: MARKERDIV is removed from
    PulseParams, STATUS, HELP and the GUI, and "MARKERDIV ..." now answers
    "ERR MARKERDIV removed: the marker fires with every pulse pair" so old host
    scripts fail clearly.
    - The marker runs the pulse program at exactly the CH1 period, started on
    the same cycle (RealizedTiming::markerPeriodCycles is gone).
    - New rule: MARKERWIDTH <= 1/FREQ - 5 cycles; the error names the largest
    width that fits. At the default 2 us, FREQ goe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
    [check_combined.py, check_exhaustive.py, check_marker_lock.py, check_pixgate.py, check_random.py, check_sync.py, harness.cpp, main.cpp]
2026-09-29 GUI: system info in the header; drop redundant "every pair" wording
    - The System card is gone. Its keys now sit on one compact line under the
    board identity in the header: PIO clock, last reset reason, watchdog
    resets, watchdog timeout and dropped reply bytes. A watchdog reset or
    dropped replies are flagged with a warning icon; the full line is in the
    tooltip. The header info shrinks at phone width instead of overflowing.
    - The marker firing with every pair is now the only behaviour, so the
    chart label, HELP text, README and GUI README no longer spell it out.
    [protocol.cpp, pulse_timing.h]
2026-09-29 GUI: no sync-clock row in the Cameras card
    SYNC is fixed at 1 MHz, so the Cameras card no longer shows it. If the
    board ever reports another sync frequency (changed outside the page), the
    header's system line shows a warning with how to restore it.
2026-09-29 GUI: one Timing settings card for the laser pulses and the camera marker
    MARKERWIDTH was the only field left in the Cameras card, so it joins FREQ,
    WIDTH, DELAY and COMBINE in a single Timing settings card with one Apply.
    Rows follow the page's own order (laser settings, then the marker) rather
    than STATUS order.
2026-09-29 GUI: arming as a short full-width strip above the timing diagram
    ARM, DISARM, the firmware arm state, start hold-off, HW status and the
    interlock note now sit in one short row above the charts; it wraps on
    narrow screens. Setting inputs are capped at 20em so they stay compact in
    the now wider settings cards.
2026-10-01 Laser outputs: jumper-selectable 50 ohm / Hi-Z mode per channel
    Each laser output gets a 1x3 mode jumper (J18 = Laser 1 / J7, J19 = Laser 2 /
    J8), a 47 ohm series resistor (R25/R26) and an 82 ohm shunt to GND (R27/R28),
    all 2 W 2512.
    - 1-2, 50 ohm mode: the 47 ohm is shorted, so the output is unchanged:
    4.61-5.08 V into the 50 ohm LDP-V input, ~12 V open circuit.
    - 2-3, Hi-Z mode: 47 ohm series + 82 ohm shunt give 4.62-5.06 V open circuit
    from a 47.8-49.6 ohm source, i.e. back-terminated, so a long cable into an
    unterminated input has no overshoot (<= 1.02x, 5.14 V max). Into 50 ohm it
    gives 2.3-2.6 V (an LDP-V will not fire).
    Board: the blocks sit in the free strip between R6/R7 an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
    [PiDG_Pico-B_Cu.gbr, PiDG_Pico-B_Mask.gbr, PiDG_Pico-B_Paste.gbr, PiDG_Pico-B_Silkscreen.gbr, PiDG_Pico-Edge_Cuts.gbr, PiDG_Pico-F_Cu.gbr, PiDG_Pico-F_Mask.gbr, PiDG_Pico-F_Paste.gbr]
2026-10-01 Laser outputs: equalise the CH1 and CH2 path lengths
    R6/R7 are not symmetric about the output-mode blocks' mirror line, so CH1 was
    1.88 mm longer than CH2 (U13 pad to the 47 ohm resistor). CH1's feed from R6
    now takes larger 45-degree corners (riser at x 224.4, upper corner landing on
    the R25 pad 1 centre), with no detour: both channels are 19.593 mm from U13
    to the series resistor, and every path on to the BNCs is mirrored, so the
    lengths match in both modes. DRC 0 / 0 unconnected; gerbers, drill files,
    zip and the stored DRC report regenerated; Hardware.md updated.
    [PiDG_Pico-B_Cu.gbr, PiDG_Pico-B_Mask.gbr, PiDG_Pico-B_Paste.gbr, PiDG_Pico-B_Silkscreen.gbr, PiDG_Pico-Edge_Cuts.gbr, PiDG_Pico-F_Cu.gbr, PiDG_Pico-F_Mask.gbr, PiDG_Pico-F_Paste.gbr]
2026-10-01 Docs: readability pass for non-experts in circuits
    - README: plain-language intro to PIV and what the box does, a glossary,
    a seven-point safety summary ahead of the details, an output-mode table,
    simpler jumper and connector text, condensed first-board checks linking
    to Hardware.md. Fixes the broken Contents link to Safety.
    - Hardware.md: new "How the board works" overview and term list; history
    and changelog asides removed; sections split (board output rating, power
    rails, trigger source, output mode); "Open items" renamed "First-board
    checks"; GP16 added to the socket pin table; parity count updated to 199
    with its breakdown; dangling reference to a scratch script removed.
    -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
2026-10-02 Update Pico hardware and fabrication files
    [PiDG_Pico.kicad_pcb, PiDG_Pico.kicad_sch, PiDG_Pico_BOM.csv, PiDG_Pico_JLC_BOM.csv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]
2026-10-05 Remove CH224A jumpers and update fabrication files
    [PiDG_Pico-B_Cu.gbr, PiDG_Pico-B_Mask.gbr, PiDG_Pico-B_Paste.gbr, PiDG_Pico-B_Silkscreen.gbr, PiDG_Pico-Edge_Cuts.gbr, PiDG_Pico-F_Cu.gbr, PiDG_Pico-F_Mask.gbr, PiDG_Pico-F_Paste.gbr]
2026-10-05 JLC cost-down and laser amplitude margin for the Pico board
    Availability and cost (JLC data of 2026-10-05):
    - U9: NCP718BSN180T1G (C892792), in stock; NCP718ASN180T1G has none.
    Same datasheet, pinout and +/-2 % 1.8 V output. Pre-order: 162 pcs.
    - R25/R26: Yageo AC2512FK-7W47RL (C7209419), higher stock.
    - U18 divider R21/R22/R23 -> 150k / 1.2k / 4.7k, all JLC basic parts
    (removes two extended lines).
    Laser amplitude margin:
    - U13 (UCC27524, SOIC-8 D package) has ROH 5 typ / 8.5 max ohm with no
    minimum (SLUSFA9), not the 2.5-7.5 ohm used before. With 101k the 50 ohm
    high corner reached 5.19 V (0.3 % below the 5.2 V limit).
    - R12 101k -> 100k 0.1 % (C122537): +12V is 11.8 V (11.54-12.0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
    [PiDG_Pico.kicad_pcb, PiDG_Pico.kicad_sch, PiDG_Pico_BOM.csv, PiDG_Pico_JLC_BOM.csv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]
2026-10-05 Pico BNCs: Kinghelm KH-BNC50-3511 as the default part
    - J7/J8/J12: Kinghelm KH-BNC50-3511 (C2837587, ~$0.93) replaces the
    Amphenol B6252HB-NPP3G-50 (C22457552, ~$3.61). 50 ohm only; never the
    KH-BNC75-3511. Saves about $34 per 5-board order.
    - New footprint PiDG_Local:BNC_Kinghelm_KH-BNC50-3511_Horizontal, made
    from the board instance: Amphenol pad pattern (Kinghelm drawing matches
    within 0.04 mm), pin holes 0.89 -> 0.90 mm (Kinghelm recommended size),
    post holes 2.01 mm unchanged. 3D model is still the Amphenol body.
    - Schematic and board fields (footprint, datasheet, description), BOMs,
    CPL, fp-lib-table description, Hardware.md and JLC_ORDER.md updated:
    test-fit two parts an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
    [PiDG_Pico-B_Cu.gbr, PiDG_Pico-B_Mask.gbr, PiDG_Pico-B_Paste.gbr, PiDG_Pico-B_Silkscreen.gbr, PiDG_Pico-Edge_Cuts.gbr, PiDG_Pico-F_Cu.gbr, PiDG_Pico-F_Mask.gbr, PiDG_Pico-F_Paste.gbr]
2026-10-05 JLC: corrected CPL rotations, BNC holes to JLC footprint, order checklist
    - tools/jlc_cpl: computes each part's JLC CPL rotation and centroid from
    JLC's own LCSC footprints (EasyEDA Pro, incl. encrypted ones) by pad
    matching. PiDG_Pico_JLC_CPL.csv regenerated: 36 of 80 rows change
    (SOT-23-5 +180, SOIC/DFN/SOT-23-6/TSOT/SC-70 +270, BNC +180, IDC,
    sockets and headers +270 with body-centre offsets; chip R/C unchanged).
    - J7/J8/J12 holes: pins 0.90 -> 1.00 mm, posts 2.01 -> 2.20 mm, matching
    JLC's KH-BNC50-3511 footprint (clearance after plating tolerance).
    Library footprint and board updated; zones refilled.
    - Manufacturing check (2026-10-05): all 42 BOM lines economic-and-standard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
    [PiDG_Pico-B_Cu.gbr, PiDG_Pico-B_Mask.gbr, PiDG_Pico-B_Paste.gbr, PiDG_Pico-B_Silkscreen.gbr, PiDG_Pico-Edge_Cuts.gbr, PiDG_Pico-F_Cu.gbr, PiDG_Pico-F_Mask.gbr, PiDG_Pico-F_Paste.gbr]
2026-10-05 JLC CPL: J16/TP3 right-angle headers by body direction
    JLC's footprints for the hanxia right-angle headers (C32713262 J16,
    C32713261 TP3) number the pins in mirror order relative to the body, so the
    pin-number match placed the body and pins inside the board instead of
    overhanging the top edge (seen in JLC's placement preview). Both rotate
    0 -> 180; header pins are identical, so the pin swap has no electrical effect.
    tools/jlc_cpl now exports the KiCad body centre (courtyard) and reads JLC's
    body (component-shape and pin layers). For pin headers/sockets it picks the
    rotation that puts the body on the KiCad body; other parts with a body
    mismatch are reported as CHECK and left unchanged. No ot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
    [PiDG_Pico_JLC_CPL.csv]
2026-10-05 Restructure: board project at the repo root; remove the Teensy design
    - Move the contents of "Pico Version 4Layer/" to the repo root (git mv):
    KiCad project, Hardware.md, BOM/CPL, fab/, libs/, lib tables.
    - Remove "Chris Teensy Version/" (the original Teensy 4.1 design); it stays
    in git history up to 8e10bc9. Hardware.md and src/main.cpp say so.
    - Update references: README (status, Hardware.md links, layout table),
    Hardware.md (src/, platformio.ini, tools/ paths), src/board.h comment,
    tools/jlc_cpl paths. KiCad lib tables use ${KIPRJMOD} (unchanged).
    - Checks: all Markdown links resolve; ERC/DRC identical to before (0
    errors, 0 unconnected); tools/jlc_cpl reproduces the CPL; pio ru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
    [IDS_EVS_Synchronizer.kicad_pcb, IDS_EVS_Synchronizer.kicad_sch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]
2026-10-05 Clean up: remove Teensy leftovers, redundant files and stale references
    - Teensy: remove libs/teensy.* and their lib-table entries, the orphaned
    cached teensy:Teensy4.1 symbol in the schematic, and all Teensy mentions
    in Hardware.md, README, src comments and part descriptions.
    - Redundant files: delete the KiCad-format PiDG_Pico_CPL.csv (the JLC CPL
    in fab/jlc/ is the only placement file), stale erc.json and
    PiDG_Pico_drc_violations.json, libs/RPi_Pico.pretty (only used by the
    unplaced U11's footprint field, now cleared), and the empty PlatformIO
    template folders include/, lib/, test/.
    - Move the master BOM to fab/PiDG_Pico_BOM.csv; docs updated.
    - fp-lib-table: drop 10 standard-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
    [PiDG_Pico.kicad_pcb, PiDG_Pico.kicad_sch, PiDG_Pico_BOM.csv, PiDG_Pico_drc_violations.json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]
2026-10-12 Switch README quick start to board setup
2026-10-12 Clarify board-first jumper setup
2026-10-12 Fix camera sync clock at 1 MHz
    [check_combined.py, check_pixgate.py, check_sync.py, harness.cpp, main.cpp, protocol.cpp, pulse_timing.h]
2026-10-12 Fix pixel-gate harness input format
    [check_pixgate.py]
2026-10-12 Update README with laser driver and restart instructions
    Removed outdated information about laser driver usage and board overload protection. Updated charger requirements and board restart instructions.
2026-10-15 SYNC: 1 MHz from the RP2350 clock generator on GP15 (was PIO on GP10)
    Firmware
    - New sync_clock.h/.cpp: clk_gpout1 divides clk_sys straight onto GP15
    (16.16 divider, exactly 150 at 150 MHz, DC50 duty correction): an exact,
    jitter-free 1 MHz square wave. The pin is held LOW until it starts.
    - Only GP13/15/21 (GP23-25 internal on the Pico 2 W) have a clk_gpout
    function; GP13 is CH1, so SYNC moves to GP15. GPIO9 has none.
    - Remove the PIO toggle program and SyncChannel; pio1 is no longer used.
    - pulse_timing.h: syncDiv is the 16.16 clock-generator divider; STATUS
    prints "divider 150+0/65536". GUI parser accepts any I+F/N divider.
    - Timing checks: harness/check_sync.py updated; all six c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
    [PiDG_Pico-B_Cu.gbr, PiDG_Pico-B_Mask.gbr, PiDG_Pico-B_Paste.gbr, PiDG_Pico-B_Silkscreen.gbr, PiDG_Pico-Edge_Cuts.gbr, PiDG_Pico-F_Cu.gbr, PiDG_Pico-F_Mask.gbr, PiDG_Pico-F_Paste.gbr]
2026-10-16 Firmware review fixes: load failures, SYNC independence, hard-coded values
    Bugs
    - restartPulses() checks setOutputs()/configure(). On a failed load nothing
    starts (a failed channel would replay its old timing), the lasers are
    disarmed, ARM is refused, and STATUS shows "HW=ERR outputs stopped" until a
    later setting loads.
    - SYNC no longer depends on pio0: SyncClock::begin() runs before the PIO
    setup, and applyPulseParams() starts SYNC before the pio0 check.
    - SyncClock::start() stops a running generator with ENABLE alone and waits
    3 output cycles before AUXSRC changes, as the SDK does. It does nothing
    while the generator already runs at the requested divider.
    - loop() reads until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
    [firmware_version.py, harness.cpp, main.cpp, pio_pulse.cpp, pio_pulse.h, protocol.cpp, protocol.h]
2026-10-16 Review follow-ups: boot load failure, version define scope, SYNC stop wait
    - setup(): a pulse load that fails during the boot-time apply is no longer
    copied into g_hwWhy (which is never cleared). It stays in g_loadFailWhy, so
    the banner and STATUS say "outputs stopped", and the next clean load clears
    it, as the README describes. Boot-time hardware problems (pio0, SYNC pin)
    still go to g_hwWhy.
    - tools/firmware_version.py is now a post script and adds
    PIDG_FIRMWARE_VERSION to projenv only. As a pre script it reached every
    framework file, so each new version string recompiled the whole
    arduino-pico core (191 objects); now only the 5 project sources rebuild.
    - SyncClock::start():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
    [firmware_version.py, main.cpp, sync_clock.cpp]
2026-10-16 STATUS: remove the SYNC line
    SYNC is no longer a PIO program with a settable rate: the RP2350 clock
    generator divides clk_sys by a fixed 150 for exactly 1 MHz. The STATUS line
    that reported its realized frequency and divider is removed, together with its
    only firmware user, syncFormatHz(). HELP and the README now say that SYNC is
    fixed at 1 MHz, is not a setting, and is not in STATUS.
    The host harness computes the realized SYNC frequency itself, so its column
    layout and check_sync.py (divider and exact 1 MHz) are unchanged.
    The pulse-pair spacing rule (DELAY <= 1/FREQ - 2 x WIDTH) stays as it is.
    Verified: the six host timing checks give unchanged key lines; 1,200 random
    command streams g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
    [harness.cpp, protocol.cpp, pulse_timing.h]
2026-10-16 Clock jumper: optional 300 MHz overclock selected at boot (GP10)
    A pre-init hook (src/clock_mode.cpp, .preinit_array.00700, after the
    SDK clock setup and before initVariant/USB/setup) reads GP10 with the
    internal pull-up. Jumper to GND: raise VREG to 1.30 V, double the QMI
    flash timing fields (same 50 MHz flash clock and sample point; written
    from RAM while the QMI is idle), set clk_sys to 300 MHz and stop the
    unused HSTX clock. Open: the rated 150 MHz, unchanged.
    - No overclock after any watchdog timeout since POR/BOR/RUN (the
    existing WDT_RESETS counter, now in reset_scratch.h), so an unstable
    chip cannot crash in a loop at 300 MHz.
    - The hook uses register writes only: gpio_init() wo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
    [board.h, check_combined.py, check_marker_lock.py, check_pixgate.py, check_sync.py, clock_mode.cpp, clock_mode.h, main.cpp]
2026-10-16 Clock jumper: review fixes (VREG after reset, QMI write, docs)
    - The regulator is in POWMAN and keeps 1.30 V through a watchdog or
    soft reset. Every start that stays at 150 MHz now sets the default
    1.10 V again. STATUS gains VREG_MV (the setting the hook left);
    CLKMODE no longer repeats the voltage.
    - qmiSetM0Timing(): wait out the chip-select cooldown after BUSY
    clears; read back DIRECT_CSR and DSB/ISB before returning to flash.
    - Stop clk_hstx before the clock change, so it never runs at 300 MHz.
    - Docs: the jumper is read at every start, not only at power-up; a hang
    before the watchdog starts (~1.5 s after reset) is not caught;
    R17/R18 positions and a heading level in the KiCa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
    [clock_mode.cpp, clock_mode.h, main.cpp]
2026-10-20 Board: clock jumper J20 with R29 series resistor; Rev 1; schematic tidy
    - J20 (2-pin header, C32713268) left of J14: pin 1 CLK_SEL_JMP -> R29 1k
    (C17513) -> CLK_SEL = GP10 (J14 pad 14), pin 2 GND. Shunt fitted =
    300 MHz, open = 150 MHz. R29 limits the current to about 3.3 mA if GP10
    is driven with the shunt fitted (firmware before 5dfedd5 drove GP10 as
    SYNC); a fitted shunt still reads about 0.1 V. No capacitor on CLK_SEL.
    - PCB: J20 at (152.4, 65.405), R29 inline on F.Cu, silkscreen CLOCK JUMPER /
    OPEN = 150 MHz / FIT = 300 MHz (OVERCLOCK). Zones refilled. DRC: 0
    violations, 0 unconnected; schematic parity: no real net mismatches.
    - Rev 1 (no board built yet): schematic title bl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
    [PiDG_Pico-B_Cu.gbr, PiDG_Pico-B_Mask.gbr, PiDG_Pico-B_Paste.gbr, PiDG_Pico-B_Silkscreen.gbr, PiDG_Pico-Edge_Cuts.gbr, PiDG_Pico-F_Cu.gbr, PiDG_Pico-F_Mask.gbr, PiDG_Pico-F_Paste.gbr]
2026-10-31 Board: J12 becomes External Sync Out; remove J16 and the external pixel-reset input
    - J12 BNC now outputs a copy of the camera trigger (PWM_TRIG_TAP) through a
    third UCC27524 channel (U19), built like Laser 1: R30 68 ohm 2 W, J21 mode
    jumper with R31 47 ohm / R32 82 ohm (50 ohm or Hi-Z), gated by LASER_PWR_OK.
    - J16 (laser-enable / trigger monitor header) removed with its traces;
    PWM_TRIG_TAP shortened from ~122 mm to ~59 mm.
    - External pixel-reset input removed (U12, R5, C8); U3 inputs tied to
    PIXRST_GATE, so pixel reset comes only from the Pico (GP16).
    - Fab outputs, BOM, JLC BOM/CPL (85 parts, 41 lines) and order notes updated;
    firmware/GUI strings no longer mention J12 as an in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
    [PiDG_Pico-B_Cu.gbr, PiDG_Pico-B_Mask.gbr, PiDG_Pico-B_Paste.gbr, PiDG_Pico-B_Silkscreen.gbr, PiDG_Pico-Edge_Cuts.gbr, PiDG_Pico-F_Cu.gbr, PiDG_Pico-F_Mask.gbr, PiDG_Pico-F_Paste.gbr]
2026-10-31 Firmware: limit MARKERWIDTH to 50 % duty to protect J12's R30
    The marker drives J12 (External Sync Out). Held high into a shorted BNC, R30
    (68 ohm 2 W) takes up to 2.16 W. 2 x MARKERWIDTH <= 1/FREQ keeps its average
    at or below 1.08 W (1.45 W with J10 on 1-2 and COMBINE 1, as for the laser
    outputs). No in-stock 3 W 68 ohm 2512 exists at JLC (2026-10-31).
    - pulse_timing.h: new duty check; the error names the binding limit.
    - protocol.cpp: HELP text gives the limit.
    - timing_check: models and boundary tests updated; all checks pass.
    - Hardware.md / README.md: J12 sections, limits, error tables, max FREQ with
    the default 2 us marker (now 250 kHz).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
    [check_combined.py, check_marker_lock.py, check_pixgate.py, check_random.py, protocol.cpp, pulse_timing.h]
2026-10-31 Docs: J12-to-camera offset (measure per board); UCC27524 D-package figures
    - External Sync Out: delay table from GP11 to J12 and to the camera
    triggers (min/typ/max), offset -8.5/+10.7/+32 ns rising; measure it once
    per board (first-board check 4 now gives the procedure). Delay-reduction
    options studied and not used are listed with the reason.
    - U13/U19 delay: 17 typ / 27 max ns (SLUSFA9, D package; older die
    6/13/23 ns), not ~13-25 ns. ROL: 0.6 / 1.1 ohm (D package), not 0.15-1.
2026-10-31 Add tools/signal_sim (ngspice transmission-line sim); docs from its results
    tools/signal_sim: transmission-line simulation of the trigger, laser and
    External Sync Out nets, from the routed board geometry (extract_geometry.py,
    pcbnew + field solve) and datasheet device values (devices.json), run through
    KiCad 10's ngspice.dll. 169 runs, ~95 s. Covers CH1-CH2 skew per J10 setting
    with/without R19, J12 delay and offset to the camera triggers, J7/J8/J12
    levels and Hi-Z overshoot, R30/R31/R32 power, and delay-reduction options.
    Results reproduced by an independent review; hand checks in results.md.
    Hardware.md / README.md:
    - R19: re-simulated on the ~59 mm net; with J10 on 1-2 the skew is
    0.24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
    [extract_geometry.py, signal_sim.py]
2026-11-02 Board: gull-wing U17 (LT3065 MSOP-12) and 6-pin USB-C J17 for hand assembly; J12 offset write-in field
    - U17: LT3065EDD (DFN-10, 0.5 mm, no leads) -> LT3065EMSE#PBF (MSOP-12-EP,
    0.65 mm gull-wing, C670156). New symbol PiDG_Local:LT3065xMSE: same pin
    functions as the DFN, renumbered per the datasheet (BYP 8, GND 9, ADJ 10,
    OUT 11/12, EP 13), NC pins 6/7. Same position; the two GND vias stay under
    the exposed pad. C16/C18/C19/R20 moved 0.2-0.65 mm and R12 turned upright
    to clear the larger courtyard; U17 stubs re-drawn.
    - J17: HRO TYPE-C-31-M-12 (16P) -> TYPE-C-31-M-17 (6P power only, C283540):
    0.7-0.9 mm pads with >= 0.3 mm gaps. KiCad PowerOnly_6P symbol (D+/D-/SBU
    no-connects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
    [PiDG_Pico-B_Cu.gbr, PiDG_Pico-B_Mask.gbr, PiDG_Pico-B_Paste.gbr, PiDG_Pico-B_Silkscreen.gbr, PiDG_Pico-Edge_Cuts.gbr, PiDG_Pico-F_Cu.gbr, PiDG_Pico-F_Mask.gbr, PiDG_Pico-F_Paste.gbr]
2026-11-02 Docs: exposed pads of U14/U17 need hot air (vias are tented)
    Copilot review: the supplied bottom mask covers the exposed-pad GND vias
    (all vias are tented), so solder cannot be fed through them from the back.
    Hardware.md and the U17 BOM note now say hot air or a hot plate. The
    tented-via fab setting is unchanged.
    [PiDG_Pico_BOM.csv]
2026-11-02 Board: remove TP4 (CH2 scope header)
    - Schematic: TP4, its _PULSE_OUT_CH2 label and GND symbol removed.
    - PCB: TP4 footprint, its 21.2 mm B.Cu branch of _PULSE_OUT_CH2 (net now
    74.2 mm) and the CH2 / GND / SCOPE ONLY silkscreen removed. ERC 0; DRC 0
    violations, 0 unconnected; netlist lost only TP4.1/TP4.2.
    - BOM row, JLC BOM (line now J20 only) and CPL row removed; 84 placed parts.
    Gerbers, drills and zip regenerated.
    - tools/signal_sim: TP4 dropped from the model, geometry extracted again,
    run again. CH2 reaches U8 ~0.14 ns earlier; CH1-CH2 skew at U7/U8 (4 mA,
    typ, R19 fitted) J10 2-3: 0.22/0.25 ns (was 0.09/0.10), J10 1-2:
    0.38/0.42 ns (was 0.24/0.27); still below U13's 1 ns c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
    [PiDG_Pico-B_Cu.gbr, PiDG_Pico-B_Mask.gbr, PiDG_Pico-B_Paste.gbr, PiDG_Pico-B_Silkscreen.gbr, PiDG_Pico-Edge_Cuts.gbr, PiDG_Pico-F_Cu.gbr, PiDG_Pico-F_Mask.gbr, PiDG_Pico-F_Paste.gbr]
2026-11-02 Board: silkscreen readability pass
    Every silk text checked by its stroke outline (height >= 1.0 mm, stroke,
    mirroring, angle, overlap with text, part bodies, vias, pads, board edge);
    0 findings after the fixes, DRC 0.
    - CONTROL / PROGRAM / PICO MICRO-USB moved from under the Pico (between
    the sockets) to the right of its USB end.
    - J7/J8/J12 references moved off the BNC bodies to the strip left of them.
    - References clear of vias/pads: R10, R12, C14, C15, C20, R2.
    - Labels that read as a neighbour's or crowded: C17 beside its own part,
    U13 off R16's reference, R30 off the EXT SYNC OUT line, C9/C21 closer.
    - Only the F.Silkscreen gerber changed; zip regenerated.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
    [PiDG_Pico-B_Cu.gbr, PiDG_Pico-B_Mask.gbr, PiDG_Pico-B_Paste.gbr, PiDG_Pico-B_Silkscreen.gbr, PiDG_Pico-Edge_Cuts.gbr, PiDG_Pico-F_Cu.gbr, PiDG_Pico-F_Mask.gbr, PiDG_Pico-F_Paste.gbr]
2026-11-03 Moved screen printing labels
    [PiDG_Pico.kicad_pcb]
2026-11-04 Docs: rename the project PiDG -> PiEBV
    Prose references in the Markdown docs only. Unchanged, because they name
    real files, code or device output: PiDG_Pico.* KiCad files, the PiDG_Local
    libraries, tools/pidg_* paths, PIDG_HARNESS, pidg.local, the Python class
    PiDG, and the firmware's "PiDG delay generator" ID? reply (the GUI matches it).
2026-11-04 Eurocard save state
    [PiDG_Pico-B_Cu.gbr, PiDG_Pico-B_Mask.gbr, PiDG_Pico-B_Paste.gbr, PiDG_Pico-B_Silkscreen.gbr, PiDG_Pico-Edge_Cuts.gbr, PiDG_Pico-F_Cu.gbr, PiDG_Pico-F_Mask.gbr, PiDG_Pico-F_Paste.gbr]
2026-11-05 EuroCard: power input to the left edge, MH rectangle, matched pulse outputs
    - J17 (USB-C PD) with U14 (turned to face J17), the buck U15/L1/C12-C15 and
    U16 move to the bottom of the left edge; the right edge carries only the
    three BNCs. The output block moves 5 mm down so an M3 washer at MH2 clears
    J7: MH1-MH4 are again a corner rectangle, 152 x 92 mm.
    - Hot-plate size is no longer a placement constraint: the 100 mm SMD-area
    marks are removed; SMD pads span 132 mm.
    - Laser pulse lanes are drawn per placement (L path plus a 45-degree bump
    on the shorter lane): GPIO pin to U13 input 66.16 mm on both channels.
    - Camera lines length-matched per group: Sync 100.1-101.2 mm, Trigger
    110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
    [PiDG_Pico-B_Cu.gbr, PiDG_Pico-B_Mask.gbr, PiDG_Pico-B_Paste.gbr, PiDG_Pico-B_Silkscreen.gbr, PiDG_Pico-Edge_Cuts.gbr, PiDG_Pico-F_Cu.gbr, PiDG_Pico-F_Mask.gbr, PiDG_Pico-F_Paste.gbr]
2026-11-05 EuroCard: re-run signal_sim, KiCad-measured camera lengths, JLC CPL check
    - tools/signal_sim on the EuroCard routing. CH1-CH2 skew at U7/U8 with
    J10 on 2-3 is now 0.023 / 0.031 ns typical (0.22 / 0.25 ns on the 126 mm
    layout); camera triggers arrive within 0.03-0.05 ns of each other (was
    up to 0.3 ns); J12 minus camera trigger -8.8 / +10.4 / +26.0 ns rising.
    Hardware.md and README tables updated.
    - extract_geometry.py joins pads that a track overlaps without ending in
    them (once per copper piece); signal_sim.py puts 1 mOhm in series with
    each lumped L (meander loops made the matrix singular). On the 126 mm
    geometry no result changes by more than 0.001 ns.
    - Camera line lengths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
2026-11-05 EuroCard: carry hand-routed buck and decoupling copper, C11 beside U14 pin 1, rebuilt board and fab outputs
    [PiDG_Pico-B_Cu.gbr, PiDG_Pico-B_Mask.gbr, PiDG_Pico-B_Paste.gbr, PiDG_Pico-B_Silkscreen.gbr, PiDG_Pico-Edge_Cuts.gbr, PiDG_Pico-F_Cu.gbr, PiDG_Pico-F_Mask.gbr, PiDG_Pico-F_Paste.gbr]
2026-11-05 EuroCard: design review report, doc corrections
    tools/eurocard/REVIEW.md: 30 findings from a multi-agent review of the
    995759e board (29 confirmed by re-measurement, fixes checked in scratch
    rebuilds); no board change yet.
    Hardware.md: 45 plane taps (not 47), 0.3 mm CC lines (not 0.2 mm), notes
    for the open items (buck GND via, touching camera meander arms, signal_sim
    tables from 8db06a6), plus the 995759e length/via figures.
    tools/eurocard/README.md: LOCAL_PATHS row.
2026-11-05 EuroCard review: F31, autorouted jogs and bump-outs; Manhattan-diagonal style preferred
    Owner review note with measured jog density (camera lines 10.2 segments
    per 10 mm, other nets 4.0; hand board 2.4 / 2.8) and the planned fix.
2026-11-05 signal_sim: fix hand check 4 hang (F5), branch-point vias, option d cut from geometry; re-run on 995759e
    - Hand check 4: Dijkstra path from the root over undirected branches. The parent-map walk cycled
    forever on the PWM_TRIG_TAP self-loop branches U19.2->U19.2 and J10.2->J10.2. The check label
    now gives the via count on the path (4 on the EuroCard).
    - branch_vias(): a via that is also a branch point (VIA2 on PWM_TRIG_TAP) is one C-L-C section in
    series with each branch that leaves it on the other layer. README model paragraph updated.
    - Option d: the cut branch is the one that ends at U19.2, taken from the geometry, with an assert.
    The old fixed pair R9.1-U19.2 does not exist on the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
    [signal_sim.py]
2026-11-05 EuroCard review: placement and carry fixes (F1 F6 F7 F8 F10-F13 F15 F16 F20)
    - F1: C12 in CARRY_GND (2 hand GND vias); taps.py skips kept copper only if it reaches a via <= 5 mm.
    - F6: carried J17 A9-B9 VBUS join, locked VBUS_PD lane to U15.3, F.Cu keep-out under the J17 body;
    tjoin.py (T-join split) and dangling.py (DRC-listed stubs, connectivity-checked) after stitching.
    - F7: U9/C7/C6 above the buffer row, silk entries.
    - F8: R18 at (194.0, 66.5); R17/R19 branch, R18 balance stub and R19->J10.1 drawn and locked.
    - F10: Pico pin-1 mark above J14.1. F13: TP3 at (141.0, 67.0), labels moved.
    - F11: SAME_PAD 0.25 and own-pad shape check. F12: MH at y 36/124; gaps.py checks MH washers, run in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
    [dangling.py, gaps.py]
2026-11-06 EuroCard review: camera-first routing pass (F2 F3) + higher turn-cost (F31a)
2026-11-06 EuroCard review: post-route steps applied (F18 F26 F27 F28 F31) + rebuilt board and fab outputs
    [PiDG_Pico-B_Cu.gbr, PiDG_Pico-B_Mask.gbr, PiDG_Pico-B_Paste.gbr, PiDG_Pico-B_Silkscreen.gbr, PiDG_Pico-Edge_Cuts.gbr, PiDG_Pico-F_Cu.gbr, PiDG_Pico-F_Mask.gbr, PiDG_Pico-F_Paste.gbr]
2026-11-06 EuroCard review close-out: rebuild fab zip (F4), re-run signal_sim on final routing (F5), refresh Hardware.md routing numbers (F14)
    - fab/PiDG_Pico_Gerbers.zip: 14 files from current fab/gerbers (no drill-map PDFs)
    - signal_sim: 169 runs on final routing; R19/J12/camera skew tables in results.md
    - Hardware.md: camera lengths 81.9-83.0 / 42.5-43.6 / 51.6-53.1 mm, laser lanes
    66.16 mm both, lane separations (2.24 / 22.3 / 2.3 mm), PWM_1MHz 83.7 mm,
    totals 1461 segs / 2510 mm / 194 vias, via census (GND 134 / +5V 12 / other 48),
    fence 46 + stitch 37, sim timing tables updated
    - FIX_PLAN.md: phase plan for the 29 confirmed REVIEW.md findings
2026-11-06 EuroCard M8: drc_gate.py exits 1 on violations or unconnected items
    drc_gate.py only printed the counts, so build.sh finished with exit 0 on a
    board with DRC errors. It now exits 1 when a non-warning violation or an
    unconnected item remains, and lists each such violation. Warning-severity
    items (the U14 lib_footprint_mismatch, F21) are still printed and do not
    fail the build.
    build.sh: the two DRC runs that only make drc.json for dangling.py are not
    gates (|| true); the post-repair DRC and the final DRC gate the build.
    Tested: clean board -> exit 0; throwaway copy with a GND track across
    _PULSE_OUT_CH1 -> "Items shorting two nets", exit 1.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
    [drc_gate.py]
2026-11-06 EuroCard m1: tjoin.py no longer adds a duplicate of an existing segment
    The T-join split added the piece p -> e without checking whether that
    segment existed already. Where a short stub lay on the end of a longer
    collinear track, the split made an exact copy of the stub: 35 duplicate GND
    tap segments (19.25 mm) on the board at 801ae47. The split now adds p -> e
    only if no same-net, same-layer, same-width segment with ends within
    0.01 mm (either direction) exists; the track is still shortened to s -> p.
    The summary line also counts the splits that found the piece present.
2026-11-06 EuroCard M2/F23: finish.py draws the board and Pico module outlines on F.Fab
    REVIEW.md F23 asks for the module outline on F.Fab; the board had no F.Fab
    or B.Fab drawing. finish.py now adds, once (skipped when F.Fab drawings
    exist):
    - the 160 x 100 mm EuroCard rectangle (130,30)-(290,130), from the
    Edge.Cuts line centres;
    - the Pico 2 W module (U11 has no footprint), 51 x 21 mm, and its micro-USB
    receptacle (8.0 mm wide, face 1.30 mm past the module end), placed from
    the J15 / J14 pin 1 positions, with the label "Pico 2 W (U11)".
    On this board the receptacle face is at x 129.715, 0.285 mm past the left
    edge. F.Fab (layer 35) is not plotted into the gerbers.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
2026-11-06 EuroCard: netgap.py, exact copper gap between two net sets (audit M3/M4/M5)
    The separation values in Hardware.md came from a measuring script with
    errors, and the audit's distsets2.py fixed only one of them:
    - for parallel segments it compared one end point only (u = 0), so it missed
    parallel runs (lane CH2 vs CLK_SEL: 0.538 mm, it gave 0.646 to a GND via);
    - its pad loop called FOOTPRINT.GetNetname(), which raises AttributeError;
    the except branch set the net to '', so no pad was ever measured;
    - the zero-length branch passed (x1, x2, y1, y2) as the segment.
    netgap.py measures tracks (segment and width), vias (circle per layer) and
    pads (KiCad effective polygon per layer, so rect / roun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
    [netgap.py]
2026-11-06 signal_sim n12: extract_geometry.py output no longer depends on board item order
    The tree walk and the BFS keep the first edge they meet. On nets with loops
    (SYNC_N, TRIG_N) the branch labels, edges and pad path lengths followed the
    order of the items in the board file, which changes when a tool saves the
    board again: the committed geometry.json and a re-extract of the board at
    801ae47 differ in the SYNC_N tree (U2.1 18.9937 / 18.6109 mm, U2.13
    14.5552 / 14.1724 mm). Pads are now sorted by name and tracks / vias by
    geometry before the graph is built.
    Test: the board and a copy with its 1655 segment / via blocks in reverse
    file order give byte-identical geometry.json with this script (before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
    [extract_geometry.py]
2026-11-06 EuroCard n7/n5: post() keeps stderr; tidy.py gets --before st_in
    n7: post() sent the stderr of each post-route script to /dev/null, so a
    failing script stopped the build with no traceback. stderr now goes to
    work/post.log; on a failure post() prints the end of that log and stops.
    post NAME:LOG lets one script write a second log (used by the next commit).
    n5: tidy.py ran without --before, so a "bridge" was any copper-invisible
    off-grid segment. With --before st_in.kicad_pcb (F28 scope) a bridge is a
    copper-invisible segment that the stitch step or a later step added. On the
    rebuilt board tidy removes 7 segments (3 before): the 4 new ones are
    copper-invisible pieces added after st_in (+12V 0.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
2026-11-06 EuroCard U1: camclean.py removes the camera-line staircases and acute corners
    User report: wiggly, unnatural ducking of camera traces near J1-J6. New
    post-route step after ends.py (camera nets only, length kept, --dry and
    --protect like the other post-route scripts):
    - meander caps of two stubs (KRT's chamfered cap; on a 45-degree base an
    orthogonal "L") become one straight cap; both arms grow by the same
    amount, so the comb keeps its 0.75 mm pitch and 0.45 mm arm gap;
    - each staircase (3+ consecutive segments < 1 mm) and each acute corner
    (turn > 90 degrees) becomes 0-2 octilinear segments; window ends may
    slide along the adjoining segments, a pad end may go to the pad centre
    (end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
2026-11-06 EuroCard: rebuilt board, gerbers and signal_sim after the audit fixes
    PiDG_Pico.kicad_pcb is build.sh's work/final board at this commit's
    tools. Two rebuilds gave identical copper (sha256 of the sorted
    net/layer/start/end/width tuples bcfae201ad1f65b2): 1061 segments,
    2490.8 mm (F.Cu 1476.1, B.Cu 1014.7), 194 vias, 0 duplicate segments
    (was 1461 / 2510.5 mm / 194 / 35). Changes against 801ae47: camera lines
    (camclean.py, U1), 35 duplicate GND stubs gone (tjoin.py, m1), 4
    copper-invisible pieces removed (tidy.py --before, n5), F.Fab outlines
    (finish.py, F23). In1 / In2 gerbers: same content, other draw order.
    Gates: DRC 0 violations / 0 unconnected (1 warning: U14
    lib_footprint_mismatch, F21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
    [PiDG_Pico-B_Cu.gbr, PiDG_Pico-B_Mask.gbr, PiDG_Pico-B_Paste.gbr, PiDG_Pico-B_Silkscreen.gbr, PiDG_Pico-Edge_Cuts.gbr, PiDG_Pico-F_Cu.gbr, PiDG_Pico-F_Mask.gbr, PiDG_Pico-F_Paste.gbr]
2026-11-06 EuroCard docs M1/F23/m4: mounting holes, enclosure data, TP3 position
    M1: MH1-MH4 are 4 mm in from the 100 mm edges and 6 mm in from the 160 mm
    edges, centres 152 x 88 mm (measured: (134,36) (286,36) (134,124)
    (286,124), 3.2 mm drill); the docs said 4 mm from both edges, 152 x 92 mm.
    Added: fit no hardware at the holes in card guides or 1455N slots.
    F23 (docs part; finish.py draws the F.Fab outlines): the Pico micro-USB
    face is 0.285 mm past the left edge (x 129.715, centre 20.50 mm below the
    top edge). Hammond 1455N1601 data, marked as drawing values to confirm
    (11 slots, 2.0 mm at 3.5 mm pitch, 100.00 +/-0.51 x 160.00 +/-0.50 mm,
    41.8 / 38.3 mm headroom, 6.4 mm corner rails, 97.1 x 48.7 m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
2026-11-06 EuroCard docs M3/M4/M5/n13/m8/m10: measured gaps and camera-line text
    All gaps measured with tools/eurocard/netgap.py (edge to edge, one layer,
    zone fills not counted) on the rebuilt board, and checked against KiCad's
    DRC engine with one clearance rule per net pair. The old values came from
    a script that missed parallel runs and never measured pads.
    M4 lanes: at least 0.45 mm to other nets (was "2.3 mm"): 0.45 to the
    CH1_J10 via (CH1's own pulse behind R19), 0.54 to CLK_SEL (parallel run),
    0.60 to the U7.3 GND track, 0.63 to LASER_EN at U8.1, 0.95 to a
    PIXRST_GATE via, >= 1.9 mm to all other nets; pad gaps at U7/U8/J14
    listed. Lanes to PWM_1MHz / SYNC_N: 21.70 mm (was "22.3"; the nearest la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
2026-11-06 EuroCard docs m1/n3/F9/m6/m7/n4/n10: totals, reference planes, residuals
    m1 totals (re-measured on the rebuilt board): 1061 segments, 2491 mm
    (F.Cu 1476, B.Cu 1015), 194 vias, no identical segments (was 1461 /
    2510 mm with 35 duplicate GND stubs). n3: +5V surface copper 14.67 mm in
    12 segments (was "12.4 mm").
    F9 decision recorded: no extra GND return vias. B.Cu lengths (Sync 413.9,
    Trigger 15.9, TDRSTN 249.8, PWM_1MHz 79.6, PWM_TRIG_TAP 70.2, PIXRST_GATE
    39.2 mm) return in the +5V plane, coupled to GND by the B.Cu pour (about
    18.9 pF/cm2) and the In1-In2 core (about 3.7 pF/cm2). The review option
    (route_planes.py --add-gnd-vias --gnd-via-distance 1.5) adds 50 GND vias
    on this routing (test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
2026-11-06 EuroCard docs m5: precise DRC state and the U14 footprint warning
    Hardware.md said "DRC 0 violations". The documented command prints
    "Found 1 violations" / "Found 0 unconnected items": the one violation is
    the warning-severity lib_footprint_mismatch on U14 (its F21 paste "H");
    there are no errors, and drc_gate.py counts non-warning violations and
    unconnected items only (and now fails the build on any). Added: do not run
    "Update Footprint from Library" on U14, because it restores the library
    paste window over both via holes (100 % of each), which F21 removes.
    ERC re-run on this commit's schematic: 0 violations.
2026-11-06 EuroCard m9/F9: record the F9 decision (no extra GND return vias)
    REVIEW.md F9 left the return-via option as "decide before use" and no
    decision was recorded. Decision: keep the verified copper, no extra GND
    return vias. The option (route_planes.py --add-gnd-vias
    --gnd-via-distance 1.5 in the stitching step) adds 50 GND vias beside the
    signal vias on the current routing, with no track change (tested on the
    build's st_in in a scratch folder); the fix check rated the finding low
    severity for these 1.8 V LVC lines, and the B.Cu GND pour couples the
    +5V plane to GND (about 18.9 pF/cm2). Hardware.md (Routing, "Reference
    planes", previous commit) gives the B.Cu lengths, the return path and the
    opt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
2026-11-06 EuroCard docs n8/n9/n11: stale review text, session paths, zip line ends
    n8: REVIEW.md no longer says "No fix is applied yet" (it now says the
    tables describe 995759e and points to FIX_PLAN.md for the fixes and audit
    fixes); FIX_PLAN.md gate 4 gives the post-fix camera lengths (was the
    pre-fix ~107.6 / 55.5 / 52.8 mm); TEST_REPORT.md says the work-test/
    helpers were uncommitted scratch files and names the committed tools for
    the same checks.
    n9: FIX_PLAN.md environment uses placeholders for the KRT clone / venv and
    the worktrees instead of session-specific absolute Temp paths.
    n11: JLC_ORDER.md notes that the zip holds the 14 files with the CRLF line
    ends KiCad writes on Windows, so on an LF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
2026-11-06 EuroCard docs: PWM GND via layer is In2.Cu, not B.Cu
    Independent verification of the 0.232 mm gap placed the pair on In2.Cu:
    PWM_1MHz In2 track (182.7,74.0)-(198.6,89.9) vs the GND via ring at
    (194.844,87.251) (via is F.Cu+In2.Cu, no B.Cu copper). Value unchanged.
2026-11-06 EuroCard R1: via obstacle guard (viaguard.py) after the KRT steps
    KRT's warning "3 via block(s) could not be read" is the text "(via J18 2-3)",
    "(via J19 2-3)", "(via J21 2-3)" in three footprint Description properties:
    KRT's _via_blocks regex also matches inside quoted strings. They are not vias;
    every real via is modelled (placed 19, tapped 64, cam_l 79, routed 107, st_in 111,
    st_out 178 = pcbnew counts). viaguard.py compares the string-aware count of
    top-level via blocks with len(parse_kicad_pcb().vias) and stops the build on a
    mismatch (negative test: a via without (size) -> 64 vs 63, exit 1).
2026-11-06 EuroCard R2: gaps.py deterministic (25 lines on every run)
    The 23/24/25-line flap was not a threshold effect: the pair prefilter
    a.GetBoundingBox().Inflate(d).Intersects(...) used the BOX2I reference that
    Inflate returns from a temporary SWIG object after Python had freed it, so the
    prefilter dropped C17-U17 (0.56) and/or C17-R12 (0.66) at random on one file.
    Now: courtyard boxes copied to ints once, no prefilter, integer-nm compare
    (gap_nm < LIMIT_nm), pairs named in sorted order, all output sorted. 15 runs on
    3 boards: one output (25 lines). Nearest line to the 1.0 mm limit: 0.95.
2026-11-06 EuroCard R3: merge the +12V 0.051 mm sliver at (239.808, 76.85)
    The sliver is router copper (end step of the 0.5 mm +12V run from (239.8, 74.8)
    onto the carried U17.11-U17.12 0.4 mm tie), not a load-bearing piece of carried
    copper: without it KiCad still reports 0 unconnected, 1 pad group, 0 dangling
    ends. tidy.py never selected it: 0.00585 mm2 of it is not covered by other
    copper (limit 0.001 mm2), so it is not copper-invisible.
    tidy.py sliver merge: both neighbour tracks end at the crossing of their centre
    lines, (239.8, 76.85); the tie piece loses 0.008 mm under the run's end cap.
    Copper: 1061 -> 1060 segments, 194 vias, sha bcfae201ad1f65b2 -> 682459b0ba3e28f9.
    Gates: DRC 0/0 (U14 warnin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
    [PiDG_Pico-B_Cu.gbr, PiDG_Pico-B_Mask.gbr, PiDG_Pico-B_Paste.gbr, PiDG_Pico-B_Silkscreen.gbr, PiDG_Pico-Edge_Cuts.gbr, PiDG_Pico-F_Cu.gbr, PiDG_Pico-F_Mask.gbr, PiDG_Pico-F_Paste.gbr]
2026-11-06 EuroCard R4: document the F.Cu GND neck piece without a stitch via
    frag_stitch "no site: F.Cu neck 5.6 192.71 93.59": (192.71, 93.59) is the corner
    of the eroded core; the piece is (192.2, 93.1)-(194.8, 96.7), 5.6 mm2, joined to
    the main F.Cu GND fill (12954 mm2 outline) by a 0.72 mm neck. All 41 candidate
    sites fail only on the B.Cu Sync1 meander (0.45 mm arm gap; a 0.6 mm via needs
    1.0 mm). No copper change; reason in Hardware.md Known residuals.
2026-11-06 EuroCard R7: name the rule situation for the two Rev 1 GND vias
    U13.3 (236.0, 60.935) and U19.3 (241.9, 98.435): ring 0.200 mm, hole edge
    0.350 mm from the own GND pad. Netclass clearance 0.20 and min_hole_clearance
    0.20 are checked only between different nets; KiCad 10 checks no via-to-own-pad
    clearance (copy test: U13.3 via moved to hole-pad 0.10 and 0.00 mm, DRC
    --refill-zones still only the U14 warning). The 0.25 mm SAME_PAD is taps.py's
    rule. Both vias are tented (board setup front/back, no override). Vias unchanged.
2026-11-06 EuroCard R5: joint re-shape of the Trigger1/Trigger2 (U6) and Sync6 (J6.5) staircases
    camjoint.py, after the first camclean pass (before kilen1, so camclean --trim
    restores Trigger2 with its caps: 5 x +0.025 mm). Windows: Trigger2 20 -> 2 segs
    (vertical x 221.6, 45 to U6.4); Trigger1 18 -> 6 segs (vertical x 220.85, 45 jog,
    vertical x 221.46, 45 to U6.2; window +0.002 mm); Sync6 12 -> 4 segs (V, 45, H,
    45; length kept). U6 pair applied only together. Guards: camclean's gap rules,
    no window closer to a neighbour than before (up to 0.30), octilinear, no turn
    > 90, no segment < 0.3, own gap 0.45 beyond 2 mm, no-meander length <= 0.15.
    Local gaps: Trigger1-Trigger2 0.371 -> 0.435, Trigger2-GND v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
    [PiDG_Pico-B_Cu.gbr, PiDG_Pico-B_Mask.gbr, PiDG_Pico-B_Paste.gbr, PiDG_Pico-B_Silkscreen.gbr, PiDG_Pico-Edge_Cuts.gbr, PiDG_Pico-F_Cu.gbr, PiDG_Pico-F_Mask.gbr, PiDG_Pico-F_Paste.gbr]
2026-11-06 EuroCard S1: PIXRST_GATE B.Cu jog at R9/J10 re-shaped (simplify.py)
    PIXRST_GATE on B.Cu between its vias (205, 52.4) and (218.3, 86.1): 45, vertical x 208.2,
    45 jog, vertical x 210, 45 (5 segs) -> 45, vertical x 209.1, 45 (3 segs). Same 45-degree
    lines at both vias, so the length is unchanged (39.209 mm B.Cu; KiCad net length 87.0799 mm
    before and after); no via change. New step tools/eurocard/simplify.py after the last camera
    step (kilen2), before the final DRC: camera copper, stitch vias and taps unchanged.
    Region gaps (B.Cu, edge to edge): PIXRST_GATE region minimum 0.230 -> 0.650 mm
    (+5V tap via (210.68, 67.05) 0.230 -> 1.130); LASER_EN_TAP via 1.550 -> 0.650;
    PWM_TRIG_TAP 0.894 -> 0.65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
    [PiDG_Pico-B_Cu.gbr, PiDG_Pico-B_Mask.gbr, PiDG_Pico-B_Paste.gbr, PiDG_Pico-B_Silkscreen.gbr, PiDG_Pico-Edge_Cuts.gbr, PiDG_Pico-F_Cu.gbr, PiDG_Pico-F_Mask.gbr, PiDG_Pico-F_Paste.gbr]
2026-11-06 EuroCard S1: SIMPLIFY_REPORT.md (R9/J10 routing re-evaluation, driver width check)
    Task A: PIXRST_GATE jog removed (c2bb8c1); PWM_TRIG_TAP, CH1_J10, PWM_Trig and the GND
    taps kept, with the obstacle for each segment. R9 = 10k, R9.1 PWM_TRIG_TAP / R9.2 GND.
    Task B: all eight driver nets 0.30 mm F.Cu; IPC-2221 999 mA at 10 C against 102.7 mA spec,
    179.0 mA short, 440 mA U17 ceiling (9.73x / 5.58x / 2.27x). No width change.
    Gates: builds 1 and 2 = 2b251adc9d235000, DRC 0/0, viaguard, gaps.py 25, camera lengths same.
2026-11-06 EuroCard T6: Trigger6 tail at J6 straightened (camjoint.py window)
    The manual review edit of 2026-11-06 is baked into the pipeline as a
    camjoint.py window ("J6 tail"): the 7-segment router jog of Trigger6
    (F.Cu) at (241.6, 102.5) into J6 becomes one horizontal run to x 247.9
    and one 45-degree leg to (254.98, 109.58). The line is 1.657 mm shorter
    (41.12 mm by KiCad pad-edge read, was 42.78); the per-window ltol
    (J6T_LTOL = 1.70) is the mechanism that allows a length change on a
    line without a meander.
    Window gaps (edge to edge, F.Cu): +12V 1.652 -> 2.450 mm and U19.OUTB
    1.603 -> 2.345 mm (both widen), GND 1.002 mm, Sync6 2.308 mm, Trigger5
    1.301 mm (unchanged). All camjoint guards pass; DRC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
    [PiDG_Pico.kicad_pcb]
2026-11-06 EuroCard tools: fix 5 Copilot review issues (PR #11)
    tjoin.py: exists() excluded the track being split (self-match within the
    0.01 mm tolerance shortened the track to a stub and deleted the remaining
    piece); junction scan now uses a worklist so pieces appended during the
    pass are visited and every T-junction on a trunk is split, not only the
    first. Verified on synthetic boards: old code deleted a 0.995 mm piece and
    left a second junction unsplit; new code preserves all copper and splits
    both junctions.
    gapcheck.py: removed the fixed 1 mm bounding-box cutoff, which discarded
    every candidate pair when the true minimum is larger (the pulse-lane vs
    PWM_1MHz/SYNC_N pair at 21.70 mm reported 'no s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
    [gapcheck.py]
2026-11-06 EuroCard review fixes: re-export fab package after T6, re-run signal_sim, correct fingerprint
    F-1: fab/gerbers and the zip held the c2bb8c1 copper while the board is 2e1baaf.
    Re-exported with kicad-cli --board-plot-params plus excellon separate-TH drill
    (validation: the c2bb8c1 board re-exported equals the committed fab files
    except ProjectId and timestamp lines). F.Cu/B.Cu changed (Trigger6 tail, pour
    re-fill); inner-layer pour segment order changes, geometry identical.
    Zip: 14 files, sha256 9cc3ef0b328f1b3ad587a783bc3b5d4feb345d1e0d5631f9155cf8d3d592ce3f.
    F-4: re-extracted geometry.json from 2e1baaf and re-ran signal_sim (169 runs,
    94 s); typ/typ rise spread 0.055 -> 0.044 ns, every Hardwa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
    [PiDG_Pico-B_Cu.gbr, PiDG_Pico-B_Mask.gbr, PiDG_Pico-B_Paste.gbr, PiDG_Pico-B_Silkscreen.gbr, PiDG_Pico-Edge_Cuts.gbr, PiDG_Pico-F_Cu.gbr, PiDG_Pico-F_Mask.gbr, PiDG_Pico-F_Paste.gbr]
2026-11-06 Rename PiDG to PiEBV across the project
    File/directory renames (git mv, history preserved):
    - PiDG_Pico.{kicad_pcb,kicad_sch,kicad_pro} -> PiEBV_Pico.*
    - libs/PiDG_Local.{pretty,kicad_sym} -> libs/PiEBV_Local.*
    - fab/PiDG_Pico_BOM.csv, PiDG_Pico_Gerbers.zip -> PiEBV_Pico_*
    - fab/gerbers/PiDG_Pico-*.{gbr,drl,pdf} -> PiEBV_Pico-*
    - fab/jlc/PiDG_Pico_JLC_{BOM,CPL}.csv -> PiEBV_Pico_JLC_*
    - tools/pidg_example.py -> piebv_example.py
    - tools/pidg_gui/{pidg_device,pidg_gui}.py -> tools/piebv_gui/{piebv_device,piebv_gui}.py
    - tools/pidg_sim/pidg_sim.cpp -> tools/piebv_sim/piebv_sim.cpp
    Content renames (PiDG->PiEBV, pidg->piebv):
    - KiCad: project name, sheet project fields, footprint lib-ids
    (PiDG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
    [PiDG_Pico-B_Cu.gbr, PiDG_Pico-B_Mask.gbr, PiDG_Pico-B_Paste.gbr, PiDG_Pico-B_Silkscreen.gbr, PiDG_Pico-Edge_Cuts.gbr, PiDG_Pico-F_Cu.gbr, PiDG_Pico-F_Mask.gbr, PiDG_Pico-F_Paste.gbr]
2026-11-06 Rename PiDG to PiEBV across the project (#12)
    - KiCad: project name, sheet project fields, footprint lib-ids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
    [PiDG_Pico-B_Cu.gbr, PiDG_Pico-B_Mask.gbr, PiDG_Pico-B_Paste.gbr, PiDG_Pico-B_Silkscreen.gbr, PiDG_Pico-Edge_Cuts.gbr, PiDG_Pico-F_Cu.gbr, PiDG_Pico-F_Mask.gbr, PiDG_Pico-F_Paste.gbr]
2026-11-07 Routing simplification: C6 nudge, edge-fence-only stitching
    - place.py: C6 (1.8V LDO cap) moved 2.2 mm down to (214.5, 76.5):
    eliminates the VBUS_PD 9-jog staircase and the Net-(U17-ADJ) jog.
    - build.sh: drops the interior stitch lattice (--stitch-vias); keeps the
    edge fence at 10 mm pitch; HERE/ROOT derived with pwd -W so git -C
    works under MSYS bash.
    - Board: jogs 15 -> 5 (remaining are standard 45-degree corners and
    sub-0.3 mm steps, verified visually); DRC 0 violations; camera line
    lengths unchanged; courtyard gaps 24 lines, MH 0.
    [PiEBV_Pico.kicad_pcb]
2026-11-07 EuroCard: FABLE_REVIEW.md, independent design review of 418488f
    Fab package (gerbers, zip) is the c2bb8c1 copper, one commit behind the
    board; signal_sim inputs stale on four nets (results unchanged at the
    printed precision); committed board reproduces exactly (fingerprint
    98a60c3b4332d6e9, not the c27822f7b03012e7 quoted in 2e1baaf).
2026-11-12 Rev 2 schematic: selectable camera I/O voltage (+VCAM), status LEDs, rail test pads
    U20 (TPS2116 power mux) makes +VCAM for U1-U6 from +1V8 (J22 open, default)
    or +3V3 (J22 fitted, Prophesee EVK4). D1 shows 3.3 V on +VCAM.
    D2 = 12 V good, D3 = ARMED (LASER_EN and GP17 and LASER_PWR_OK),
    D4-D6 = output activity (74LVC1G123 pulse stretchers on the driver outputs).
    TP4-TP9 = rail test pads. tools/rev2/sch_edit.py makes the edit from Rev 1.
    Claude-Session: https://claude.ai/code/session_01MUdoUmHJvUBjKH4ZxD5t1p
    [PiEBV_Pico.kicad_sch]
2026-11-12 Rev 2 board: +VCAM power mux, status LEDs, rail test pads, In2 power islands
    tools/rev2/pcb_edit.py makes the board from the Rev 1 board and the Rev 2 netlist.
    U9/C6/C7 move to the top-centre supply block with U20, J22, C23, C24, D1.
    D2/D3 (12 V good, ARMED), D4-D6 (output activity, U21-U23) and TP4-TP9 are new.
    In2.Cu: +5V, +3V3, +1V8, +VCAM and +12V islands in a GND fill (was one +5V plane).
    All B.Cu camera lines stay over one island (+VCAM); tools/rev2/plane_check.py lists
    the reference island of every B.Cu track. DRC: 0 errors, 0 unconnected items.
    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
    [PiEBV_Pico.kicad_pcb, PiEBV_Pico.kicad_sch]
2026-11-12 Rev 2 board: save without project settings; DRC re-run with the project rules (0 errors)
    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
    [PiEBV_Pico.kicad_pcb]
2026-11-12 Rev 2: fab package, BOMs, CPL, ARMED LED firmware pin (GP17)
    fab/: gerbers, drill files and zip re-exported from the Rev 2 board (tools/rev2/fab.sh).
    BOM and JLC BOM: U20-U23, Q1, Q2, D1-D6, J22, C23-C30, R33-R50 (123 placed parts).
    CPL: tools/rev2/cpl.py carries each Rev 1 part's JLC correction; the stale C6 row
    of the Rev 1 CPL (2.2 mm off) is corrected. New polarised parts keep the KiCad
    rotation (JLC footprints not checked).
    Firmware: kPinArmedLed = GP17, HIGH while ARMED (status only).
    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
    [PiEBV_Pico-B_Cu.gbr, PiEBV_Pico-B_Mask.gbr, PiEBV_Pico-B_Paste.gbr, PiEBV_Pico-B_Silkscreen.gbr, PiEBV_Pico-Edge_Cuts.gbr, PiEBV_Pico-F_Cu.gbr, PiEBV_Pico-F_Mask.gbr, PiEBV_Pico-F_Paste.gbr]
2026-11-12 Rev 2: staircase and squiggle clean-up (lengths kept), one build script, fab re-export
    tools/rev2/jogs.py merges router staircases (same vectors in another order: length
    unchanged). tools/rev2/tidy.py replaces five squiggle runs. KiCad length reading:
    Sync1-6 unchanged (spread 1.18 mm), Trigger spread 2.47 -> 2.20 mm (Trigger4 bump
    removed), TDRSTN spread unchanged (1.37 mm). tools/rev2/build.sh runs the whole flow
    with the DRC, length, meander and reference-plane checks.
    signal_sim: loads libngspice on Linux (Rev 1 results reproduced exactly).
    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
    [PiEBV_Pico-B_Cu.gbr, PiEBV_Pico-B_Mask.gbr, PiEBV_Pico-B_Paste.gbr, PiEBV_Pico-B_Silkscreen.gbr, PiEBV_Pico-Edge_Cuts.gbr, PiEBV_Pico-F_Cu.gbr, PiEBV_Pico-F_Mask.gbr, PiEBV_Pico-F_Paste.gbr]
2026-11-12 Rev 2: compensated sense dividers, monostables on +3V3, harness design, simulation, documentation (draft)
    Activity-LED dividers: 10k / 4.7k with 12 pF / 18 pF (was 1.2k / 750R): 0.8 mA load,
    output level -2.4 mV at most (was -18 mV). U21-U23 on +3V3 (VIH 2.0 V).
    tools/signal_sim/rev2_sim.py: camera lines at 1.8 / 3.3 V, harness with IDS and EVK4
    inputs, +VCAM budget, sense dividers, In2 island gaps. docs/EVK4_HARNESS.md: harness.
    Hardware.md, README.md, JLC_ORDER.md, tool READMEs updated for Rev 2.
    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
    [PiEBV_Pico-B_Cu.gbr, PiEBV_Pico-B_Mask.gbr, PiEBV_Pico-B_Paste.gbr, PiEBV_Pico-B_Silkscreen.gbr, PiEBV_Pico-Edge_Cuts.gbr, PiEBV_Pico-F_Cu.gbr, PiEBV_Pico-F_Mask.gbr, PiEBV_Pico-F_Paste.gbr]
2026-11-12 Rev 2: board images, In2 island map, image script
    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
2026-11-12 Rev 2: on-board 47R series resistors in the camera lines, camera section routed again
    Schematic: R52-R69 (47R, 0805) between the buffer outputs and the camera header
    pins (nets Sync1_C ... TDRSTN6_C). U20 inputs swapped: VIN1 = +1V8, VIN2 = +3V3,
    MODE on +3V3, PR1 pulled up by R34; J22 pulls PR1 to GND through R35, so a fault
    at U20 or a missing Pico cannot give 3.3 V. R51 (4.7k) discharges +VCAM.
    Sense divider lower capacitor 22 pF.
    Board: resistors in the gaps between the camera headers. Rev 1 camera copper
    removed; 17 lines routed with KiCadRoutingTools, Trigger3 drawn by script.
    New tools: uuidfix.py (repeatable item order), trim.py (lengths equal by
    KiCad's reading), spokes.py (pour cu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
    [PiEBV_Pico.kicad_pcb, PiEBV_Pico.kicad_sch]
2026-11-12 Rev 2: fab package, BOM, placement file, images and simulation model for the on-board series resistors
    BOM: R51 (4.7k), R52-R69 (47R, LCSC C17714), C32/C34/C36 22 pF (C1804).
    Harness drawing: no resistors in the harness. fab.sh does not rewrite the board.
    Simulation: geometry of the header-side nets, 47R between the two parts of a camera line.
    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
    [PiEBV_Pico-B_Cu.gbr, PiEBV_Pico-B_Mask.gbr, PiEBV_Pico-B_Paste.gbr, PiEBV_Pico-B_Silkscreen.gbr, PiEBV_Pico-Edge_Cuts.gbr, PiEBV_Pico-F_Cu.gbr, PiEBV_Pico-F_Mask.gbr, PiEBV_Pico-F_Paste.gbr]
2026-11-12 Simulation device file: sense divider lower capacitor 22 pF
    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
2026-11-12 Simulation results for the final Rev 2 board (47R on board, 22 pF sense capacitors)
    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
2026-11-12 Rev 2 documents for the final board: on-board series resistors, mux wiring, routing, lengths, images
    Hardware.md, README.md, EVK4 harness (no resistors in the harness), tool READMEs,
    JLC order notes. BOM note and jogs.py docstring corrected.
    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
    [PiEBV_Pico_BOM.csv]
2026-11-12 Rev 2: review corrections on the final board
    viafix.py: 12 of 22 camera vias to 0.6 mm (clearance-checked), three track ends
    moved to their via centre. build.sh: trim count cannot stop the build, three trim
    passes. Documents: Sync stub 4.85 mm, length reading note, via note, new
    fingerprint and zip check sum. Fab package, placement file, geometry and images
    regenerated.
    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
    [PiEBV_Pico-B_Cu.gbr, PiEBV_Pico-B_Mask.gbr, PiEBV_Pico-B_Paste.gbr, PiEBV_Pico-B_Silkscreen.gbr, PiEBV_Pico-Edge_Cuts.gbr, PiEBV_Pico-F_Cu.gbr, PiEBV_Pico-F_Mask.gbr, PiEBV_Pico-F_Paste.gbr]
2026-11-12 Simulation results for the final Rev 2 board
    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
2026-11-12 Rev 2: one via size, second PR1 pull-up R70, simulation of all 18 camera lines
    Router told to make 0.6 / 0.3 mm vias; net order searched again. All 20 camera
    vias are standard. KiCad lengths: Sync 74.082 mm, Trigger 43.584 mm, TDRSTN
    51.472 mm, spread 0.000 mm in each group. DRC: 0 errors, 0 unconnected.
    R70 (10k) in parallel with R34: one open joint cannot float PR1 of U20.
    rev2_sim.py: every Sync, Trigger and TDRSTN line with its resistor and stub.
    Fab package, BOM, placement file and images regenerated.
    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
    [PiEBV_Pico-B_Cu.gbr, PiEBV_Pico-B_Mask.gbr, PiEBV_Pico-B_Paste.gbr, PiEBV_Pico-B_Silkscreen.gbr, PiEBV_Pico-Edge_Cuts.gbr, PiEBV_Pico-F_Cu.gbr, PiEBV_Pico-F_Mask.gbr, PiEBV_Pico-F_Paste.gbr]
2026-11-12 Main simulation results for the final Rev 2 board
    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
2026-11-12 Rev 2 simulation results: all 18 camera lines
    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
2026-11-12 Rev 2 documents for the final board: one via size, R70, data sheet facts, all-lines simulation
    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
2026-11-12 JLC placement file: rotations of the new polarised parts corrected with tools/jlc_cpl
    The tool read JLC's footprint of all 149 parts. Corrections: D1, D2, D6, Q1, Q2,
    U20, U21-U23. Rev 1 part rows unchanged. Order notes and documents updated.
    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
    [PiEBV_Pico_JLC_CPL.csv]
2026-11-14 Rev 2: copyright and licence mark on the front silkscreen
    Text: 'PiEBV Rev 2 (C) 2026 Louis M. Edelman, Chris Willert' and 'GPL-3.0',
    lower left. Copper unchanged (same fingerprint); DRC clean. README licence line
    corrected to GPL v3 (it said MIT; the LICENSE file is GPL v3). Gerbers, zip and
    images regenerated.
    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
    [PiEBV_Pico-B_Cu.gbr, PiEBV_Pico-B_Mask.gbr, PiEBV_Pico-B_Paste.gbr, PiEBV_Pico-B_Silkscreen.gbr, PiEBV_Pico-Edge_Cuts.gbr, PiEBV_Pico-F_Cu.gbr, PiEBV_Pico-F_Mask.gbr, PiEBV_Pico-F_Paste.gbr]
